grim0000/oreo/docs/img/cad_bottom_cover.png

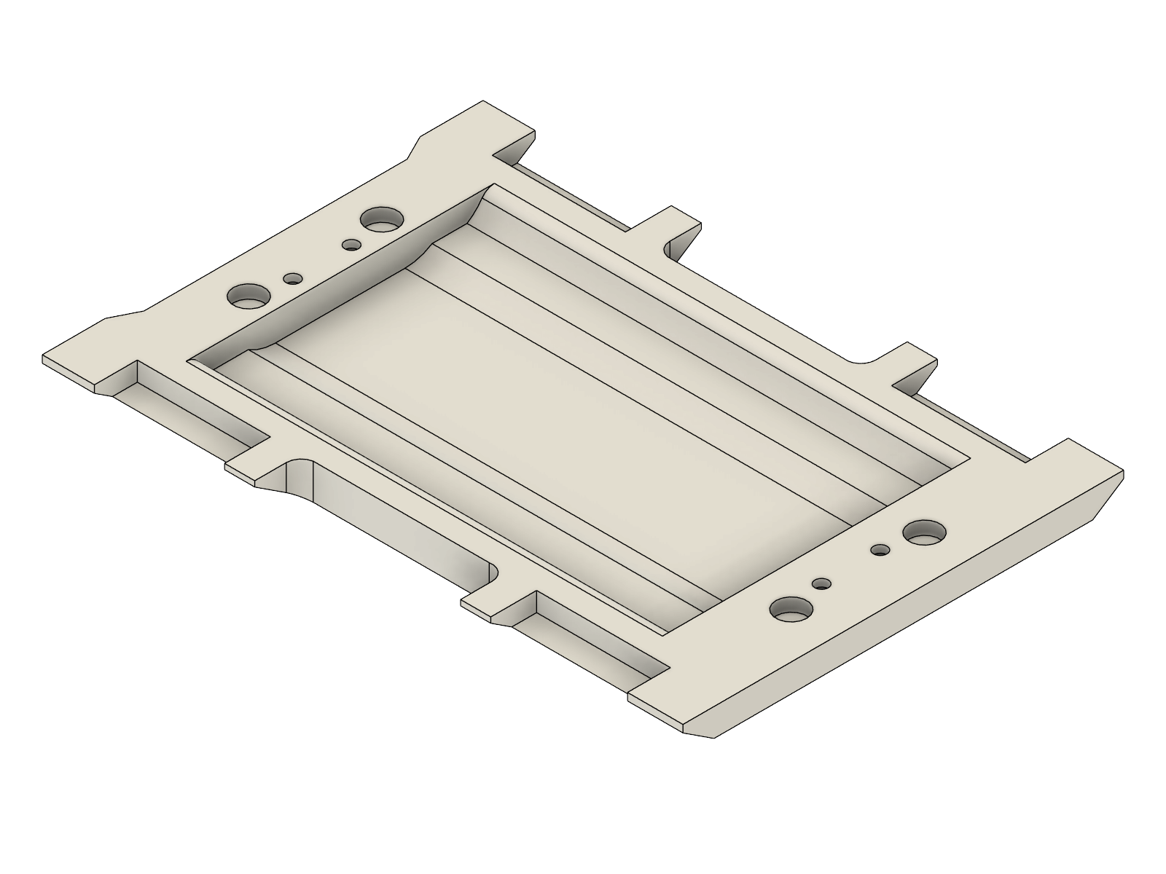
docs/img/cad_bottom_cover.png
