grim0000/oreo/docs/img/cad_chassis_cavity.png

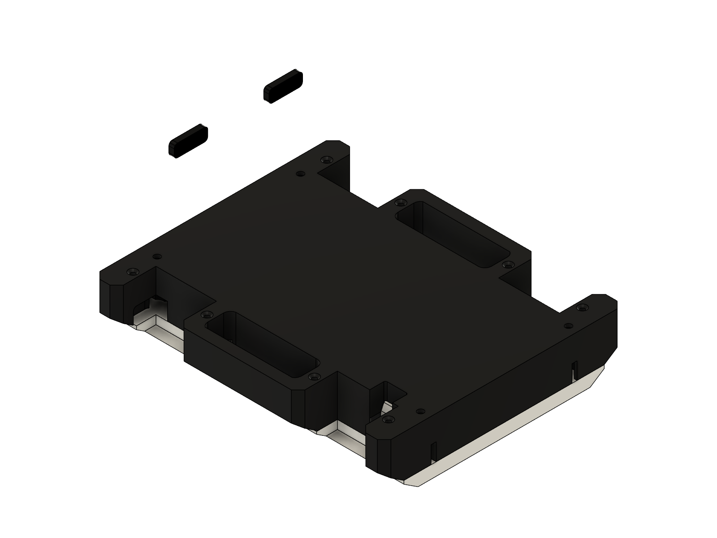
docs/img/cad_chassis_cavity.png
