grim0000/oreo/docs/img/cad_chassis_cavity_top.png

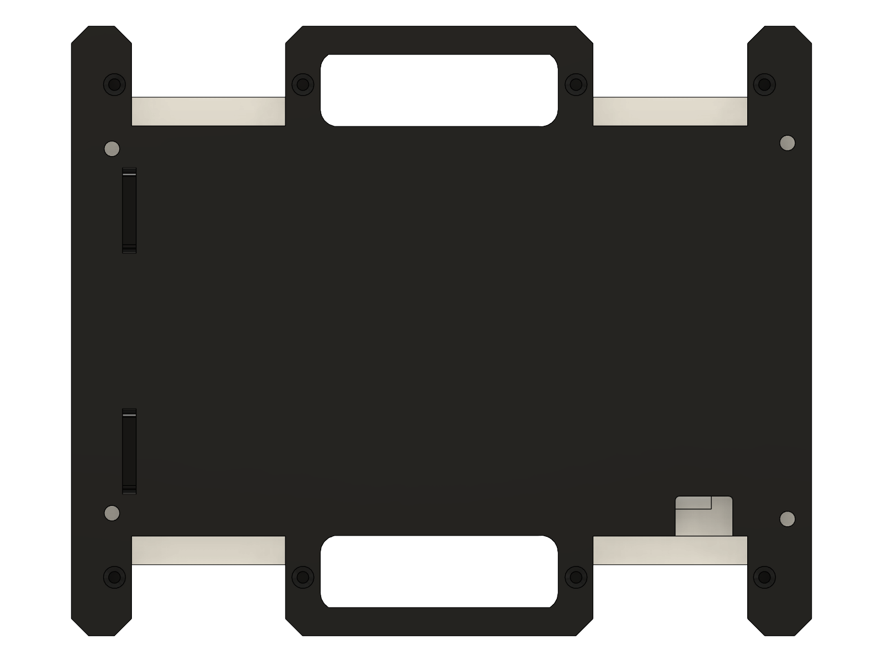
docs/img/cad_chassis_cavity_top.png
