grim0000/oreo/docs/img/cad_chassis_shell_top.png

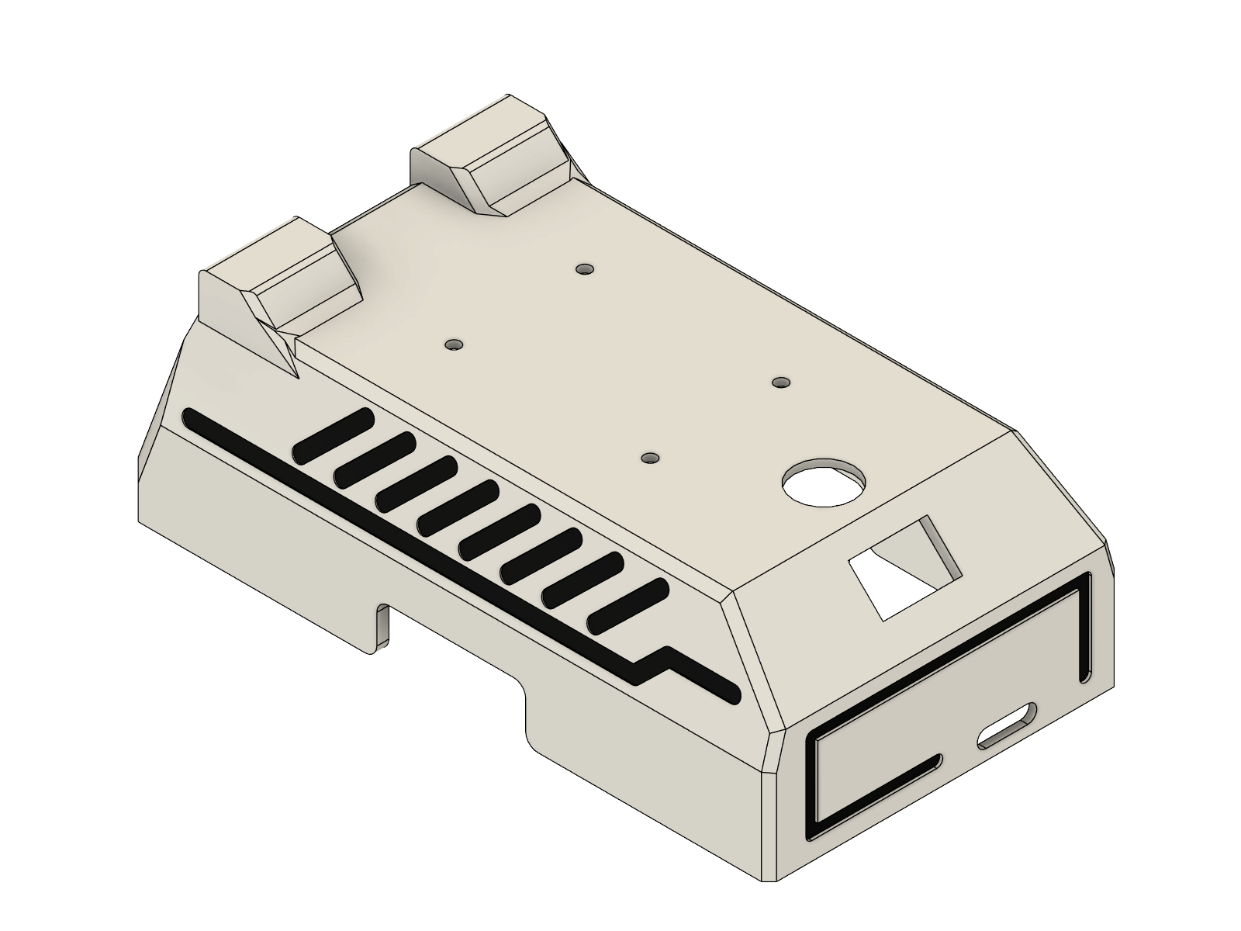
docs/img/cad_chassis_shell_top.png
