grim0000/oreo/docs/img/cad_chassis_shell_under.png

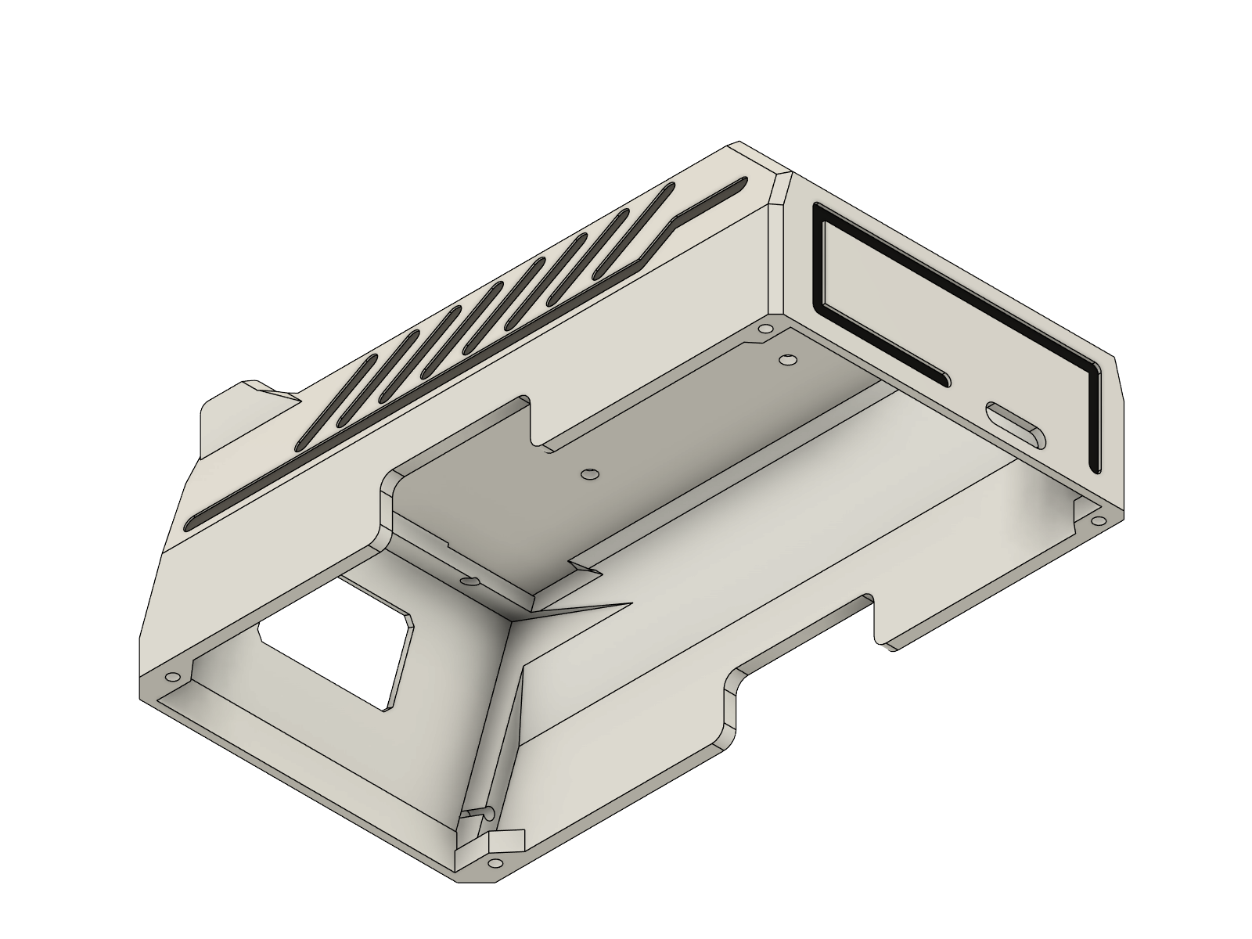
docs/img/cad_chassis_shell_under.png
