grim0000/oreo/docs/img/cad_head_back.png

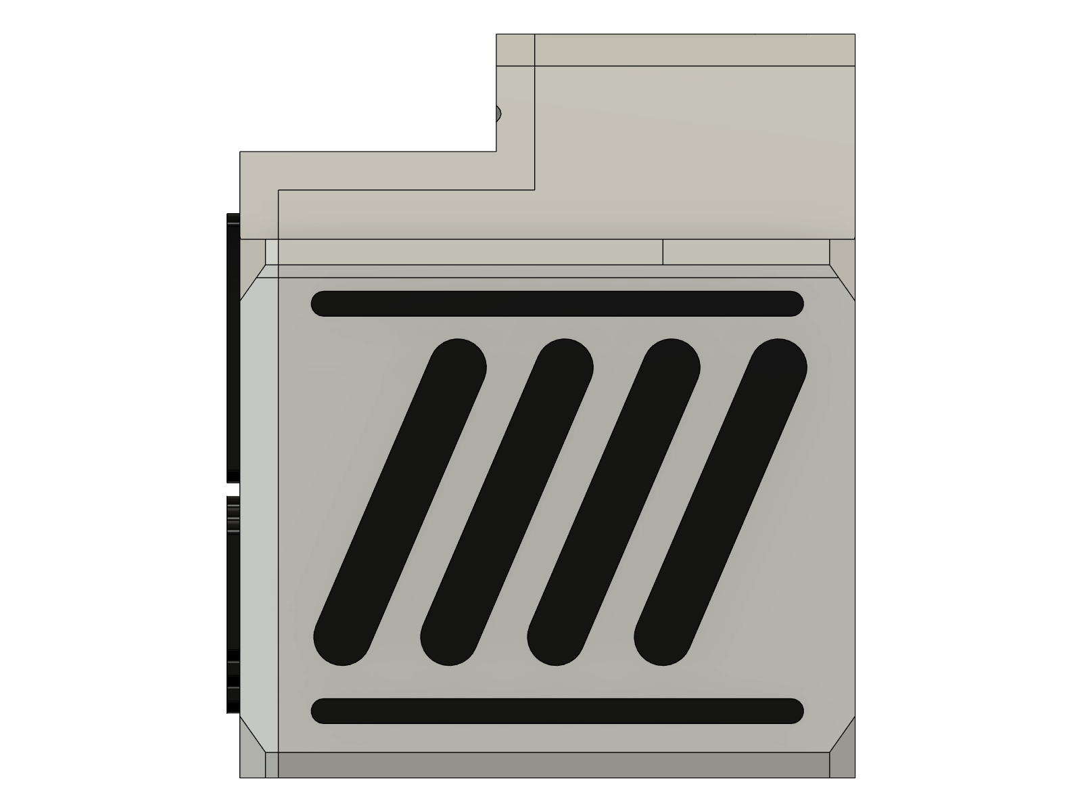
docs/img/cad_head_back.png
