grim0000/oreo/docs/img/cad_head_bottom.png

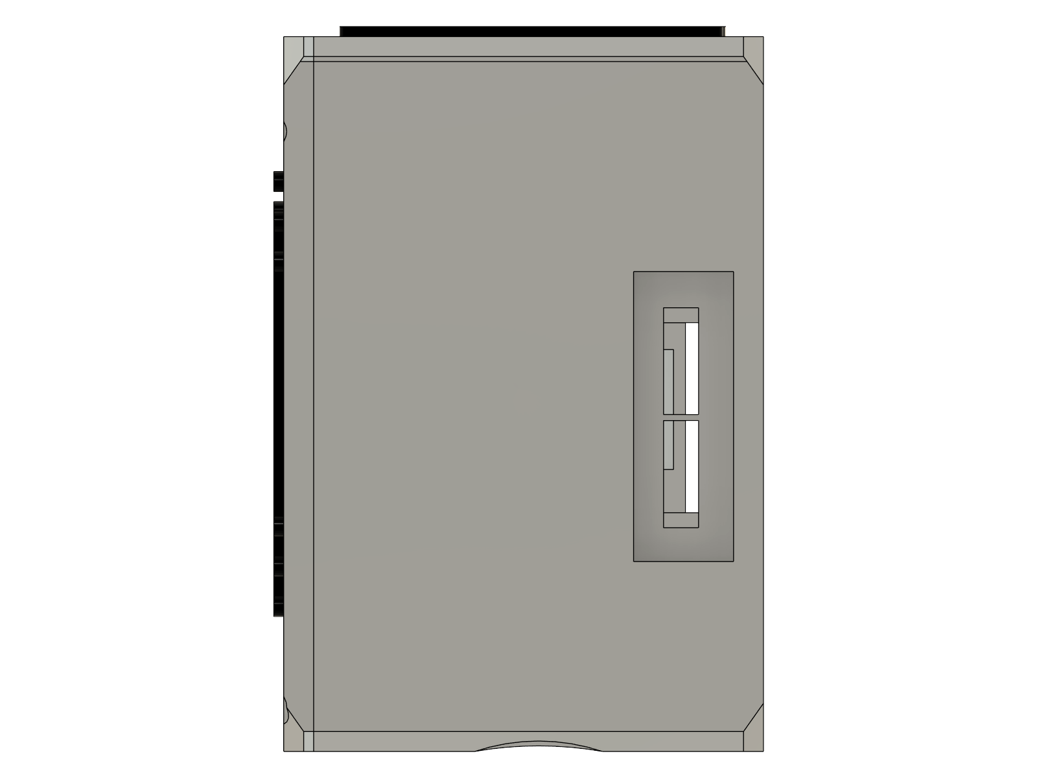
docs/img/cad_head_bottom.png
