grim0000/oreo/docs/img/cad_head_left.png

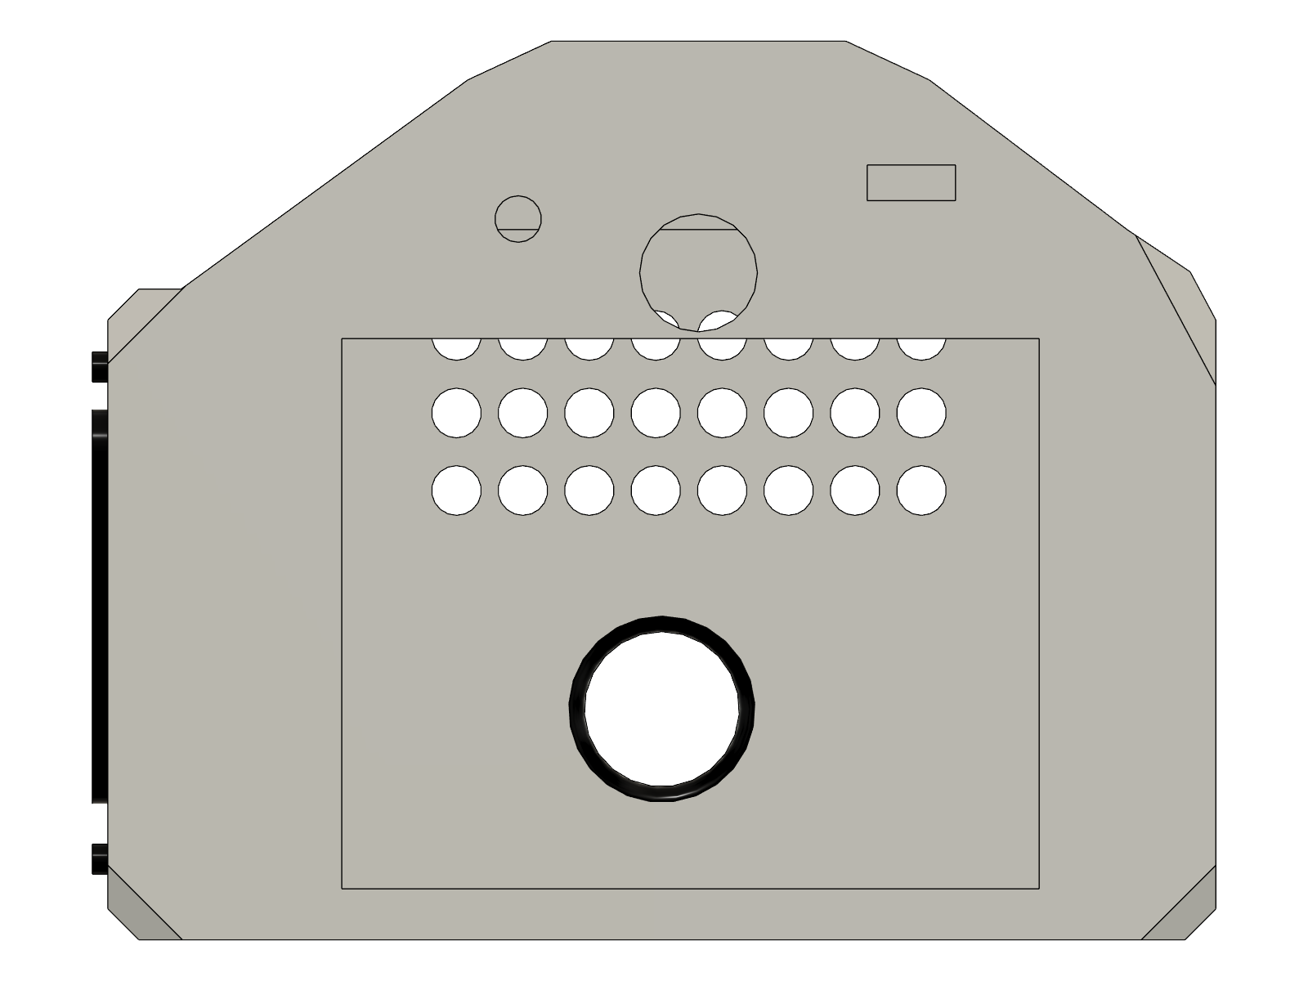
docs/img/cad_head_left.png
