grim0000/oreo/docs/img/cad_head_right.png

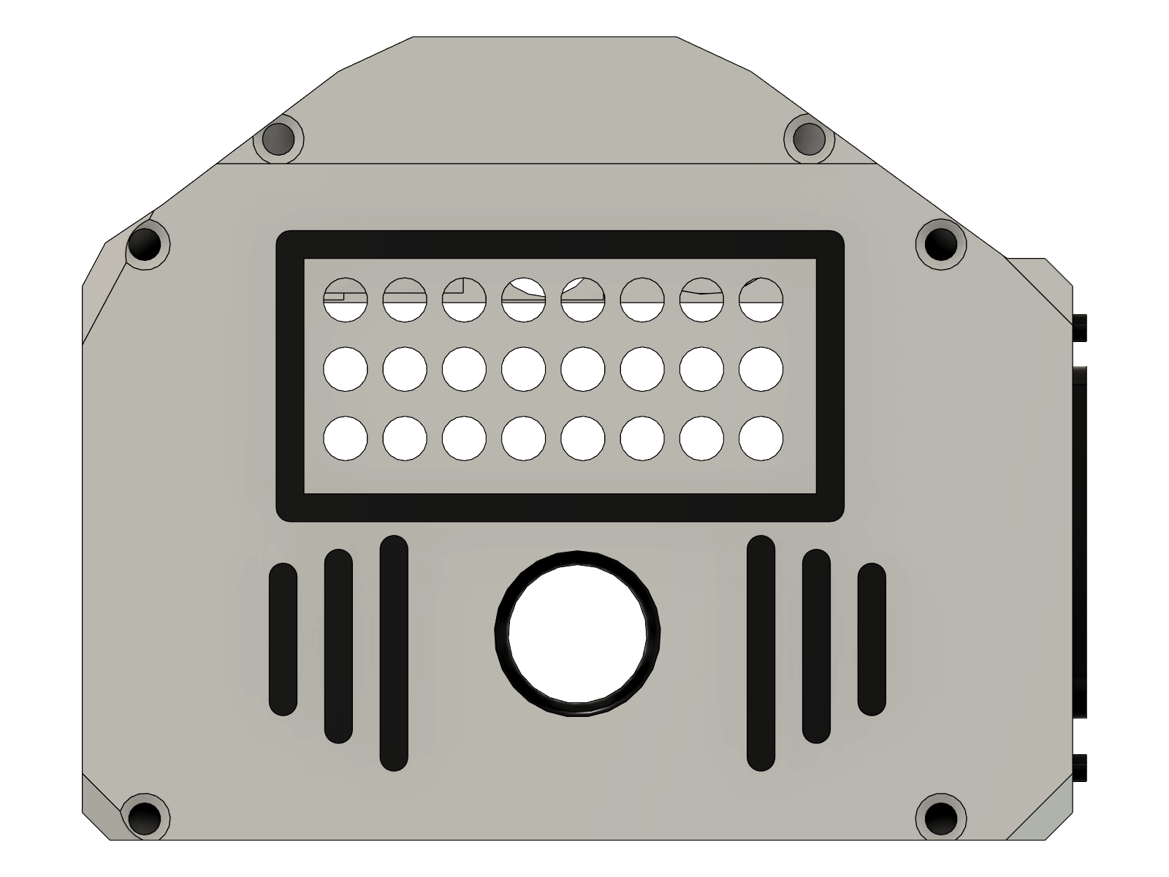
docs/img/cad_head_right.png
