grim0000/oreo/docs/img/cad_legs.png

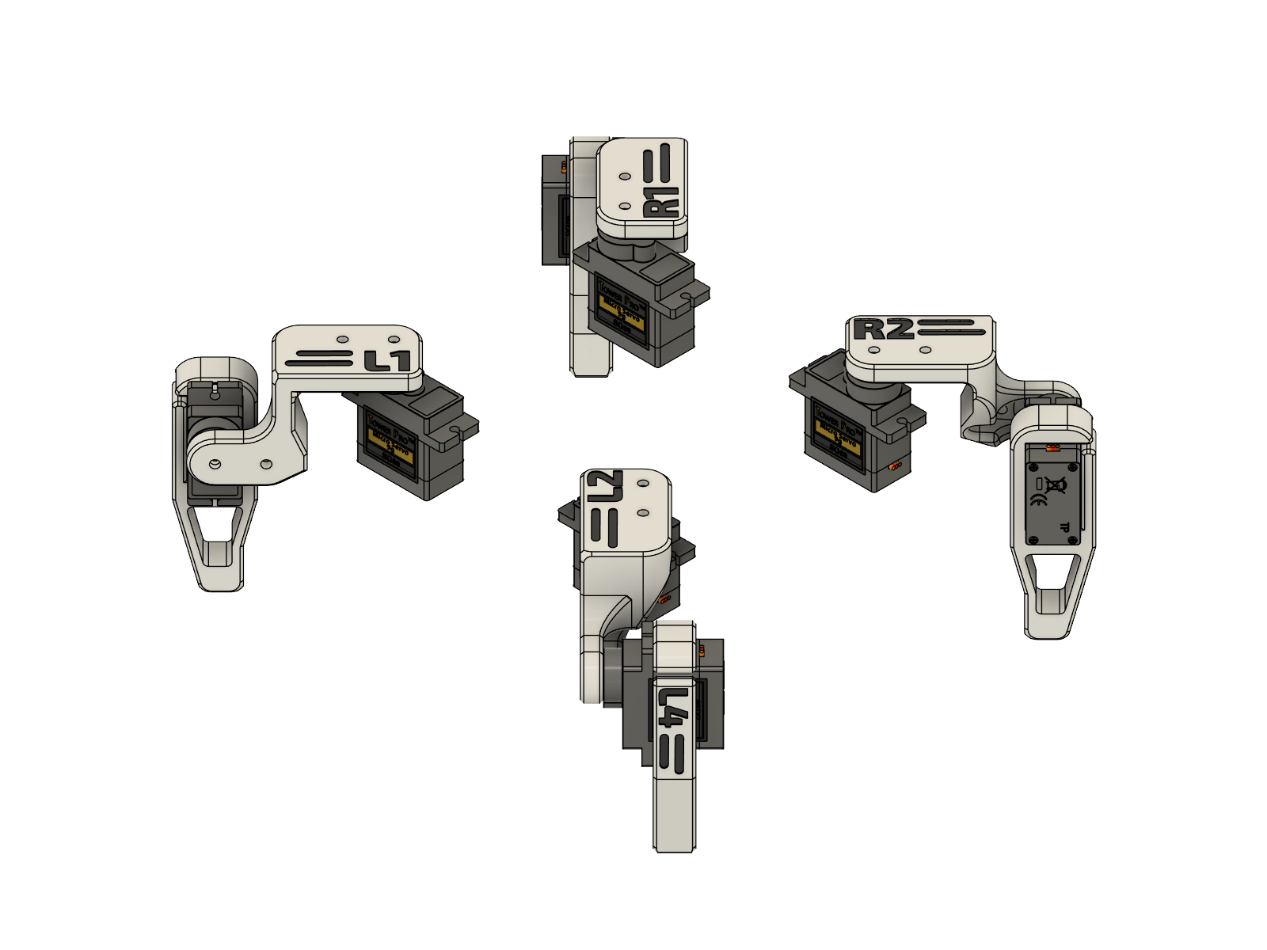
docs/img/cad_legs.png
