grim0000/oreo/docs/img/cad_neck.png

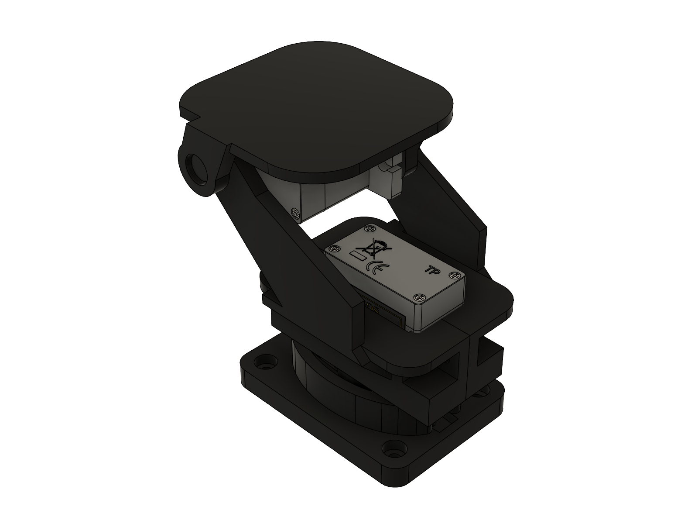
docs/img/cad_neck.png
