grim0000/oreo/docs/img/cad_oreo_front.png

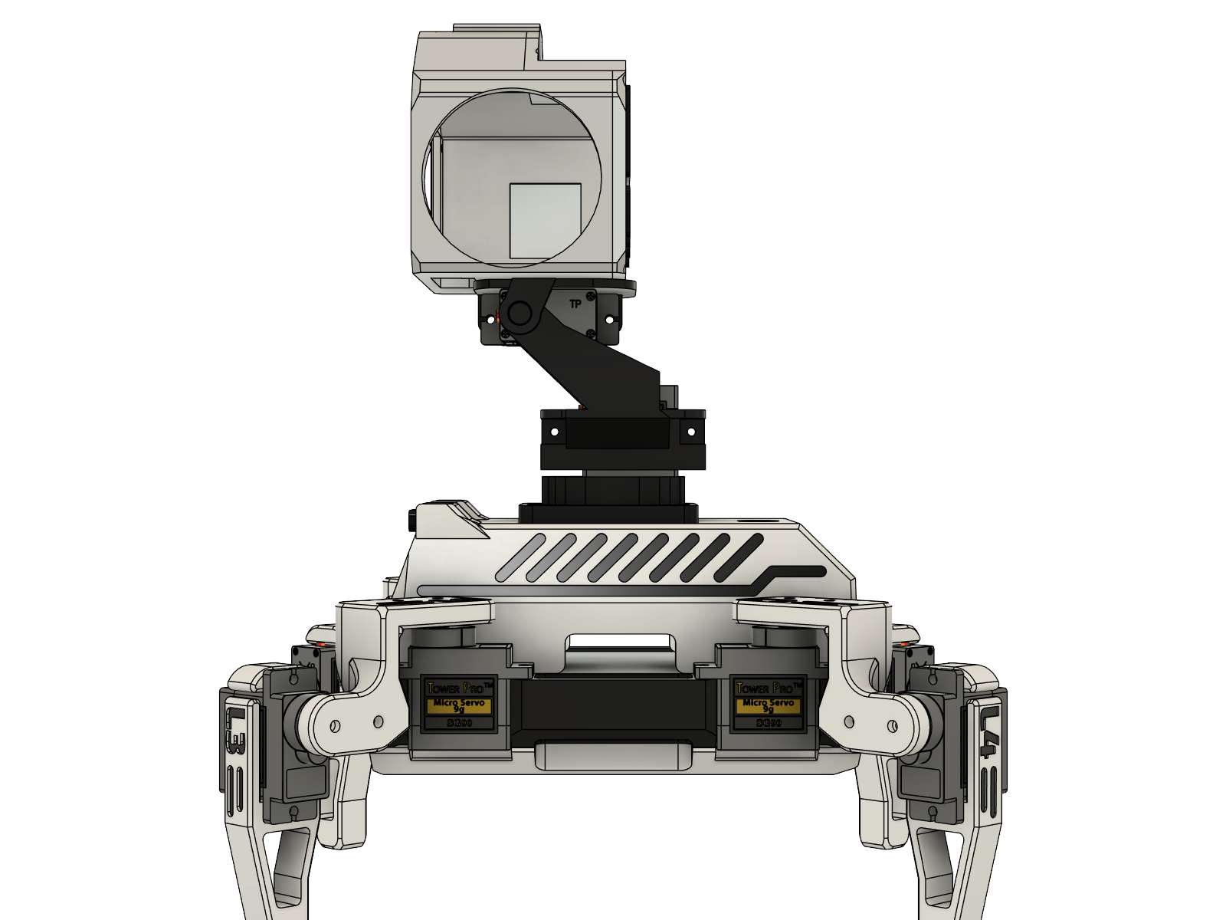
docs/img/cad_oreo_front.png
