grim0000/oreo/docs/img/cad_oreo_side.png

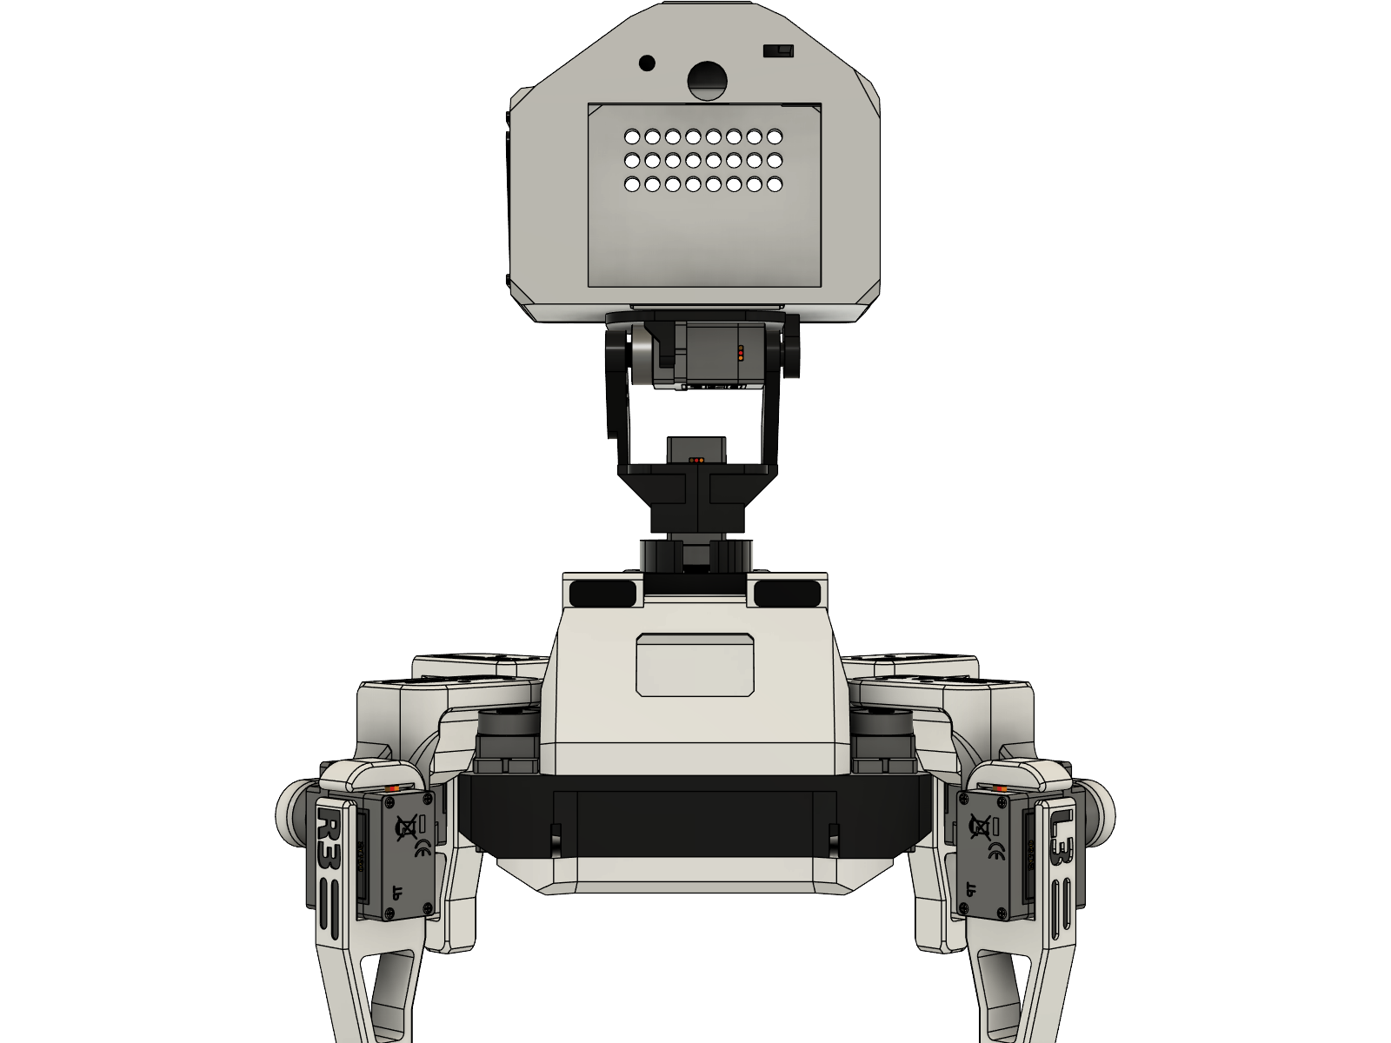
docs/img/cad_oreo_side.png
