grim0000/oreo/docs/tools/module_png/amp.png

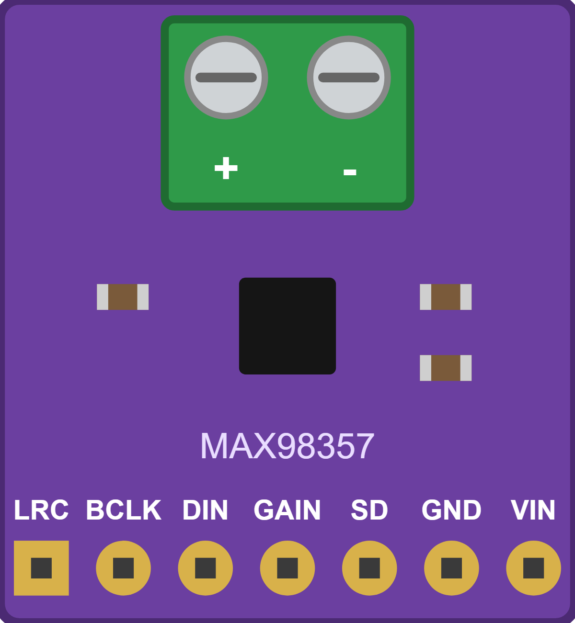
docs/tools/module_png/amp.png
