grim0000/oreo/docs/tools/module_png/battery.png

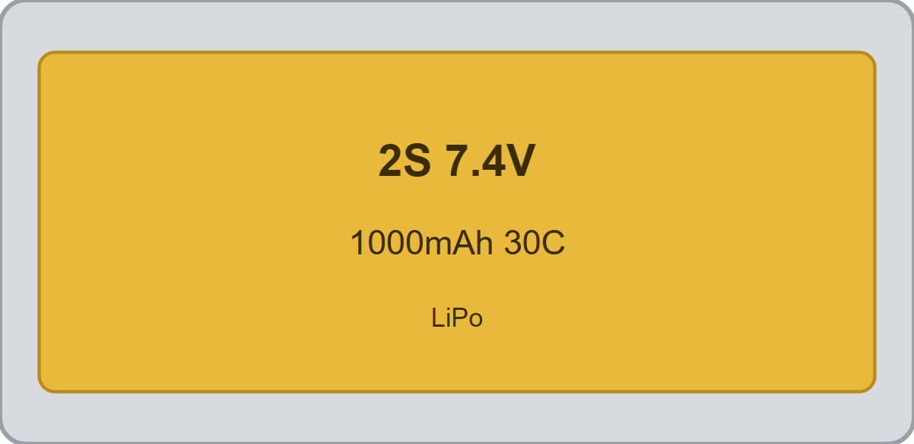
docs/tools/module_png/battery.png
