grim0000/oreo/docs/tools/module_png/bms.png

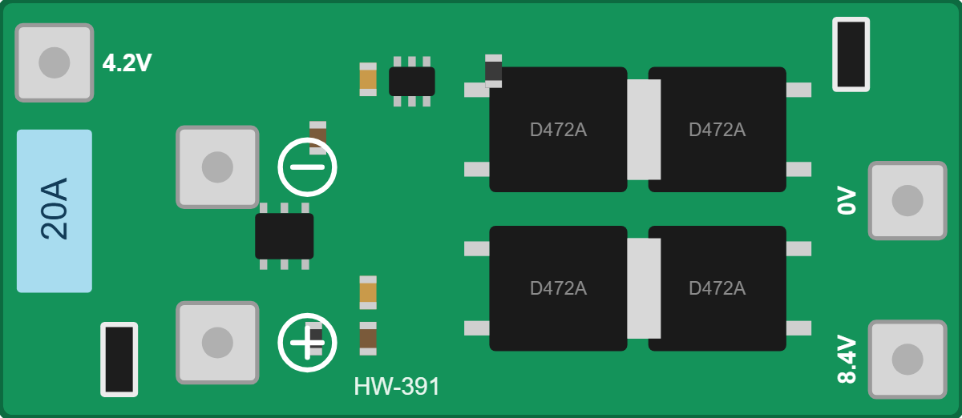
docs/tools/module_png/bms.png
