grim0000/oreo/docs/tools/module_png/buck5v.png

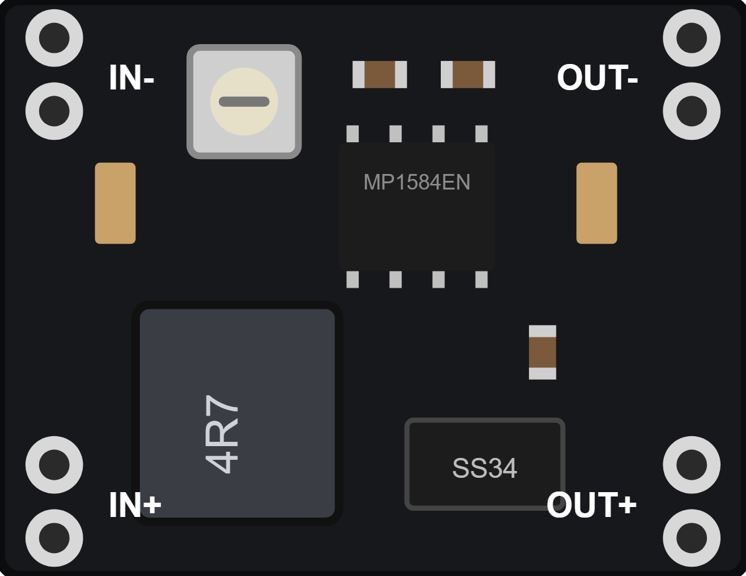
docs/tools/module_png/buck5v.png
