grim0000/oreo/docs/tools/module_png/charger.png

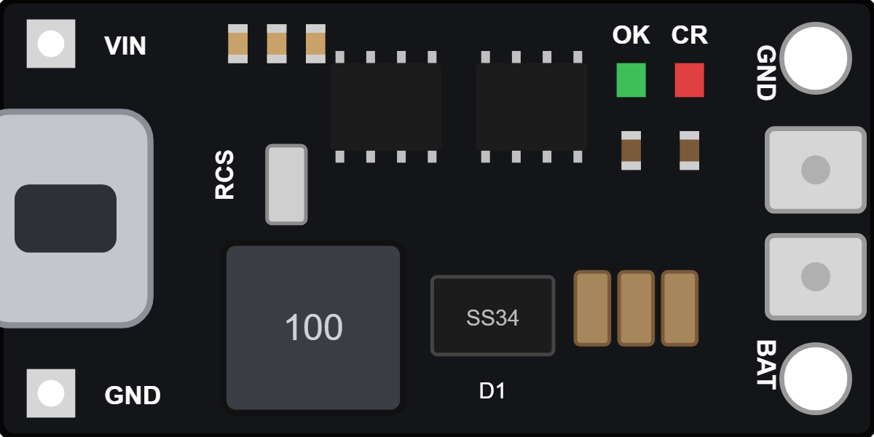
docs/tools/module_png/charger.png
