grim0000/oreo/docs/tools/module_png/display_back.png

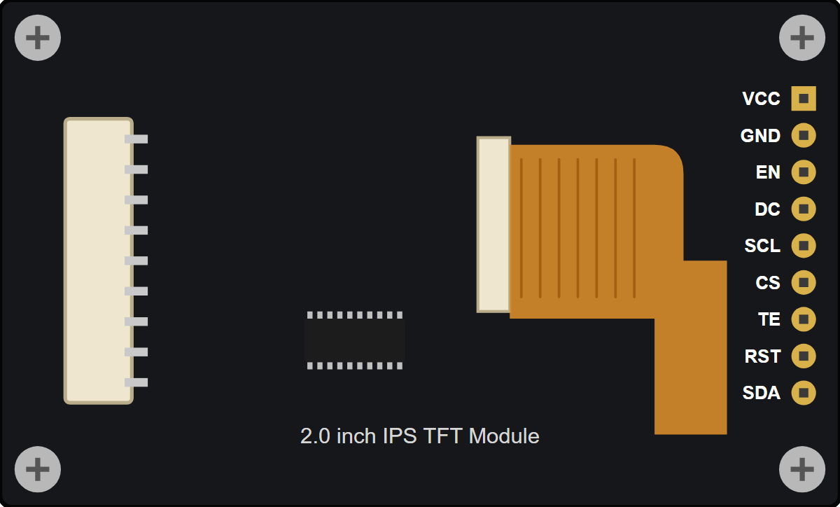
docs/tools/module_png/display_back.png
