grim0000/oreo/docs/tools/module_png/mpu6050.png

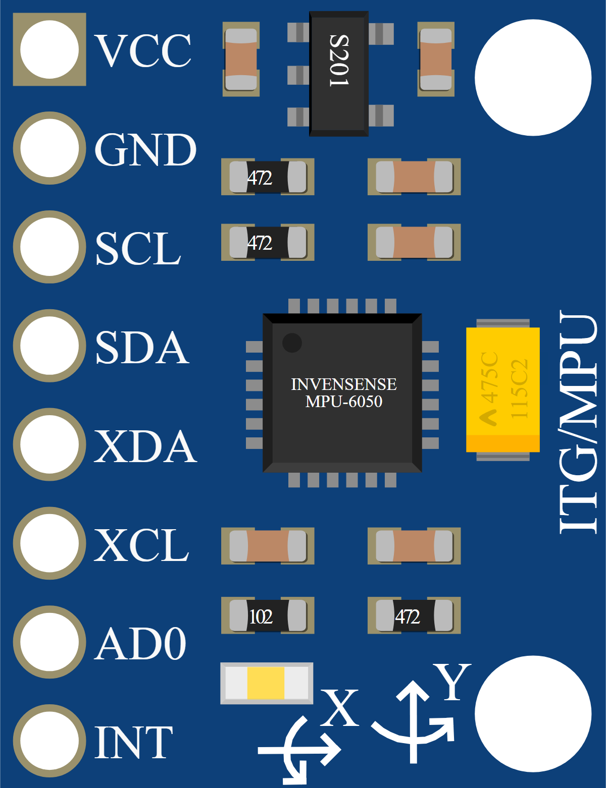
docs/tools/module_png/mpu6050.png
