grim0000/oreo/docs/tools/module_png/oled.png

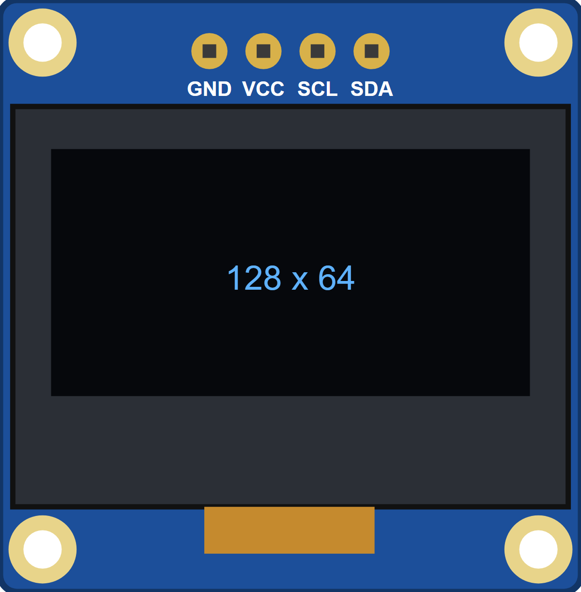
docs/tools/module_png/oled.png
