grim0000/oreo/docs/tools/module_png/pca9685.png

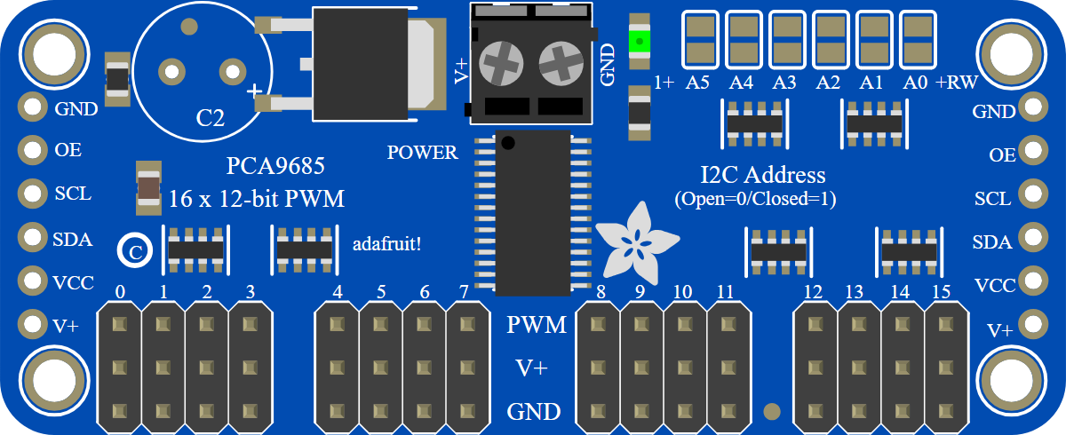
docs/tools/module_png/pca9685.png
