grim0000/oreo/docs/tools/module_png/pca9685_g.png

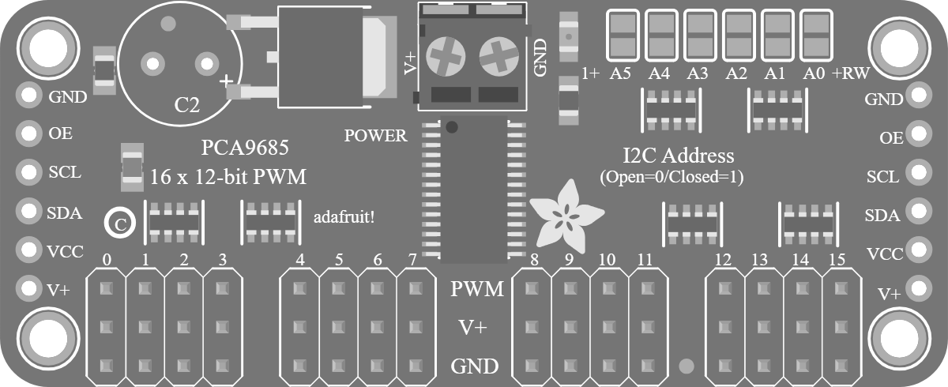
docs/tools/module_png/pca9685_g.png
