grim0000/oreo/docs/tools/module_png/rocker.png

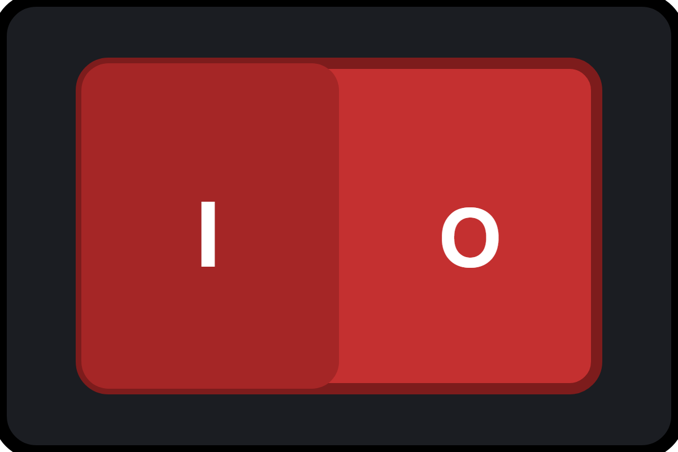
docs/tools/module_png/rocker.png
