grim0000/oreo/docs/tools/module_png/s3.png

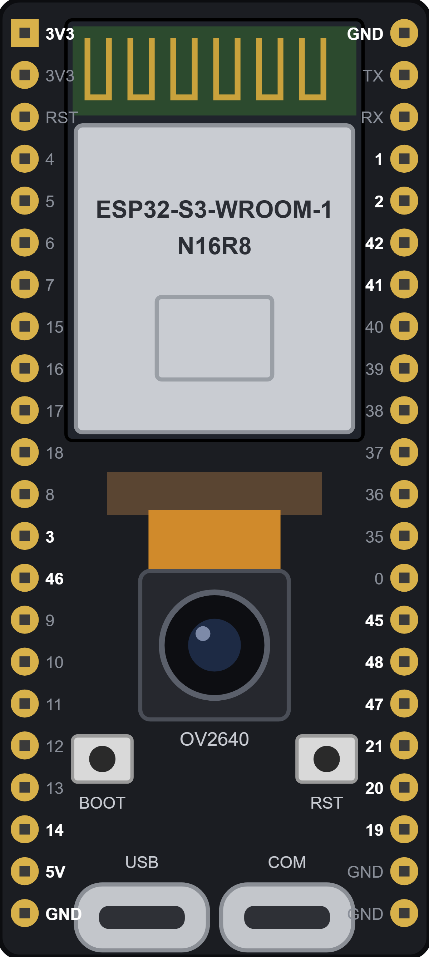
docs/tools/module_png/s3.png
