grim0000/oreo/docs/tools/module_png/tof.png

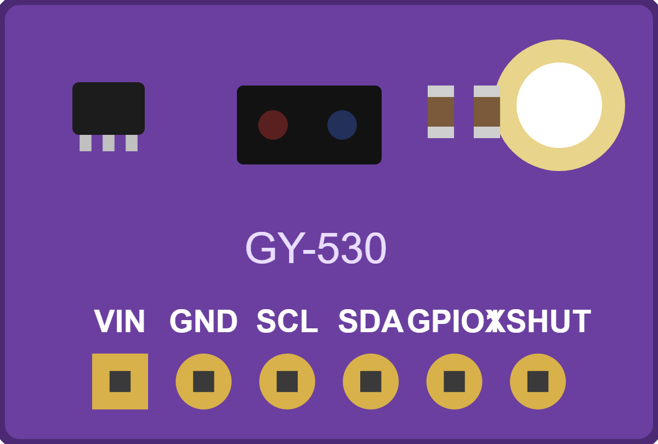
docs/tools/module_png/tof.png
