grim0000/oreo/docs/tools/module_png/touch.png

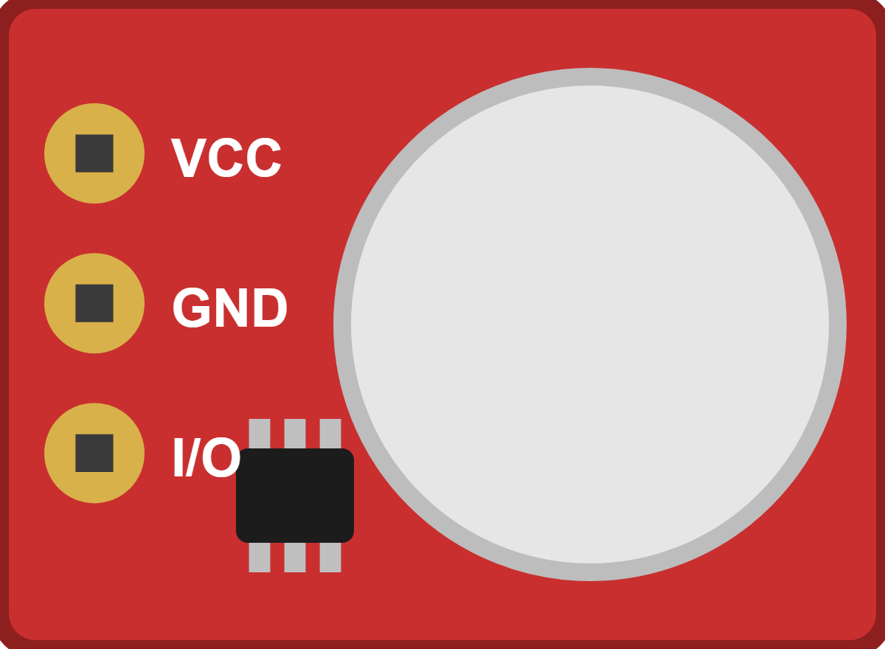
docs/tools/module_png/touch.png
