grim0000/oreo/docs/tools/module_png/xl4015.png

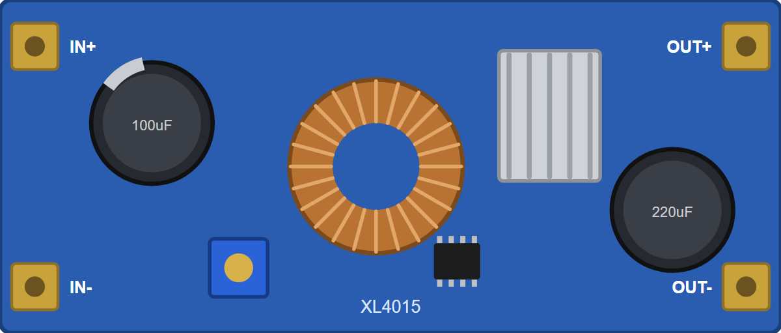
docs/tools/module_png/xl4015.png
