grim0000/oreo/firmware/assets/sprites.webp

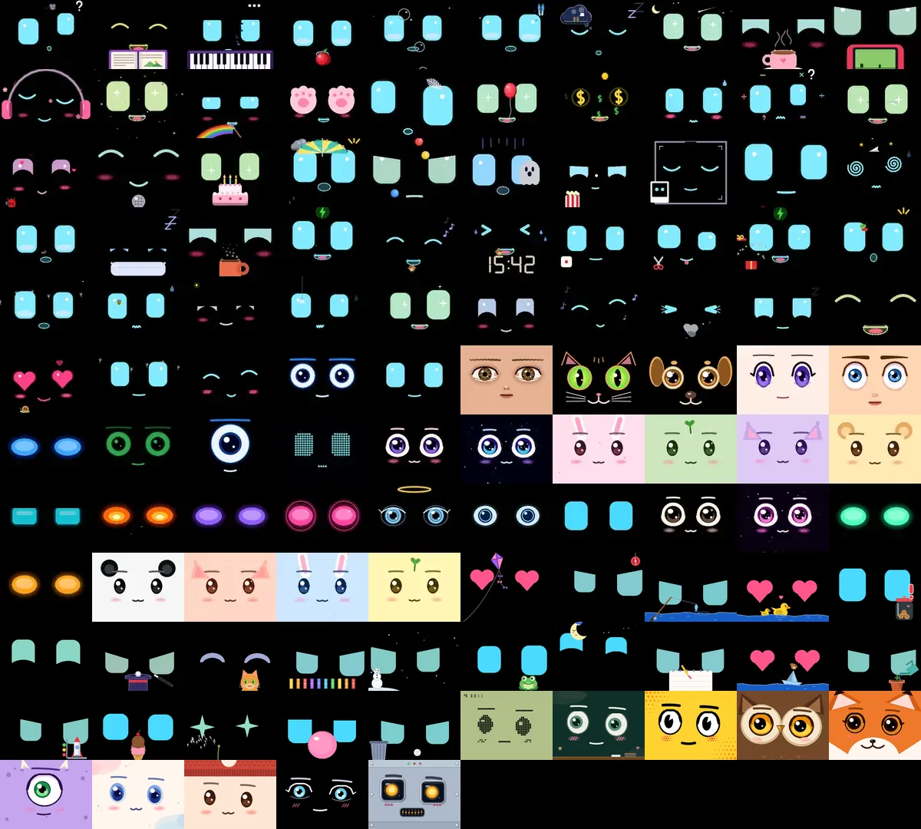
firmware/assets/sprites.webp
