grim0000/oreo/hardware/assembly_parts/neck_pan_bracket.stl

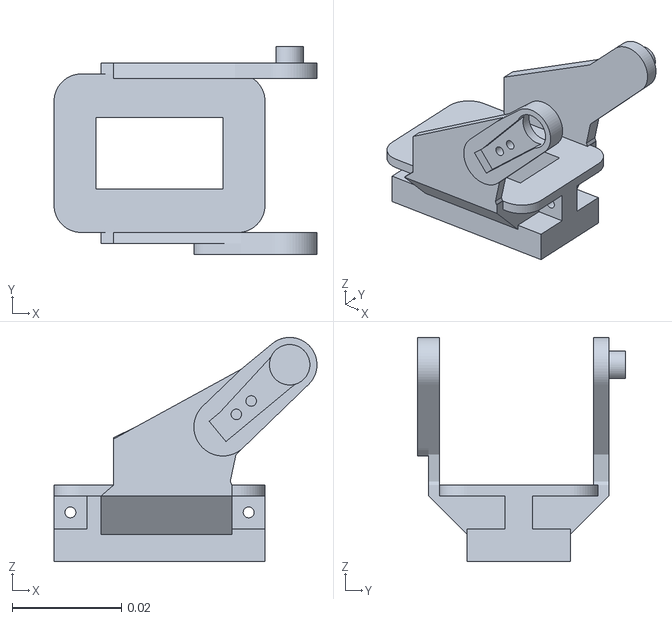
[picture p49: CAD file, 2026-11-04]
hardware/assembly_parts/neck_pan_bracket.stl
0.0481 x 0.038 x 0.041
