grim0000/oreo/hardware/assembly_parts/servos_reference/hip_servo_4.stl

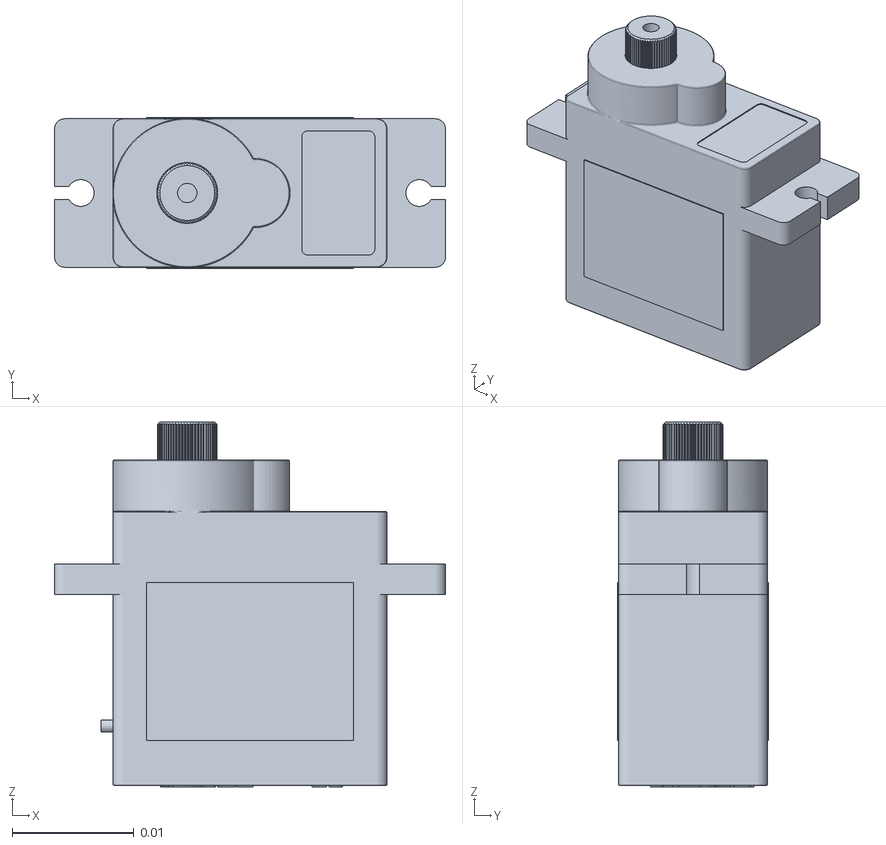
[picture p50: CAD file, 2026-10-31]
hardware/assembly_parts/servos_reference/hip_servo_4.stl
0.0321 x 0.0124 x 0.03
