grim0000/oreo/hardware/Oreo_all_parts.3mf

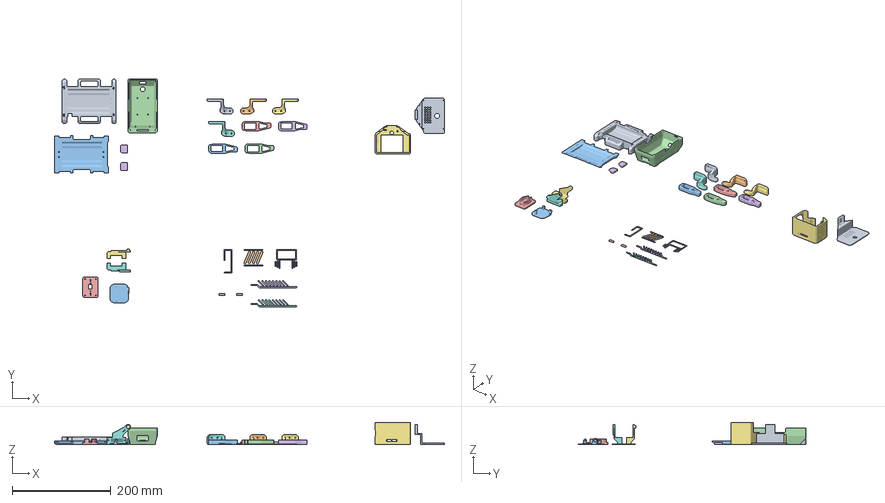
[picture p51: CAD file, 2026-11-04]
hardware/Oreo_all_parts.3mf
788.4 x 460.4 x 45.0 mm
head_shell
head_side_plate
neck_tilt_plate
top_shell_A
neck_base
chest_strips_left
head_front_plate
chest_strips_right
middle_block
head_bezel
bottom_cover
chest_back_plate
chassis_trim
top_shell_B
FR_femur
FL_femur
RR_femur
RL_femur
FR_foot
FL_foot
RR_foot
RL_foot
neck_pan_bracket_1
neck_pan_bracket_2
