grim0000/oreo/hardware/assembly_parts/FR_foot.stl

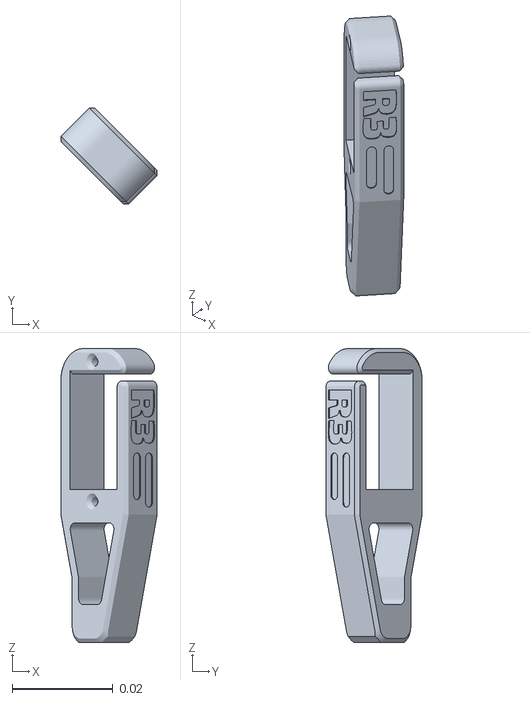
[picture p52: CAD file, 2026-11-02]
hardware/assembly_parts/FR_foot.stl
0.0191 x 0.0191 x 0.0584
