grim0000/oreo/hardware/assembly_parts/servos_reference/FL_knee_servo.stl

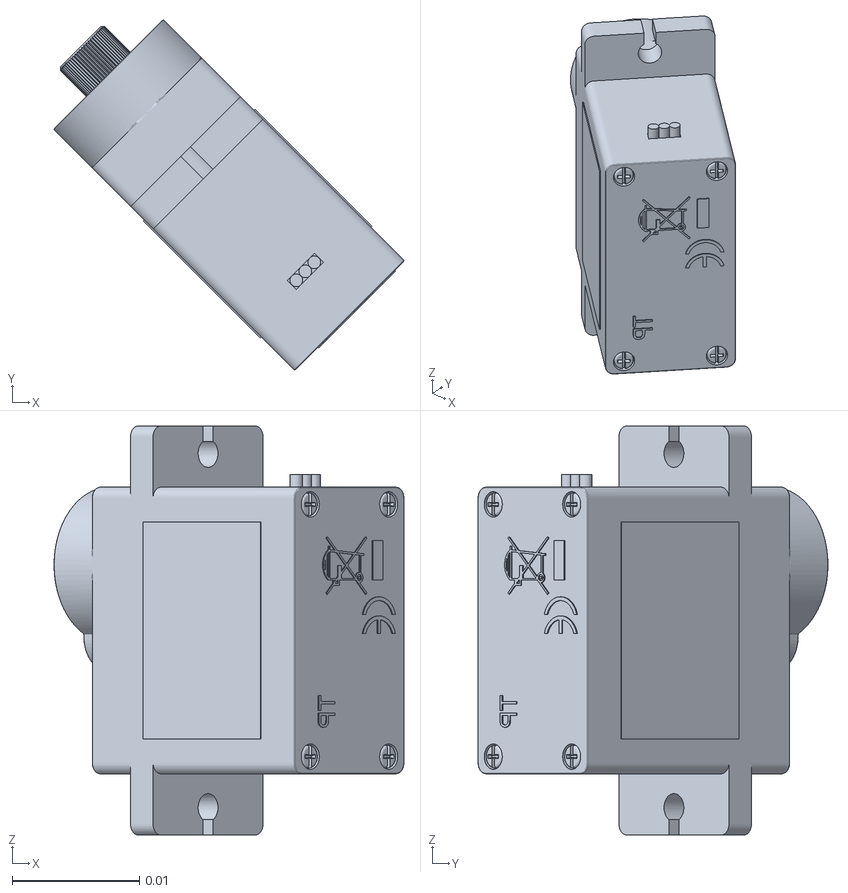
[picture p53: CAD file, 2026-10-31]
hardware/assembly_parts/servos_reference/FL_knee_servo.stl
0.0275 x 0.0275 x 0.0321
