grim0000/oreo/hardware/assembly_parts/servos_reference/tilt_servo.stl

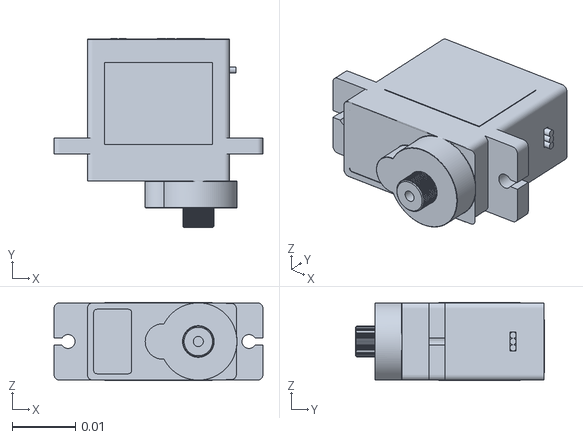
[picture p54: CAD file, 2026-10-31]
hardware/assembly_parts/servos_reference/tilt_servo.stl
0.033 x 0.0299 x 0.0124
