grim0000/oreo/hardware/assembly_parts/FR_femur.stl

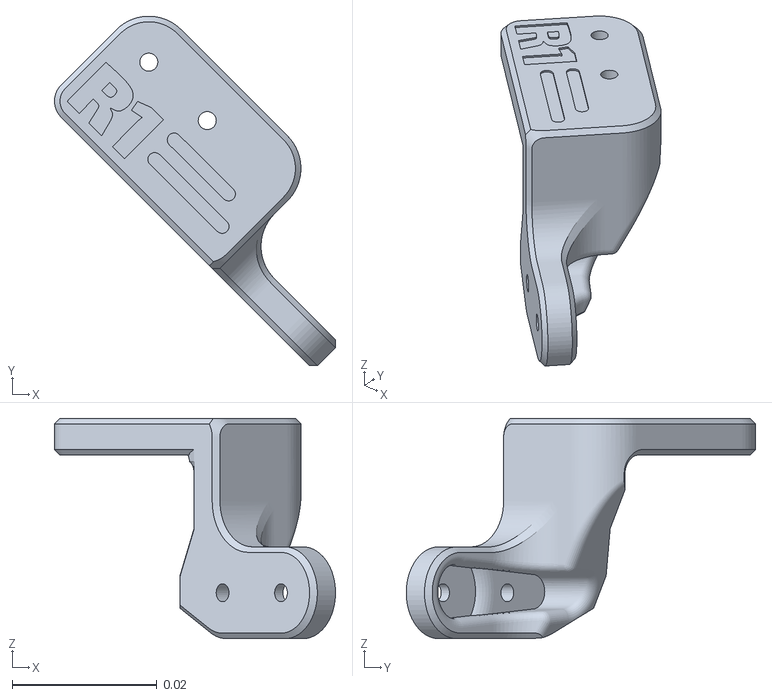
[picture p55: CAD file, 2026-11-02]
hardware/assembly_parts/FR_femur.stl
0.0389 x 0.0483 x 0.0305
