grim0000/oreo/hardware/assembly_parts/head_side_plate.stl

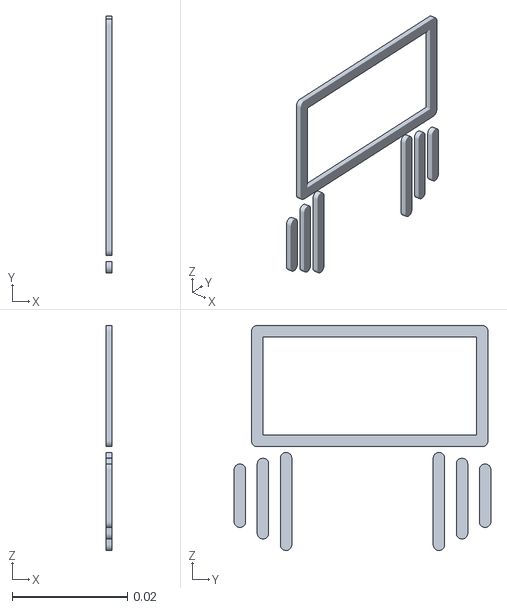
[picture p56: CAD file, 2026-10-31]
hardware/assembly_parts/head_side_plate.stl
0.001 x 0.0445 x 0.039
