grim0000/oreo/hardware/assembly_parts/top_shell.stl

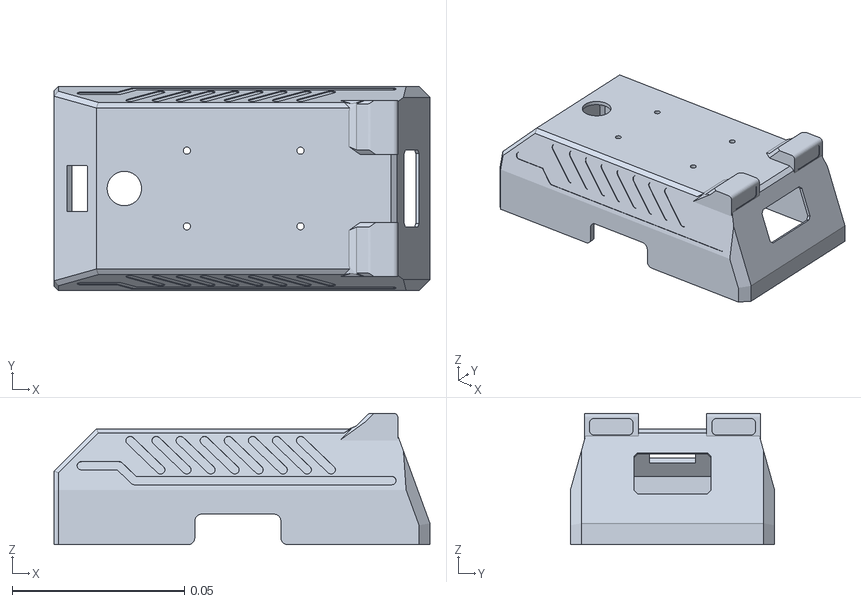
[picture p57: CAD file, 2026-10-31]
hardware/assembly_parts/top_shell.stl
0.109 x 0.0593 x 0.0382
