grim0000/oreo/hardware/assembly_parts/chest_back_plate.stl

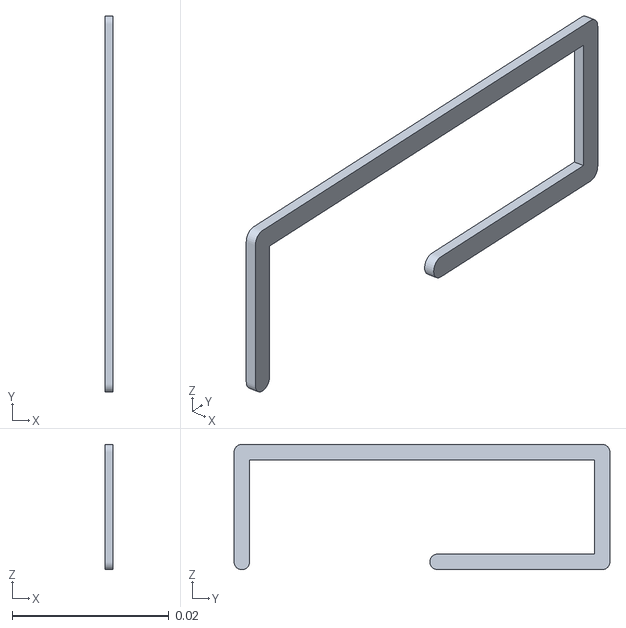
[picture p58: CAD file, 2026-10-31]
hardware/assembly_parts/chest_back_plate.stl
0.001 x 0.048 x 0.016
