grim0000/oreo/hardware/assembly_parts/chest_strips_right.stl

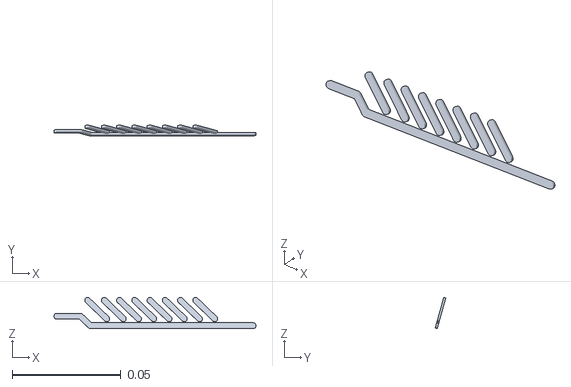
[picture p59: CAD file, 2026-10-31]
hardware/assembly_parts/chest_strips_right.stl
0.0927 x 0.00492 x 0.0143
