grim0000/oreo/hardware/assembly_parts/neck_tilt_plate.stl

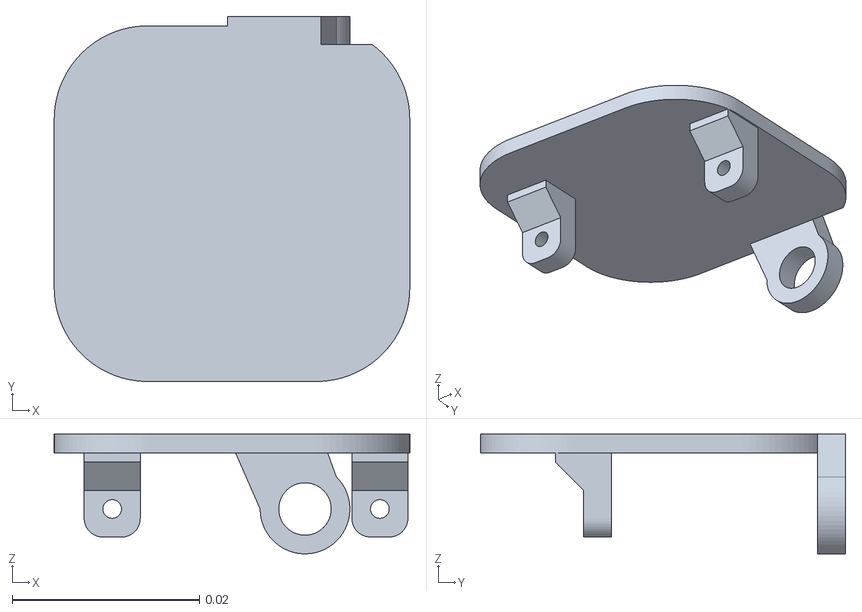
[picture p60: CAD file, 2026-10-31]
hardware/assembly_parts/neck_tilt_plate.stl
0.038 x 0.039 x 0.0128
