grim0000/oreo/hardware/assembly_parts/middle_block.stl

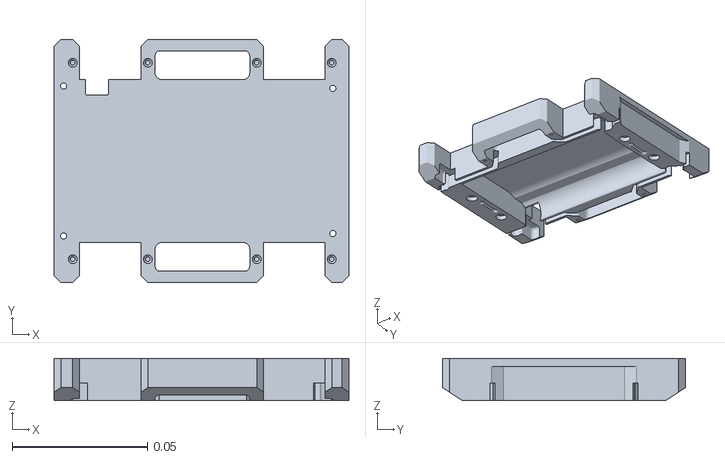
[picture p61: CAD file, 2026-10-31]
hardware/assembly_parts/middle_block.stl
0.109 x 0.09 x 0.0157
