grim0000/oreo/hardware/assembly_parts/head_shell.stl

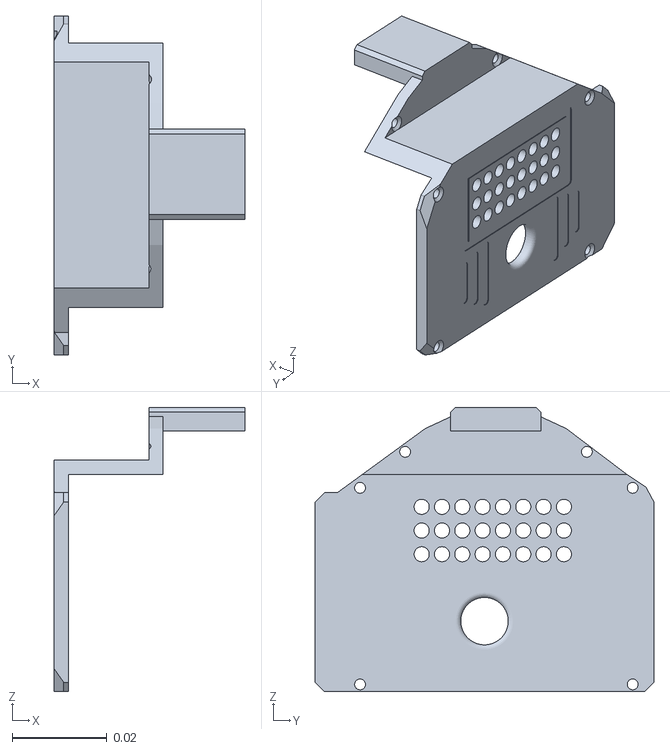
[picture p62: CAD file, 2026-10-31]
hardware/assembly_parts/head_shell.stl
0.0402 x 0.0715 x 0.06
