grim0000/oreo/hardware/assembly_parts/head_front_plate.stl

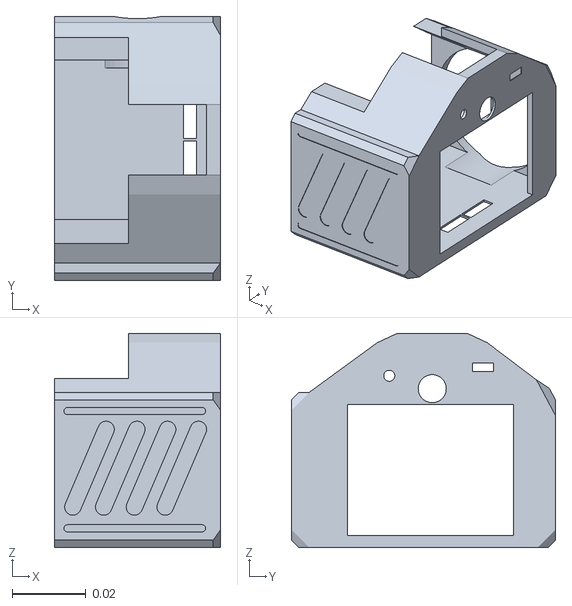
[picture p63: CAD file, 2026-10-31]
hardware/assembly_parts/head_front_plate.stl
0.045 x 0.0715 x 0.058
