grim0000/oreo/hardware/assembly_parts/neck_base.stl

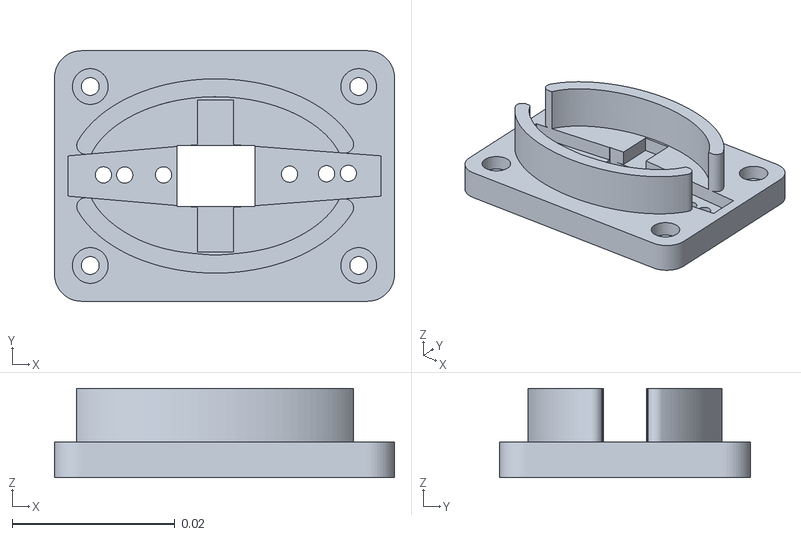
[picture p64: CAD file, 2026-10-31]
hardware/assembly_parts/neck_base.stl
0.0418 x 0.0308 x 0.011
