grim0000/oreo/hardware/assembly_parts/bottom_cover.stl

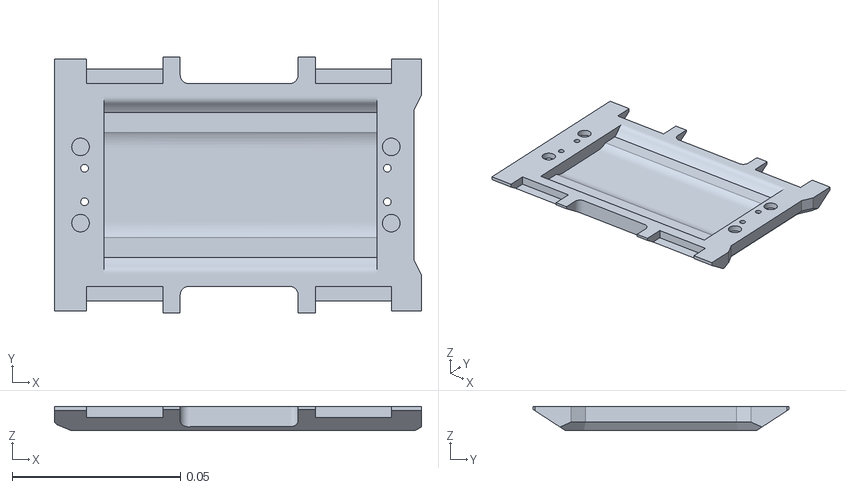
[picture p65: CAD file, 2026-10-31]
hardware/assembly_parts/bottom_cover.stl
0.109 x 0.0762 x 0.00727
