grim0000/oreo/hardware/assembly_parts/chassis_trim.stl

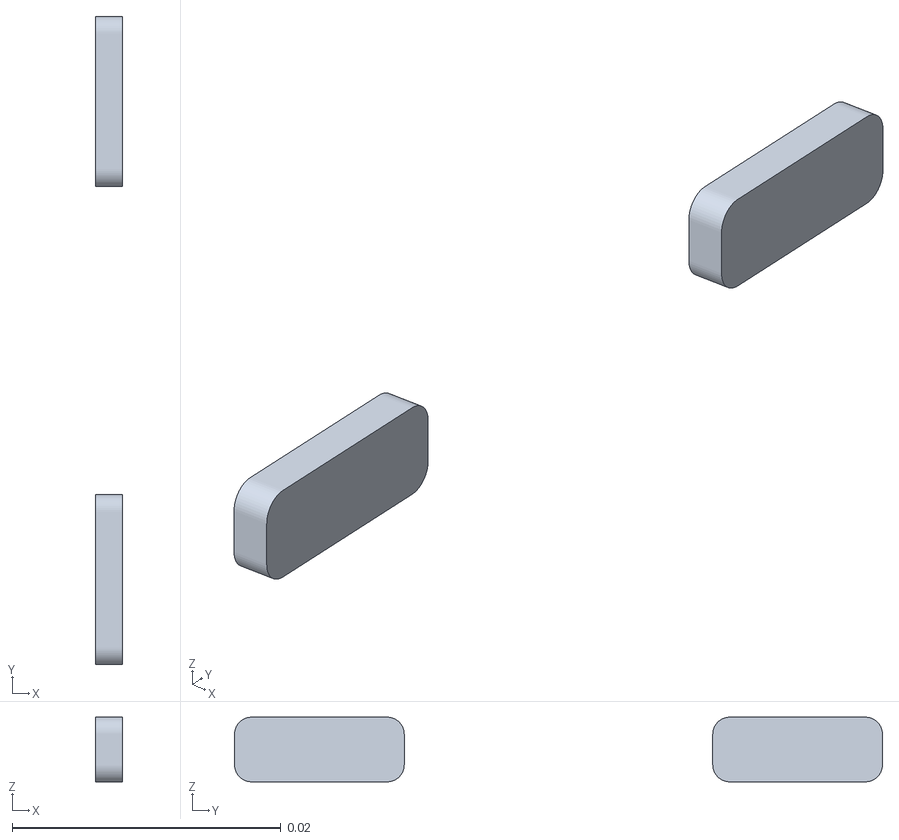
[picture p66: CAD file, 2026-10-31]
hardware/assembly_parts/chassis_trim.stl
0.002 x 0.0482 x 0.00481
