grim0000/oreo/hardware/assembly_parts/head_bezel.stl

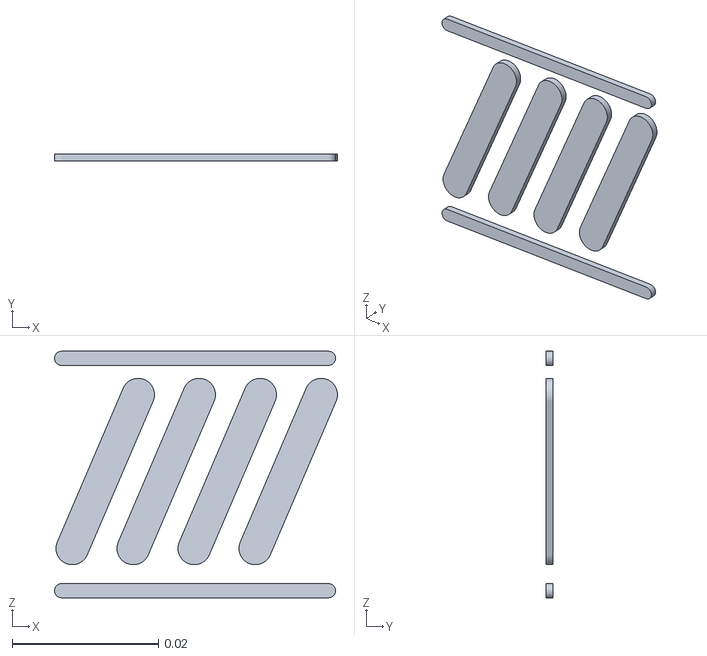
[picture p67: CAD file, 2026-10-31]
hardware/assembly_parts/head_bezel.stl
0.0387 x 0.001 x 0.0337
