grim0000/oreo/(list of files, cad)

Other CAD files:
hardware/assembly_parts/RL_foot.stl
hardware/assembly_parts/servos_reference/hip_servo_1.stl
hardware/assembly_parts/RR_foot.stl
hardware/assembly_parts/servos_reference/hip_servo_2.stl
hardware/assembly_parts/RR_femur.stl
hardware/assembly_parts/servos_reference/hip_servo_3.stl
hardware/assembly_parts/RL_femur.stl
hardware/assembly_parts/servos_reference/pan_servo.stl
hardware/assembly_parts/FL_femur.stl
hardware/assembly_parts/servos_reference/FR_knee_servo.stl
hardware/assembly_parts/FL_foot.stl
hardware/assembly_parts/servos_reference/RR_knee_servo.stl
hardware/assembly_parts/servos_reference/RL_knee_servo.stl
hardware/assembly_parts/chest_strips_left.stl
hardware/Oreo(sesame_remixed).f3d
