grim0000/oreo/firmware/calibrate.html

← Back to controller

# 🍪 Oreo Servo Calibrator

ESP32 IP: Test Connection Waiting...

Servo | Pin | Sweep | Controls | Capture Min | Capture Mid | Capture Max

Sweep Speed: 20ms

🌊 Toggle Sweep All Set All Mid Set All Min Set All Max 💾 Export Configuration ⬆ Save to robot ↺ Reset to built-in
