grim0000/oreo/firmware/src/main.cpp

// SPDX-License-Identifier: GPL-3.0-or-later
// Copyright (C) 2026 Sunil J and the Oreo contributors
#include <Arduino.h>
#include "driver/gpio.h"
#include "driver/rtc_io.h"
#include "esp_sleep.h"
#include "esp_core_dump.h"  // a crash saved in flash: logged at the next boot
#include "soc/usb_serial_jtag_reg.h"
#include <WiFi.h>
#include <esp_http_server.h>
#include "esp_camera.h"
#include "img_converters.h"
#include <lwip/sockets.h>
#include "human_face_detect_msr01.hpp"
#include "human_face_detect_mnp01.hpp"  // the second stage: eyes / nose / mouth (face_id.h)
#include <Wire.h>
#include <Adafruit_PWMServoDriver.h>
#include <LovyanGFX.hpp>
#include <Adafruit_SSD1306.h>
#include <Adafruit_VL53L0X.h>
#include <Preferences.h>
#include <SD_MMC.h>
#include <Update.h>
#include "xlog.h"
#include <esp_wifi.h>
#include <esp_netif_sta_list.h>
#include <ping/ping_sock.h>

// The back legs lying down (rest, sit, elegant sit): R4 R3 L3 L4, low enough that the body rests on its
// stomach. GET /cmd?backdown=80,38,84,48 (saved)
int REST_BACK[4] = {72, 44, 78, 56};
extern int tzOffsetSec;  // the clock's timezone (seconds from UTC, defined below; the face engine reads it)
#include "servo_map.h"  // which PCA9685 channel drives which servo (/servomap, saved)
#include "movement-sequences.h"
#include "emotes_more.h"  // more emotes, on the spot
#include "emotes_lib.h"   // the emote library: ~100 more, keyframes

// --- WIFI & AP CREDENTIALS ---
#include <DNSServer.h>
#include "controller_html_gz.h"
#include "audio.h"
#include "talk.h"  // phone mic -> robot speaker (WebSocket /talk, and a small HTTPS talk page)

// Your WiFi: set it on the robot's setup page (join the "Oreo" hotspot, open 192.168.4.1) - it's remembered.
// (Optional) a network to try when none was saved yet:
const char* ssid = "";
const char* password = "";

const char* ap_ssid = "Oreo";
const char* ap_password = ""; // Open network
const byte DNS_PORT = 53;
DNSServer dnsServer;

// I2C Pins
#define I2C_SDA 1
#define I2C_SCL 2

Adafruit_PWMServoDriver pwm = Adafruit_PWMServoDriver(0x40, Wire);
Adafruit_SSD1306 oled(128, 64, &Wire, -1);


// Battery Pin
#define BATT_PIN 3
#define TOUCH_PIN 19  // 38/39/40 belong to the board's microSD slot

// microSD slot, wired on the board in 1-bit SDMMC mode (card must be FAT32 - exFAT is off in this core)
#define SD_CLK 39
#define SD_CMD 38
#define SD_D0  40
int sdSizeMB = -1;  // -1 = no card / not readable, else the card's size

// --- Animation Globals & Mapping ---
int frameDelayFB = 200; // Slower walk for more stability (Front/Back)
int frameDelayLR = 65;  // Delay for Left/Right turning (the on-the-spot turn's frame; much shorter leaves ~2 servo writes a frame: jerky)
int walkCycles = 10;
String currentCommand = "";
unsigned long previousMillis = 0;
const long interval = 50;


// Globals for native smooth walk (CPG)
int sw_servos[8] = {L1, L2, L3, L4, R1, R2, R3, R4};
float sw_base[8] = {23.0, 24.0, 20.0, 117.0, 23.0, 130.0, 107.0, 7.0};  
float sw_amp_mapped[8] = {20.0, -15.0, 20.0, -15.0, -20.0, 15.0, -20.0, 15.0};  
float sw_phase[8] = {0.0, -1.5708, 3.14159, 1.5708, 3.14159, 1.5708, 0.0, -1.5708};
float sw_frequency = 0.012;
bool sw_rect[8] = {false};  // a knee that only lifts (half a cosine: up while its foot swings forward, flat in stance)
bool sw_snap[8] = {false};  // ...and lifts snappily: sqrt of that half cosine (up fast, held, down fast)
// The diagonal trot ("smooth_trot" / "_back", 2026-10-29): tuned in the MuJoCo sim on Oreo's model
// (1.5 Hz, 32 deg stride -> 8.6 cm/s, straight). A diagonal trot around the stand itself - hips swing the feet
// forward / back, knees kick the foot out and up only while it swings forward.
// trotSpeed (page slider, saved) = the rhythm: 0 -> 0.5 Hz ... 1 -> 2.0 Hz (sim best 1.5 Hz = 0.67).
float trotSpeed = 0.67f, trotStride = 32, trotLift = 25;  // (lift + hip swing: page sliders, saved - the sim's 45 was too much on the real legs)
float trotPhaseOff = 0;  // keeps the legs where they are when the speed changes mid-walk (no jump in the cycle)
inline float trotFreq() { return 6.2831853f * (0.5f + 1.5f * trotSpeed) / 1000.0f; }  // rad per ms
// The balanced walk ("smooth_balanced" / "_back"): knee lift and hip stride in degrees (/gait?ballift= &balstride=, saved)
float balLift = 24, balStride = 18;
double sw_innerTime = 0;       // CPG clock (ms), advanced at cpgSpeed x real time
// Elegant sit ("sit_elegant"): the front hips and front legs (R1 R2 L1 L2) at their calibrated MIN, the
// back four exactly as in the rest pose (R4 64, R3 50, L3 72, L4 64). R1 R2 L1 L2 R4 R3 L3 L4. Tune with
// GET /cmd?sitpose=... (saved). (The plain "sit" is the dead emote's pose: standing front, back legs down.)
int SIT_POSE[8] = {62, 80, -18, 76, 64, 50, 72, 64};
// ---- The steady gait + walking straight ----
// "smooth_steady" / "smooth_steady_back": the tuned forward / backward trot (walkFwd / walkBack), with
//  - a soft start: the strides grow from 0 to full over ~1.2 s (no jolt into the gait), and
//  - a soft stop: let go and the strides shrink to nothing over 0.5 s, then it stands.
// Walking straight (every straight CPG walk: smooth walk, Explore's straight walking, the steady gait):
// the heading when the walk starts is kept with the gyro (MPU-6050) - drifting right shortens the left
// side's strides a little (the way the turn presets steer), drifting left the right side's; a slow
// integral takes out a steady pull (one leg weaker). Needs the gyro's left / right sign (yawLeftSign),
// learned from a turn and saved.
bool gaitSteadyDpad = false;      // the steady gait everywhere: D-pad, RC, voice, Explore's straight walk (page switch, saved)
bool headHoldOn = true;           // walking straight with the gyro, on / off (page switch, saved)
volatile bool headHoldActive = false;  // it's steering a walk right now (the page shows it)
// the steady gait's soft start / stop for this walk? (its own buttons, or every straight walk when switched on)
bool isSteady(const String& c) {
  return c.startsWith("smooth_steady") || (gaitSteadyDpad && (c == "smooth_walk" || c == "smooth_walk_back")) ||
         c == "smooth_side_left" || c == "smooth_side_right" || c.startsWith("smooth_balanced") || c.startsWith("smooth_trot");
}
// The steady level-gait ("smooth_steady_level" / "_back"): the steady gait, plus the body kept parallel
// to the ground with the IMU (otherwise it walks nose-down). The tilt (accelerometer, smoothed) slowly bends
// the front knees up and the back knees down (which way each knee lowers its corner: from the stand -> lying-down
// poses). +-15 deg at most; what it learned stays for the next walk.
float levelTrim = 0;                    // the pitch that counts as level, deg (GET /gait?lvltrim=, saved)
volatile float levelPitch = 0, levelCorr = 0;  // (GET /gait: the smoothed pitch, + = nose down; the knee correction)
float levelOff[8] = {0};                // the knee offsets now (sw_ order), eased out by the soft stop
float headHoldKp = 0.035f;        // stride change per degree off course (0.035: 10 deg -> 35 %)
float headHoldKi = 0.010f;        // per degree-second
volatile float headErrNow = 0, headCorrNow = 0;  // (GET /gait: what the heading hold does now)
float cpgSpeed = 1.0f;
// The nav walk ("smooth_nav", /cmd?nav=vx,wz): the forward walk skid-steered by a speed (m/s) and a turn rate (rad/s,
// + = left) - each side's hips scaled -1..1, backward = played backwards. A caller sends (vx, wz), the walk does the rest.
float navVx = 0, navWz = 0;
const float NAV_VX_FULL = 0.075f, NAV_WZ_FULL = 0.6f, NAV_GATE_FULL = 0.05f;          // gait speed factor (Explore slows down near obstacles)
volatile float rcSpeed = 1.0f;  // walk mode: RC throttle (slide on the forward button), 0.5 .. 1.5; 1 outside RC
unsigned long sw_oldMillis = 0;
float cpgLastBase[8], cpgLastAmp[8], cpgLastPhase[8], cpgLastFreq = 0;  // the gait running last pass (live cross-fade)
bool cpgLastValid = false;
// Sideways walk balance (/gait?sidebal=, saved): + = the pair stepping like the forward walk pushes less and the
// reversed pair more, - = the other way. -0.6 .. 0.6
float sideBal = 0;
// Sideways walk foot lift (/gait?sidelift=, saved): the knees' swing x this (the forward walk's lift drags the feet
// sideways across the floor), the hips' stride x 0.75, the rhythm 15 % slower. 1.0 .. 2.2
float sideLift = 1.0f;

// Walk presets: Forward (user-tuned), Backward (user-tuned), Smooth Left/Right, Fwd-Left/Right
// S0=FLH, S1=BLH, S2=FLK, S3=BLK, S4=FRH, S5=BRH, S6=FRK, S7=BRK
const float WALK_FWD_BASE[8]  = {44.0, 24.0, 41.0, 117.0, 2.0, 130.0, 93.0, 7.0};
const float WALK_FWD_AMP[8]   = {-20.0, 20.0, -17.0, 17.0, 20.0, -20.0, 17.0, -17.0};
const float WALK_FWD_PHASE[8] = {0.0, -1.5708, 3.14159, 1.5708, 3.14159, 1.5708, 0.0, -1.5708};
const float WALK_FWD_FREQ = 0.012;

// Backward walk: user-tuned (freq=-0.012, bkBase=-20, S3 amp+1, S6 off+6, S7 off-9)
const float WALK_BACK_BASE[8] = {44.0, 24.0, 41.0, 97.0, 2.0, 130.0, 92.0, 18.0};
const float WALK_BACK_AMP[8]  = {-20.0, 20.0, -17.0, 18.0, 20.0, -20.0, 17.0, -17.0};
const float WALK_BACK_FREQ = -0.012;

// Smooth turns: reduce inner hip amps to 50%
const float WALK_LEFT_AMP[8]   = {-10.0, 10.0, -17.0, 17.0, 20.0, -20.0, 17.0, -17.0};
const float WALK_RIGHT_AMP[8]  = {-20.0, 20.0, -17.0, 17.0, 10.0, -10.0, 17.0, -17.0};

// Forward diagonals: reduce inner hip amps to 75%
const float WALK_FWD_LEFT_AMP[8]  = {-15.0, 15.0, -17.0, 17.0, 20.0, -20.0, 17.0, -17.0};
const float WALK_FWD_RIGHT_AMP[8] = {-20.0, 20.0, -17.0, 17.0, 15.0, -15.0, 17.0, -17.0};

// Sharp turns (CPG skid-steer): inner hips are REVERSED (negative stride) so the inner side
// walks backward while the outer side walks forward -> tight in-place turn.
// A 20% forward inner stride only produced a slightly tighter arc than the 50% smooth turn.
// Inner-side knees borrow the user-tuned backward-walk offsets (BLK 97/amp18, FRK 92, BRK 18)
// since those legs are now pushing backward.
const float WALK_SHARP_LEFT_BASE[8]  = {44.0, 24.0, 41.0, 97.0, 2.0, 130.0, 93.0, 7.0};
const float WALK_SHARP_LEFT_AMP[8]   = {12.0, -12.0, -17.0, 18.0, 20.0, -20.0, 17.0, -17.0};
const float WALK_SHARP_RIGHT_BASE[8] = {44.0, 24.0, 41.0, 117.0, 2.0, 130.0, 92.0, 18.0};
const float WALK_SHARP_RIGHT_AMP[8]  = {-20.0, 20.0, -17.0, 17.0, -12.0, 12.0, 17.0, -17.0};
// Slightly slower cycle gives the feet more traction while skidding around
const float WALK_SHARP_FREQ = 0.010;
// Level sharp turn (/gait?turnlevel=1, saved, default on): every knee at the forward walk's height. The inner
// legs' backward-walk knee offsets (up to 20 deg lower on one side) lean the body over for the whole turn.
// 0 = the original skid-steer, for an A/B.
bool turnLevel = true;

// Creator-style CPG turns: derived from Creator's frame sequences
// All hips swing in SAME rotational direction (unlike forward walk where they oppose)
// Phase: trot diagonal timing with knees leading hips by π/2
// Turn Left: S0(FLH)23→64, S1(BLH)39→78, S4(FRH)23→62, S5(BRH)115→156
const float CREATOR_LEFT_BASE[8]  = {43.5, 58.5, 33.0, 103.5, 42.5, 135.5, 92.5, 21.0};
const float CREATOR_LEFT_AMP[8]   = {20.0, 20.0, 25.0, 25.0, 20.0, 20.0, 25.0, 25.0};
// 4-beat crawl phases for sequential twisting: S0(3.14), S1(1.57), S2(-1.57), S3(3.14), S4(0), S5(-1.57), S6(0), S7(1.57)
const float CREATOR_LEFT_PHASE[8] = {3.14159, 1.5708, -1.5708, 3.14159, 0.0, -1.5708, 0.0, 1.5708};

const float CREATOR_RIGHT_BASE[8]  = {2.5, 19.5, 33.0, 103.5, 3.5, 94.5, 92.5, 21.0};
const float CREATOR_RIGHT_AMP[8]   = {-20.0, -20.0, 25.0, 25.0, -20.0, -20.0, 25.0, 25.0};
const float CREATOR_RIGHT_PHASE[8] = {3.14159, 1.5708, -1.5708, 3.14159, 0.0, -1.5708, 0.0, 1.5708};

// The walks in use: the built-in ones above, or ones saved from the page (Smooth walk settings >
// "Save as forward / backward walk"), kept in NVS ("walkF" / "walkB"). The forward walk's base
// offsets (a servo horn that slipped) carry over to the turns and diagonals.
struct WalkSet { float base[8], amp[8], phase[8], freq; };
WalkSet walkFwd, walkBack;
volatile uint8_t walkSaveReq = 0;  // flash work for applyPendingPrefs: 1 save fwd, 2 save back, 4 / 8 forget them
void walkDefaults(bool fwd, bool back) {
  for (int i = 0; i < 8; i++) {
    if (fwd) { walkFwd.base[i] = WALK_FWD_BASE[i]; walkFwd.amp[i] = WALK_FWD_AMP[i]; walkFwd.phase[i] = WALK_FWD_PHASE[i]; }
    if (back) { walkBack.base[i] = WALK_BACK_BASE[i]; walkBack.amp[i] = WALK_BACK_AMP[i]; walkBack.phase[i] = WALK_FWD_PHASE[i]; }
  }
  if (fwd) walkFwd.freq = WALK_FWD_FREQ;
  if (back) walkBack.freq = WALK_BACK_FREQ;
}

void sideGaitFill(bool left);  // (below the calibration: it reads LEG_MIN0 / MID0 / MAX0)

void balancedFill();  // (below the calibration)
void trotFill();
void loadWalkPreset(int preset) {
  for (int i = 0; i < 8; i++) sw_rect[i] = sw_snap[i] = false;
  if (preset == 14 || preset == 15) {
    trotFill();
    sw_frequency = (preset == 14 ? 1 : -1) * trotFreq();  // backward: the same gait, time reversed
    return;
  }
  if (preset == 12 || preset == 13) {
    balancedFill();
    sw_frequency = (preset == 12 ? 1 : -1) * fabsf(walkFwd.freq);  // backward: the same gait, time reversed
    return;
  }
  if (preset == 10 || preset == 11) {
    sideGaitFill(preset == 10);
    sw_frequency = walkFwd.freq;
    return;
  }
  for (int i = 0; i < 8; i++) {
    if (preset == 8) {
      sw_base[i] = CREATOR_LEFT_BASE[i];
      sw_amp_mapped[i] = CREATOR_LEFT_AMP[i];
      sw_phase[i] = CREATOR_LEFT_PHASE[i];
    } else if (preset == 9) {
      sw_base[i] = CREATOR_RIGHT_BASE[i];
      sw_amp_mapped[i] = CREATOR_RIGHT_AMP[i];
      sw_phase[i] = CREATOR_RIGHT_PHASE[i];
    } else if (preset == 4 || preset == 5) {
      // (Explore's turn - the original skid-steer; the page's Sharp L / R buttons use
      // sharpTurnUpdate(): the creator's turn, smooth)
      sw_phase[i] = walkFwd.phase[i];
      sw_base[i] = turnLevel ? walkFwd.base[i]
                             : ((preset == 4) ? WALK_SHARP_LEFT_BASE[i] : WALK_SHARP_RIGHT_BASE[i]) + (walkFwd.base[i] - WALK_FWD_BASE[i]);
      sw_amp_mapped[i] = (preset == 4) ? WALK_SHARP_LEFT_AMP[i] : WALK_SHARP_RIGHT_AMP[i];
    } else if (preset == 1) {
      sw_phase[i] = walkBack.phase[i];
      sw_base[i] = walkBack.base[i];
      sw_amp_mapped[i] = walkBack.amp[i];
    } else if (preset == 10 || preset == 11) {
      continue;  // sideways: sideGaitFill() below sets all eight
    } else {
      sw_phase[i] = walkFwd.phase[i];
      sw_base[i] = walkFwd.base[i];
      switch (preset) {
        case 2: sw_amp_mapped[i] = WALK_LEFT_AMP[i]; break;
        case 3: sw_amp_mapped[i] = WALK_RIGHT_AMP[i]; break;
        case 6: sw_amp_mapped[i] = WALK_FWD_LEFT_AMP[i]; break;
        case 7: sw_amp_mapped[i] = WALK_FWD_RIGHT_AMP[i]; break;
        default: sw_amp_mapped[i] = walkFwd.amp[i]; break;
      }
    }
  }
  if (preset == 1) sw_frequency = walkBack.freq;
  else if (preset == 4 || preset == 5) sw_frequency = WALK_SHARP_FREQ;
  else sw_frequency = walkFwd.freq;
}
float emoteDelayMultiplier = 3.5;
int walkHeadTilt = 80; // Angle to tilt head back during walks to shift CoG

// Map from original ServoName enum (R1=0, R2=1, L1=2, L2=3, R4=4, R3=5, L3=6, L4=7)
// to our physical pins:
// (mappedPins: servo_map.h - set on the servo mapping page)

// Our calibrated Min values
float ourMin[8] = {62.0, 80.0, -18.0, 76.0, 150.0, -18.0, 150.0, -18.0};
// Our calibrated Mid values
float ourMid[8] = {23.0, 115.0, 23.0, 39.0, -8.0, 107.0, 20.0, 132.0};
// Our safe Max values
float ourMax[8] = {-16.0, 150.0, 64.0, 0.0, -17.0, 130.0, -18.0, 140.0};
// Original robot's Standing angles
const int origStand[8] = {135, 45, 45, 135, 0, 180, 0, 180};

// Track current angles for smooth interpolation. At power-up the legs are limp (nothing is sent to
// them) and the robot is lying down, so start from the lying pose: the first smooth move then starts
float currentAngle[8] = {-16.0, 156.0, 64.0, 0.0, 64.0, 50.0, 72.0, 64.0};

// The built-in calibration: every pose, walk and emote was made on it. setServoAngle maps each leg
// angle piecewise (min..mid, mid..max) onto the calibration page's saved values, so a re-calibrated
// leg changes every move, not only the stand. currentAngle stays in built-in angles.
const float LEG_MIN0[8] = {62.0, 80.0, -18.0, 76.0, 150.0, -18.0, 150.0, -18.0};
const float LEG_MID0[8] = {23.0, 115.0, 23.0, 39.0, -8.0, 107.0, 20.0, 132.0};
const float LEG_MAX0[8] = {-16.0, 150.0, 64.0, 0.0, -17.0, 130.0, -18.0, 140.0};
static float calPiece(float a, float a0, float aMin, float aMax, float b0, float bMin, float bMax) {
  const bool minSide = (a - a0) * (aMin - a0) > 0;
  const float aE = minSide ? aMin : aMax, bE = minSide ? bMin : bMax;
  if (fabsf(aE - a0) < 0.5f) return b0 + (a - a0);
  return b0 + (a - a0) * (bE - b0) / (aE - a0);
}
float calMap(int ch, float a) { return calPiece(a, LEG_MID0[ch], LEG_MIN0[ch], LEG_MAX0[ch], ourMid[ch], ourMin[ch], ourMax[ch]); }
float calUnmap(int ch, float r) { return calPiece(r, ourMid[ch], ourMin[ch], ourMax[ch], LEG_MID0[ch], LEG_MIN0[ch], LEG_MAX0[ch]); }

// The sideways walk (body slides left / right, still facing ahead): the forward walk turned 90 degrees.
// The calibration: a hip's MID = the thigh diagonal, MAX = straight out to the side (lying down), MIN = along the
// body (the elegant sit's tucked legs); a knee's MIN = the foot up. The forward walk swings every hip between the
// diagonal and straight out (MID..MAX) with the knee lifting in step. Walking sideways, the body's left (or right)
// side is the "front": each leg does what the leg in that place does in the forward walk - its offset, stride,
// timing and knee lift - with its hip swinging toward MIN (along the body) instead of MAX. Built from the tuned
// forward walk, so a re-tuned forward walk carries over. sideLift scales the knee lift, sideBal the left / right
// stride balance (like the forward walk's trim: it turned while sliding).
// The balanced walk: a true diagonal trot (FL + BR together, then FR + BL), every leg with the SAME numbers from its
// own calibration - the same thigh angle, stride, knee bend and lift - so it's symmetric front / back and left / right.
// The forward walk was tuned leg by leg (front knees ~21 deg bent with a big lift, back ~15), so its back feet
// barely lift and the nose dips. Here the knee lifts only while its foot swings forward (sw_rect), the stance
// foot stays down. The IMU keeps it level (the level-gait's knee offsets) and straight (the heading hold).
void balancedFill() {
  static const int HIP[4] = {0, 1, 4, 5}, KNEE[4] = {2, 3, 6, 7};      // sw_ indices: FL, BL, FR, BR
  static const int EH[4] = {L1, L2, R1, R2}, EK[4] = {L3, L4, R3, R4};
  static const bool FRONT[4] = {true, false, true, false};
  static const float PH[4] = {0.0f, 3.14159265f, 3.14159265f, 0.0f};  // the two diagonal pairs half a cycle apart
  const float H0 = 18, K0 = 15;  // the thighs this far toward "out to the side" from the diagonal, the knees bent this much
  auto sgn = [](float a, float b) { return a > b ? 1.0f : -1.0f; };
  for (int k = 0; k < 4; k++) {
    const int eh = EH[k], ek = EK[k];
    const float sOut = sgn(LEG_MAX0[eh], LEG_MID0[eh]), sLift = sgn(LEG_MIN0[ek], LEG_MID0[ek]);
    // the foot's forward travel u = stride * sin(wt + ph): a front thigh moving out moves its foot back, a back one forward
    sw_base[HIP[k]] = LEG_MID0[eh] + sOut * H0;
    sw_amp_mapped[HIP[k]] = sOut * (FRONT[k] ? -1.0f : 1.0f) * balStride;
    sw_phase[HIP[k]] = PH[k] - 1.5707963f;
    // lifted while u grows (cos > 0): the swing forward
    sw_base[KNEE[k]] = LEG_MID0[ek] + sLift * K0;
    sw_amp_mapped[KNEE[k]] = sLift * balLift;
    sw_phase[KNEE[k]] = PH[k];
    sw_rect[KNEE[k]] = true;
  }
}

// The diagonal trot: balancedFill's trot centred on the stand (no thigh offset, knees straight), a bigger stride and
// a snappy lift that swings the foot out to the side (a knee's MIN = foot up).
void trotFill() {
  static const int HIP[4] = {0, 1, 4, 5}, KNEE[4] = {2, 3, 6, 7};      // sw_ indices: FL, BL, FR, BR
  static const int EH[4] = {L1, L2, R1, R2}, EK[4] = {L3, L4, R3, R4};
  static const bool FRONT[4] = {true, false, true, false};
  static const float PH[4] = {0.0f, 3.14159265f, 3.14159265f, 0.0f};  // FL + BR, then FR + BL
  auto sgn = [](float a, float b) { return a > b ? 1.0f : -1.0f; };
  for (int k = 0; k < 4; k++) {
    const int eh = EH[k], ek = EK[k];
    const float sOut = sgn(LEG_MAX0[eh], LEG_MID0[eh]), sLift = sgn(LEG_MIN0[ek], LEG_MID0[ek]);
    sw_base[HIP[k]] = LEG_MID0[eh];
    sw_amp_mapped[HIP[k]] = sOut * (FRONT[k] ? -1.0f : 1.0f) * trotStride;
    sw_phase[HIP[k]] = PH[k] - 1.5707963f + trotPhaseOff;
    sw_base[KNEE[k]] = LEG_MID0[ek];
    sw_amp_mapped[KNEE[k]] = sLift * trotLift;
    sw_phase[KNEE[k]] = PH[k] + trotPhaseOff;
    sw_rect[KNEE[k]] = sw_snap[KNEE[k]] = true;
  }
}

// The trot's speed changed: the new rhythm picks up exactly where the legs are (the phase is freq x clock + offset)
void trotSetSpeed(float s) {
  s = constrain(s, 0.0f, 1.0f);
  const float fOld = trotFreq();
  trotSpeed = s;
  if (currentCommand.startsWith("smooth_trot")) {
    const float way = currentCommand.endsWith("_back") ? -1.0f : 1.0f;
    trotPhaseOff = fmodf(trotPhaseOff + (float)fmod(way * (fOld - trotFreq()) * sw_innerTime, 6.283185307), 6.2831853f);
    loadWalkPreset(currentCommand.endsWith("_back") ? 15 : 14);
  }
}

void sideGaitFill(bool left) {
  static const int HIP[4] = {0, 1, 4, 5}, KNEE[4] = {2, 3, 6, 7};  // sw_ indices, legs FL, BL, FR, BR
  static const int EH[4] = {L1, L2, R1, R2}, EK[4] = {L3, L4, R3, R4};  // their servos (LEG_*0 index)
  // the forward-walk leg each one plays: going left FL->FR, BL->FL, FR->BR, BR->BL; going right FL->BL ...
  static const int ROLE_L[4] = {2, 0, 3, 1}, ROLE_R[4] = {1, 3, 0, 2};
  auto sgn = [](float a, float b) { return a > b ? 1.0f : -1.0f; };
  for (int k = 0; k < 4; k++) {
    const int r = left ? ROLE_L[k] : ROLE_R[k];
    const int ehr = EH[r], ekr = EK[r], eh = EH[k], ek = EK[k];
    // the forward walk's leg r: hip in "toward the side" units, knee in "toward lift" units
    const float sOutR = sgn(LEG_MAX0[ehr], LEG_MID0[ehr]), sLiftR = sgn(LEG_MIN0[ekr], LEG_MID0[ekr]);
    const float hipOff = (walkFwd.base[HIP[r]] - LEG_MID0[ehr]) * sOutR, hipAmp = walkFwd.amp[HIP[r]] * sOutR;
    const float kneeOff = (walkFwd.base[KNEE[r]] - LEG_MID0[ekr]) * sLiftR, kneeAmp = walkFwd.amp[KNEE[r]] * sLiftR;
    // on leg k: the hip toward MIN (along the body), the knee toward lift as before
    const float sAlong = sgn(LEG_MIN0[eh], LEG_MID0[eh]), sLift = sgn(LEG_MIN0[ek], LEG_MID0[ek]);
    float trim = 1;
    if (r < 2) trim = 1 - max(sideBal, 0.0f); else trim = 1 + min(sideBal, 0.0f);  // (the role's left / right side)
    sw_base[HIP[k]] = LEG_MID0[eh] + sAlong * hipOff;
    sw_amp_mapped[HIP[k]] = sAlong * hipAmp * trim;
    sw_phase[HIP[k]] = walkFwd.phase[HIP[r]];
    sw_base[KNEE[k]] = LEG_MID0[ek] + sLift * kneeOff;
    sw_amp_mapped[KNEE[k]] = sLift * kneeAmp * sideLift;
    sw_phase[KNEE[k]] = walkFwd.phase[KNEE[r]];
  }
}

// The calibration page moved this pin (millis): every other mover keeps off it for 5 s (otherwise they fight
// the page and the servos jitter while setting min / mid / max). servoRawNow: each pin's last angle.
unsigned long calPinMs[16] = {0};
float servoRawNow[16];
bool servoRawKnown[16] = {false};
inline bool calHolding(int pin) { return calPinMs[pin] != 0 && millis() - calPinMs[pin] < 5000; }


bool pressingCheck(String cmd, int ms) {
  unsigned long start = millis();
  while(millis() - start < ms) {
    if (currentCommand != cmd) return false;
    vTaskDelay(pdMS_TO_TICKS(10));
  }
  return true;
}






bool legsPowered = false;  // false until the first leg command after power-up (the legs are limp)
// Whether we know where the legs are. At power-up we don't (limp: it may lie, or still stand on
// gear friction after a reboot), so the first move goes straight to its target - no guessed start
// pose (guessing "lying" would make a standing robot drop and pop up again).
// After "rest" the legs are relaxed but known: lying.
bool legsPoseKnown = false;
// Lying down needs no holding power: switch the 8 leg servos off (holding, they draw current all the time).
// The next move starts from the lying pose (smooth first stand).
void prefPut(const char* key, int32_t val, bool isBool);  // below
bool legsLyingSaved = false;  // NVS "legsLying": it last lay down (kept over a power-off)
void legsRelax() {
  if (!legsLyingSaved) { legsLyingSaved = true; prefPut("legsLying", 1, true); }  // (a camera-safe flash write, later)
  for (int i = 0; i < 8; i++) pwm.setPWM(mappedPins[i], 0, 4096);  // full off
  const float lying[8] = {-16, 156, 64, 0, 64, 50, 72, 64};
  for (int i = 0; i < 8; i++) currentAngle[i] = lying[i];
  legsPowered = false;
}
// Where the legs are when the ESP starts, from the servo board itself: after a restart (an update,
// a crash, the reset button) it still drives them - its registers hold each pulse, so the pose is
// known exactly and the first move glides from there. After a real power-up it starts asleep with
// the legs off: they've folded, so the first move starts from lying (not a jump at full speed).
// Call before pwm.begin().
void legsFromServoBoard() {
  static const float lying[8] = {-16, 156, 64, 0, 64, 50, 72, 64};
  static const float standing[8] = {23, 115, 23, 39, -8, 107, 20, 132};  // R1 R2 L1 L2 R4 R3 L3 L4
  auto rd = [](uint8_t reg, uint8_t* b, uint8_t n) {
    Wire.beginTransmission(0x40);
    Wire.write(reg);
    if (Wire.endTransmission(false) != 0 || Wire.requestFrom((uint8_t)0x40, n) != n) return false;
    for (int i = 0; i < n; i++) b[i] = Wire.read();
    return true;
  };
  uint8_t mode1 = 0, pre = 0;
  if (!rd(0x00, &mode1, 1) || !rd(0xFE, &pre, 1)) return;  // no answer: unknown (moves go straight)
  bool driven = !(mode1 & 0x10);  // awake: it was running before this start
  float ang[8];
  for (int i = 0; i < 8 && driven; i++) {
    uint8_t r[4];
    if (!rd(0x06 + 4 * mappedPins[i], r, 4) || (r[3] & 0x10)) { driven = false; break; }  // full off: limp
    const int ticks = (((r[3] & 0x0F) << 8 | r[2]) - ((r[1] & 0x0F) << 8 | r[0])) & 0xFFF;
    const float us = ticks * (pre + 1) * 1e6f / 27e6f;
    ang[i] = (us - 732) * 180.0f / (2929 - 732);
    if (ang[i] < -60 || ang[i] > 240) driven = false;
  }
  // Powered up (legs off): standing or lying? It's what it last did: "legsLying" is saved when it lies down
  // (Rest, sleepy) and cleared at its next move - the usual case is standing.
  bool lyingNow = false;
  if (!driven) {
    Preferences lp;
    lp.begin("explore", true);
    lyingNow = lp.getBool("legsLying", false);
    lp.end();
    legsLyingSaved = lyingNow;
  }
  for (int i = 0; i < 8; i++) currentAngle[i] = driven ? (int)lroundf(ang[i]) : lyingNow ? lying[i] : standing[i];
  // (the read-back is a servo angle; currentAngle is a built-in angle - setup converts it with calUnmap once the
  // calibration is loaded)
  legsPowered = driven;
  // Limp and not lying: where the legs really are isn't known (sagged, half standing). Unknown: the
  // first move goes straight to its target, one joint after another.
  legsPoseKnown = driven || lyingNow;
  xlogSys("LEGS at start: %s", driven ? "still driven by the servo board (a restart): pose read back"
                                      : lyingNow ? "limp, it last lay down: taken as lying" : "limp, it last stood: taken as standing");
}

const float SERVO_TRAVEL_LO = -19.0f, SERVO_TRAVEL_HI = 150.0f;  // MG90S (0..180 = 732..2929 us)
void setServoAngle(uint8_t channel, int angle) {
   if (channel > 7) return;
   if (legsLyingSaved) { legsLyingSaved = false; prefPut("legsLying", 0, true); }  // moving again: not lying any more
   legsPowered = true;
   legsPoseKnown = true;
   
   // the limits, in built-in angles (= the saved min / max after the mapping)
   const float safeMin = min(LEG_MIN0[channel], LEG_MAX0[channel]);
   const float safeMax = max(LEG_MIN0[channel], LEG_MAX0[channel]);
   if (angle < safeMin) angle = safeMin;
   if (angle > safeMax) angle = safeMax;

   currentAngle[channel] = angle;

   const int pin = mappedPins[channel];
   if (calHolding(pin)) return;  // the calibration page has it
   // never past the MG90S's travel (-19..150 on this scale): a saved Min / Max beyond where the servo really
   // stops would otherwise hold it against its internal stop (buzzing, heat)
   const float raw = constrain(calMap(channel, angle), SERVO_TRAVEL_LO, SERVO_TRAVEL_HI);
   servoRawNow[pin] = raw;
   servoRawKnown[pin] = true;
   pwm.writeMicroseconds(pin, (uint16_t)lroundf(732 + raw * (2929 - 732) / 180.0f));
}

// Pan jumps (more than 4 deg in one write) go in the log with who moved it (to trace random jerks).
// panWho is set by each mover just before its write.
const char* panWho = "?";
void panJumpCheck(uint8_t pin, float angle) {
  static float last = -999;
  if (pin != headPanCh) return;
  if (last > -900 && fabsf(angle - last) > 4) {
    static unsigned long lastLogMs = 0;
    if (millis() - lastLogMs > 300) { lastLogMs = millis(); xlog("PANJUMP %.1f -> %.1f (%s)", last, angle, panWho); }
  }
  last = angle;
}
void setHeadServoAngle(uint8_t pin, int angle) {
   if (calHolding(pin)) return;  // the calibration page has it
   servoRawNow[pin] = angle;
   servoRawKnown[pin] = true;
   panJumpCheck(pin, angle);
   int pulse = map(angle, 0, 180, 732, 2929);
   pwm.writeMicroseconds(pin, pulse);
}
// The same with a fractional angle: slow head moves glide instead of stepping a degree at a time
void setHeadServoF(uint8_t pin, float angle) {
   if (calHolding(pin)) return;  // the calibration page has it
   servoRawNow[pin] = angle;
   servoRawKnown[pin] = true;
   panJumpCheck(pin, angle);
   pwm.writeMicroseconds(pin, (uint16_t)lroundf(732 + angle * (2929 - 732) / 180.0f));
}

void moveServosSmooth(int tgts[8], int durationMs) {
  int steps = durationMs / 20; // 50Hz update rate
  if (steps < 1) steps = 1;
  
  if (!legsPoseKnown) {
    // Unknown pose (limp after power-up): straight to the target - no guessed start, that would make a
    // detour - but one joint after another, not all 8 at full speed at once (one violent jolt).
    bool all = true;
    for (int i = 0; i < 8; i++) {
      if (tgts[i] == -999) { all = false; continue; }
      setServoAngle(i, tgts[i]);
      vTaskDelay(pdMS_TO_TICKS(max(40, min(durationMs / 8, 110))));
    }
    legsPoseKnown = all;  // (a joint left out is still where nobody knows: the next move goes straight there too)
    return;
  }
  float startAngles[8];
  for (int i = 0; i < 8; i++) {
    startAngles[i] = currentAngle[i];
  }
  
  // Ease in / ease out (cosine): starts gently, lands softly - no jolt at either end
  for (int s = 1; s <= steps; s++) {
    const float e = 0.5f - 0.5f * cosf(PI * s / steps);
    for (int i = 0; i < 8; i++) {
      if (tgts[i] == -999) continue;
      float intermediate = startAngles[i] + (tgts[i] - startAngles[i]) * e;
      setServoAngle(i, (int)lroundf(intermediate));
    }
    vTaskDelay(pdMS_TO_TICKS(20));
  }
}

void moveSmoothHelper(int duration, int r1, int r2, int l1, int l2, int r4, int r3, int l3, int l4) {
  int tgts[8] = {r1, r2, l1, l2, r4, r3, l3, l4};
  moveServosSmooth(tgts, duration);
}


httpd_handle_t cmd_httpd = NULL;
extern httpd_handle_t stream_httpd;  // the video server (below)

// --- LOVYANGFX DISPLAY SETUP ---
// The ST7789 with LovyanGFX's own init commands minus the last one, "display on": that one would show the
// panel's memory - whatever power-up left in it - for a moment before the first frame (a half-lit, distorted
// screen at every start). setup() clears the memory to black first, then turns the display on (0x29).
class Panel_ST7789_Quiet : public lgfx::Panel_ST7789 {
 public:
  const uint8_t* getInitCommands(uint8_t listno) const override {
    if (listno != 0) return nullptr;
    static uint8_t list[160];
    static bool made = false;
    if (!made) {  // a copy of list 0 without CMD_DISPON (0x29, 0 args)
      const uint8_t* src = lgfx::Panel_ST7789::getInitCommands(0);
      int i = 0, o = 0;
      while (o < (int)sizeof(list) - 2) {
        const uint8_t cmd = src[i], n = src[i + 1];
        if (cmd == 0xFF && n == 0xFF) { list[o++] = 0xFF; list[o++] = 0xFF; break; }
        const int len = 2 + (n & 0x7F) + ((n & 0x80) ? 1 : 0);  // args, and a delay byte (CMD_INIT_DELAY)
        if (cmd != 0x29) for (int k = 0; k < len && o < (int)sizeof(list) - 2; k++) list[o++] = src[i + k];
        i += len;
      }
      made = true;
    }
    return list;
  }
};
class LGFX : public lgfx::LGFX_Device {
  Panel_ST7789_Quiet _panel_instance;
  lgfx::Bus_SPI      _bus_instance;
public:
  LGFX(void) {
    {
      auto cfg = _bus_instance.config();
      cfg.spi_host = SPI2_HOST; 
      cfg.spi_mode = 3;         
      cfg.freq_write = 40000000;  // 40 MHz: a full face frame in ~30 ms (smooth animation)
      cfg.freq_read  = 16000000;
      cfg.spi_3wire  = false;
      cfg.use_lock   = true;
      cfg.dma_channel = SPI_DMA_CH_AUTO;
      cfg.pin_sclk = 42;
      cfg.pin_mosi = 41;
      cfg.pin_miso = -1; 
      cfg.pin_dc   = 20;  // (39 is the SD card's clock)
      _bus_instance.config(cfg);
      _panel_instance.setBus(&_bus_instance);
    }
    {
      auto cfg = _panel_instance.config();
      cfg.pin_cs           = 21; 
      cfg.pin_rst          = -1;  // (40 is the SD card's data line). The RST wire is joined to EN on GPIO 14: it rises with the display's power, and the panel gets a software reset. (Not GPIO 0/43/44: the unpowered display pulls its pins low at boot.)
      cfg.pin_busy         = -1;
      cfg.panel_width      = 240;
      cfg.panel_height     = 320;
      cfg.offset_x         = 0;
      cfg.offset_y         = 0;
      cfg.offset_rotation  = 0;
      cfg.dummy_read_pixel = 8;
      cfg.dummy_read_bits  = 1;
      cfg.readable         = false;
      cfg.invert           = true;  
      cfg.rgb_order        = false; 
      cfg.dlen_16bit       = false;
      cfg.bus_shared       = true;
      _panel_instance.config(cfg);
    }
    setPanel(&_panel_instance);
  }
};
LGFX tft;
LGFX_Sprite sprite(&tft);
LGFX_Sprite sprite2(&tft);  // the face draws into one while the other goes to the screen
#include "face_logic.h"
#define TFT_EN_PIN 14

// ================= ROBOT MODES: WALK ENGINE / FACE TRACKING / EXPLORE =================
// Walk engine: web D-pad + emotes (default).
// Face tracking: legs stand, head follows faces (ESP-DL MSR01, direct P-control with a
//   30px deadband, holds position when the face is lost).
// Explore: autonomous smooth walk that avoids obstacles with the head-mounted VL53L0X
//   (swept left/right with the pan servo) plus a cheap camera floor check.
//
// Threading: visionTask (core 0) owns the camera and, while a camera mode is active, the
// TFT. loop() (core 1) owns ALL I2C (PCA9685, OLED, MPU, ToF): Wire is not safe across
// tasks and concurrent use crashed with a Wire repeated-start / mutex assert. The task
// only publishes results (head targets, floor free-space) through volatiles.
#define CAM_PWDN   -1
#define CAM_RESET  -1
#define CAM_XCLK   15
#define CAM_SIOD   4
#define CAM_SIOC   5
#define CAM_Y9     16
#define CAM_Y8     17
#define CAM_Y7     18
#define CAM_Y6     12
#define CAM_Y5     10
#define CAM_Y4     8
#define CAM_Y3     9
#define CAM_Y2     11
#define CAM_VSYNC  6
#define CAM_HREF   7
#define CAM_PCLK   13

#define HEAD_PAN_PIN   headPanCh   // (servo_map.h)
#define HEAD_TILT_PIN  headTiltCh
// Head calibration (min / mid / max servo angles), set on the page ("Head calibration") and
// saved in NVS: mid = the head looks straight ahead, min / max = as far as it may go (the head
// touches the body beyond). Everything uses these: modes, emotes, RC, face tracking, Explore.
const float PAN_MIN0 = -18.0, PAN_MID0 = 60.0, PAN_MAX0 = 150.0;
const float TILT_MIN0 = 69.0, TILT_MID0 = 99.0, TILT_MAX0 = 150.0;  // (min: just before the head rests on the neck arms, ~36 deg up)
float PAN_MIN = PAN_MIN0, PAN_MID = PAN_MID0, PAN_MAX = PAN_MAX0;
float TILT_MIN = TILT_MIN0, TILT_MID = TILT_MID0, TILT_MAX = TILT_MAX0;
void exFloorGeometry();
void setHeadCal(float pmin, float pmid, float pmax, float tmin, float tmid, float tmax) {
  PAN_MIN = constrain(pmin, -40.0f, 180.0f);
  PAN_MAX = constrain(pmax, PAN_MIN + 10, 200.0f);
  PAN_MID = constrain(pmid, PAN_MIN, PAN_MAX);
  TILT_MIN = constrain(tmin, 0.0f, 140.0f);
  TILT_MAX = constrain(tmax, TILT_MIN + 10, 150.0f);  // (past 150 the head presses on the body)
  TILT_MID = constrain(tmid, TILT_MIN, TILT_MAX);
  exFloorGeometry();
}
const int   FACE_DEADBAND_PX = 25;
const float FACE_GAIN = 0.05;       // deg per px of error per frame
const float FACE_MAX_STEP = 9;      // deg per frame, so one bad detection can't jerk the head

enum RobotMode { MODE_WALK = 0, MODE_FACE = 1, MODE_EXPLORE = 2, MODE_DESK = 3, MODE_LIFE = 4 };
namespace deskm { void deskEnter(); void deskLeave(); void deskTick(unsigned long now); unsigned long bodyQuietMs(); }
namespace lifem { void lifeEnter(); void lifeLeave(); void lifeTick(unsigned long now); }  // life_mode.h (below)
namespace fid {  // face_id.h (below): who is this
  bool wanted(unsigned long now); void offer(const uint16_t* frame, const std::vector<int>& points); void begin();
  const char* recent(unsigned long ms = 5000); extern volatile unsigned long whoMs; extern char whoName[24];
}
volatile bool deskWalkActive = false;  // desk mode's edge-checked stroll is walking right now (its gaits pass)
volatile bool deskCamOff = false;  // desk mode's StandBy: the camera rests (desk_mode.h, below)
const char* const MODE_NAMES[] = {"walk", "face", "explore", "desk", "life"};
volatile int requestedMode = MODE_WALK;  // set by /setMode (web server task)
volatile int activeMode = MODE_WALK;     // owned by loop(): the mode the robot is actually in
volatile bool camReady = false;          // owned by visionTask: camera is running
volatile bool camFailed = false;         // owned by visionTask: camera unusable for this request
char modeError[128] = "";                 // last mode error, shown in the web UI
char camInitErr[72] = "";                 // the last camera start that failed, and the memory then

// Face tracking -> loop(): head targets
volatile int headPanTarget = (int)PAN_MID;
volatile unsigned long faceSeenGlobalMs = 0;  // face tracking: when a face was last seen (OLED)
volatile int headTiltTarget = (int)TILT_MID;
volatile bool headTargetDirty = false;
volatile bool deskFaceTrack = false;  // desk mode: the head follows a face it sees (the desk page's switch, saved)
volatile float deskUserPan = 0, deskUserTilt = 0;  // desk mode: where the user's face is (head angles), always
volatile unsigned long deskUserMs = 0;               // (when it was last seen there; 0 = never)
extern unsigned long exHeadMovedMs;                  // (below: the head's last move - a picture mid-move is off)
// Life mode (life_mode.h): the biggest face's width in the camera (px, 0 = none) and its OLED card
volatile int lifeFaceW = 0;
char lifeMsgTitle[14] = "", lifeMsgL1[22] = "";
unsigned long lifeMsgUntil = 0;

// Explore camera floor check -> loop(). How much of the lower image is still floor in
// each image band (0 = image left, 1 = center, 2 = image right): 0 = blocked right in
// front, 1 = floor continues to the horizon.
volatile float camFree[3] = {1, 1, 1};
volatile unsigned long camFreeMs = 0;
// Light levels of the latest Explore frame (luma 0..219): whole picture, the view ahead
// (around the horizon: under a bed shows up here) and the floor just in front of the feet
volatile float camLumaAll = -1, camLumaAhead = -1, camLumaNear = -1;
volatile unsigned long camLightMs = 0;

// ToF (VL53L0X on the head, beside the camera)
Adafruit_VL53L0X lox;
bool tofOk = false;
const int TOF_FAR_MM = 2000;             // "nothing in range" is treated as open space
volatile int tofMm = -1;                 // median of the last 3 readings, -1 = no sensor
unsigned long tofSeq = 0;                // increments on every new reading
bool tofRunning = false;                 // ranging (laser on): only while something uses it
volatile unsigned long tofNeedMs = 0;    // the head calibration panel used it (floor glances)

// Explore settings (persisted in NVS)
Preferences prefs;
// The clock's timezone: seconds from UTC (pref "tzOff"). Set on its own from the city on the desk page (the weather
// service tells its UTC offset), or by hand: GET /desk?tzoff=<seconds> (or tzoff=auto).
int tzOffsetSec = 0;
void applyUtcOffset(int sec, bool save) {
  sec = constrain(sec, -14 * 3600, 14 * 3600);
  tzOffsetSec = sec;
  configTime(sec, 0, "pool.ntp.org", "time.google.com");
  if (save) prefs.putInt("tzOff", sec);
}
bool exploreCamAssist = true;            // also stop / steer on the camera floor check
bool panPlusIsLeft = true;               // a bigger pan angle turns the head to the robot's left
const char* volatile exploreStateName = "idle";

bool startCamera(bool jpeg);
// the camera's kept DMA buffer (our esp32-camera copy, cam_hal.c; weak: the plain Arduino build hasn't them)
extern "C" size_t esp_camera_keep_dma(size_t size) __attribute__((weak));
extern "C" size_t esp_camera_kept_dma(void) __attribute__((weak));

// ---- Camera view (RC mode): the camera streamed to the page ----
// Walk mode: the camera runs in JPEG straight from the sensor (the TFT keeps the face) and
// the frames go to /stream on a second web server (port 81), so a video playing never
// blocks the controls. Face / Explore: a few frames a second are JPEG-encoded from the raw
// frames they use. The vision task publishes the newest frame here; the stream copies it.
const size_t JPG_MAX = 640 * 1024;  // a 2048 x 1536 JPEG fits (PSRAM)
uint8_t* jpgFrame = nullptr;       // PSRAM
size_t jpgFrameLen = 0;
volatile uint32_t jpgSeq = 0;
SemaphoreHandle_t jpgMutex = nullptr;
volatile int streamClients = 0;
volatile uint32_t streamGen = 0;   // /camView?new=1 bumps it: an older stream still running stops

// ---- Photos (SD card): what the camera saw at each Explore PROBLEM and USER MARK ----
// requestPhoto() asks the vision task for the next frame (JPEG as it is, or a raw frame
// encoded to JPEG); the photo task writes it to /photos/boot<N>/<uptime>-<tag>.jpg and logs a
// PHOTO line, so the log and the picture go together.
volatile bool photoReq = false;
volatile size_t photoLen = 0;
uint8_t* photoBuf = nullptr;       // PSRAM, JPG_MAX
char photoTag[24] = "";
TaskHandle_t photoTaskHandle = nullptr;
extern int sdSizeMB;

void requestPhoto(const char* tag) {
  if (sdSizeMB < 0 || !photoBuf || photoReq || photoLen) return;  // no card, or one still being saved
  strlcpy(photoTag, tag, sizeof(photoTag));
  photoReq = true;
}

// Vision task: fill the photo from this frame if one was asked for
void takePhotoFrom(camera_fb_t* fb) {
  if (!photoReq || photoLen) return;
  photoReq = false;
  if (fb->format == PIXFORMAT_JPEG) {
    if (fb->len > JPG_MAX) return;
    memcpy(photoBuf, fb->buf, fb->len);
    photoLen = fb->len;
  } else {
    uint8_t* out = nullptr;
    size_t len = 0;
    if (!frame2jpg(fb, 80, &out, &len) || !out) return;
    if (len <= JPG_MAX) {
      memcpy(photoBuf, out, len);
      photoLen = len;
    }
    free(out);
  }
  if (photoLen && photoTaskHandle) xTaskNotifyGive(photoTaskHandle);
}

void photoTask(void*) {
  for (;;) {
    ulTaskNotifyTake(pdTRUE, portMAX_DELAY);
    if (!photoLen) continue;
    char dir[24], name[64];
    snprintf(dir, sizeof(dir), "/photos/boot%u", (unsigned)xl::bootNo);
    if (!SD_MMC.exists("/photos")) SD_MMC.mkdir("/photos");
    if (!SD_MMC.exists(dir)) SD_MMC.mkdir(dir);
    const unsigned long ms = millis();
    snprintf(name, sizeof(name), "%s/%06lu-%s.jpg", dir, ms / 100, photoTag);  // tenths of a second
    File f = SD_MMC.open(name, FILE_WRITE);
    const bool ok = f && f.write(photoBuf, photoLen) == photoLen;
    if (f) f.close();
    if (ok) xlog("PHOTO %s (%u KB) - /sdGet?name=%s", photoTag, (unsigned)(photoLen / 1024), name);
    photoLen = 0;
  }
}
// (a phone can keep the old connection of a closed RC screen open; the stream server serves one
// stream at a time, so the next RC screen would get no picture or a slow one)
// Face / Explore while someone watches the video: the camera sends its own JPEG (hardware
// compressed) straight to the page at full frame rate, and a task on core 1 (loop() sleeps
// 10 ms per pass, core 1 is mostly free) decodes each one to RGB565 for the camera task's
// checks and the TFT (~55-75 ms a frame, one frame behind) - far faster than encoding raw frames in software.
const size_t RAW_BYTES = 320 * 240 * 2;
const size_t DEC_IN_MAX = 48 * 1024;
uint8_t* decIn = nullptr;          // PSRAM: the JPEG being decoded
volatile size_t decInLen = 0;
uint8_t* decBuf[2] = {nullptr, nullptr};
uint8_t* volatile decFront = nullptr;  // newest decoded frame (the camera task reads it under decMutex)
volatile uint32_t decSeq = 0;
volatile bool decBusy = false;
SemaphoreHandle_t decMutex = nullptr;
TaskHandle_t decTaskHandle = nullptr;
volatile float decFps = 0, visFps = 0;
volatile int detMs = 0;            // last face detection time
volatile bool camViewWanted = false;
volatile bool chatCamBlock = false;  // a chat is on: the page's video stays off (camera + video cost ~35 KB of internal RAM the chat needs)
volatile bool camFrameWanted = false;  // gemini.h wants a photo: frames to the latest-JPEG buffer even with no viewer
// A conversation (gemini.h) wants to know where you are, so the head can turn to you: a face search
// in the camera's frames ~4 times a second (the screen keeps the face - unlike face tracking mode).
// chatFaceX / Y: where the biggest face is, -1..1 from the middle of the picture (x right, y down)
volatile bool chatFaceWanted = false;
volatile float chatFaceX = 0, chatFaceY = 0, chatFaceSize = 0;
volatile unsigned long chatFaceMs = 0;
volatile int chatFaceDetMs = 0;
volatile bool chatFaceOn = false;  // face tracking in a chat (the Talk panel's switch, saved: GET /gemini?fs=1|0)
volatile int camViewSize = FRAMESIZE_VGA;
volatile bool camViewSizeChanged = false;
volatile float camFps = 0, streamFps = 0;      // frames/s from the camera and sent to the page
volatile unsigned long camViewViewerMs = 0;    // last time someone watched (auto-off after 10 s)
const unsigned long STREAM_MIN_MS = 41;        // 24 fps cap (the camera itself makes ~14 at XCLK 10 MHz)

// RC mode open on the page: its status polls say so (?rc=1). Expires 5 s after the last
// one, so a phone that locks / closes the page doesn't leave the log paused.
volatile unsigned long rcSeenMs = 0;
volatile unsigned long webSeenMs = 0;  // the page asked something (it polls every 0.7 s while open)
bool rcActive() { return rcSeenMs && millis() - rcSeenMs < 5000; }
volatile bool rcDriveLease = false;    // an RC walk is running on the page's "hold" refreshes (loop() stops it when they stop)
volatile unsigned long rcDriveMs = 0;  // the last walk command / hold=1 from the RC screen

void publishJpeg(const uint8_t* data, size_t len) {
  if (!jpgFrame || len == 0 || len > JPG_MAX) return;
  xSemaphoreTake(jpgMutex, portMAX_DELAY);
  memcpy(jpgFrame, data, len);
  jpgFrameLen = len;
  jpgSeq++;
  xSemaphoreGive(jpgMutex);
}

// The face search for a conversation (gemini.h starts it): its own task, so it doesn't hold up the camera
// or the face's drawing (the camera task draws it).
// Twice a second: the newest camera JPEG, half size (160 x 120: a quarter of the work and memory), the
// camera's own byte order, the face detector. Only with internal RAM to spare (the detector takes some).
// A JPEG's width / height (its SOF header), false if not found in the first 2 KB
bool jpegSize(const uint8_t* d, size_t n, int* w, int* h) {
  for (size_t i = 2; i + 9 < n && i < 2048; i++)
    if (d[i] == 0xFF && (d[i + 1] == 0xC0 || d[i + 1] == 0xC2)) {
      *h = (d[i + 5] << 8) | d[i + 6];
      *w = (d[i + 7] << 8) | d[i + 8];
      return true;
    }
  return false;
}

void chatFaceTask(void*) {
  uint8_t* jpg = (uint8_t*)heap_caps_malloc(64 * 1024, MALLOC_CAP_SPIRAM);
  uint8_t* rgb = (uint8_t*)heap_caps_malloc(160 * 120 * 2, MALLOC_CAP_SPIRAM);
  static HumanFaceDetectMSR01* det = nullptr;  // (kept: made once)
  uint32_t lastSeq = 0;
  while (chatFaceWanted && jpg && rgb) {
    vTaskDelay(pdMS_TO_TICKS(500));
    if (!chatFaceOn || jpgSeq == lastSeq || heap_caps_get_free_size(MALLOC_CAP_INTERNAL) < 50000) continue;  // (it takes ~26 KB: 50 leaves the network ~24)
    size_t len = 0;
    xSemaphoreTake(jpgMutex, portMAX_DELAY);
    lastSeq = jpgSeq;
    if (jpgFrameLen <= 64 * 1024) { len = jpgFrameLen; memcpy(jpg, jpgFrame, len); }
    xSemaphoreGive(jpgMutex);
    const unsigned long t0 = millis();
    int jw = 0, jh = 0;  // (only 320 x 240 frames: a photo for Gemini is taken bigger, and wouldn't fit)
    if (!len || !jpegSize(jpg, len, &jw, &jh) || jw != 320 || jh != 240) continue;
    if (!jpg2rgb565(jpg, len, rgb, JPG_SCALE_2X)) continue;  // (a QVGA frame -> 160 x 120)
    uint32_t* w = (uint32_t*)rgb;
    for (size_t i = 0; i < 160 * 120 * 2 / 4; i++) w[i] = ((w[i] & 0x00FF00FFu) << 8) | ((w[i] >> 8) & 0x00FF00FFu);
    if (!det) det = new HumanFaceDetectMSR01(0.1F, 0.5F, 10, 0.4F);  // (scaled for the half size, like detectorHalf)
    std::list<dl::detect::result_t>& res = det->infer((uint16_t*)rgb, {120, 160, 3});
    int best = 0;
    for (auto& r : res) {
      const int area = (r.box[2] - r.box[0]) * (r.box[3] - r.box[1]);
      if (area <= best) continue;
      best = area;
      chatFaceX = ((r.box[0] + r.box[2]) / 2.0f - 80) / 80;
      chatFaceY = ((r.box[1] + r.box[3]) / 2.0f - 60) / 60;
      chatFaceSize = (float)(r.box[2] - r.box[0]) / 160;
    }
    if (best) chatFaceMs = millis();
    chatFaceDetMs = millis() - t0;
  }
  heap_caps_free(jpg);
  heap_caps_free(rgb);
  vTaskDelete(nullptr);
}

void decoderTask(void*) {
  uint32_t n = 0;
  unsigned long fpsMs = millis();
  for (;;) {
    if (ulTaskNotifyTake(pdTRUE, pdMS_TO_TICKS(1000)) == 0) { decFps = 0; n = 0; fpsMs = millis(); continue; }
    uint8_t* back = decFront == decBuf[0] ? decBuf[1] : decBuf[0];
    if (jpg2rgb565(decIn, decInLen, back, JPG_SCALE_NONE)) {
      // jpg2rgb565 writes the other byte order than the camera's own RGB565
      uint32_t* w = (uint32_t*)back;
      for (size_t i = 0; i < RAW_BYTES / 4; i++) {
        const uint32_t x = w[i];
        w[i] = ((x & 0x00FF00FFu) << 8) | ((x >> 8) & 0x00FF00FFu);
      }
      xSemaphoreTake(decMutex, portMAX_DELAY);
      decFront = back;
      decSeq++;
      xSemaphoreGive(decMutex);
      n++;
    }
    decBusy = false;
    if (millis() - fpsMs >= 1000) {
      decFps = n * 1000.0f / (millis() - fpsMs);
      n = 0;
      fpsMs = millis();
    }
  }
}

// Size + JPEG quality for the camera view: sharper (lower number) where the WiFi can still
// carry ~24 / ~16 / ~10 fps (~215 KB/s)
// The camera's own sharpening, before JPEG compression (much better than sharpening a soft
// JPEG afterwards): -1 = as the driver sets it, 0..6 = softer .. sharper. The camera on this
// robot is an OV3660 (sensor id 0x3660, 3 MP) - its driver has set_sharpness (-3..3); an
// OV2640 would need its DSP registers 0x92 / 0x93. Saved; /camView?sharp=N.
extern "C" int SCCB_Write(uint8_t slv_addr, uint8_t reg, uint8_t data);
volatile int camSharp = -1;
volatile bool camSharpChanged = false;
volatile int camSharpRes = 0;  // result of the last setting (0 = ok) - web UI
void applyCamSharp(sensor_t* sn) {
  if (!sn || camSharp < 0) return;
  if (sn->id.PID == OV2640_PID) {
    static const uint8_t LV[7] = {0xc0, 0xc1, 0xc2, 0xc4, 0xc8, 0xd0, 0xdf};
    SCCB_Write(sn->slv_addr, 0xFF, 0x00);  // DSP register bank
    SCCB_Write(sn->slv_addr, 0x92, 0x01);
    camSharpRes = SCCB_Write(sn->slv_addr, 0x93, LV[min(6, (int)camSharp)]);
  } else if (sn->set_sharpness) {
    camSharpRes = sn->set_sharpness(sn, (int)camSharp - 3);
  }
}

// The RC view sizes, smallest to largest (the OV3660 goes up to 2048 x 1536)
struct CamSize { const char* name; framesize_t fs; int q; };
const CamSize CAM_SIZES[] = {
  {"qvga", FRAMESIZE_QVGA, 14}, {"hvga", FRAMESIZE_HVGA, 14}, {"vga", FRAMESIZE_VGA, 12}, {"svga", FRAMESIZE_SVGA, 12},  // (RC qvga/hvga 14: smaller frames, more of them through a weak link)
  {"xga", FRAMESIZE_XGA, 13}, {"hd", FRAMESIZE_HD, 13}, {"sxga", FRAMESIZE_SXGA, 14}, {"uxga", FRAMESIZE_UXGA, 14},
  {"qxga", FRAMESIZE_QXGA, 15},
};
const int CAM_SIZE_N = sizeof(CAM_SIZES) / sizeof(CAM_SIZES[0]);
const char* camSizeName(int fs) {
  for (int i = 0; i < CAM_SIZE_N; i++) if (CAM_SIZES[i].fs == fs) return CAM_SIZES[i].name;
  return "vga";
}

void govLog(const char* kind, const char* note);  // below (the governor's log)
volatile int camPhotoQ = 0;  // a photo for Gemini: this JPEG quality instead (lower = finer), 0 = the table's
void applyCamViewSize(sensor_t* sn) {
  sn->set_framesize(sn, (framesize_t)camViewSize);
  int q = 12;  // bigger pictures: a little more compression, or a frame gets too big for WiFi
  for (int i = 0; i < CAM_SIZE_N; i++) if (CAM_SIZES[i].fs == camViewSize) q = CAM_SIZES[i].q;
  if (camPhotoQ > 0) q = camPhotoQ;
  sn->set_quality(sn, q);
}

bool startCamera(bool jpeg) {
  // The camera needs one 32 KB block of internal RAM for its DMA. Without it, a start fails half-way and
  // leaves the driver's task (cam_task, top priority on core 0) spinning: the task watchdog restarts the
  // robot. Don't even try then - the caller retries in a moment.
  // (JPEG: its DMA buffer is kept from boot - esp_camera_keep_dma - then only small parts are needed:
  // the driver's task stack 2 KB, descriptors, its state)
  const size_t kept = esp_camera_kept_dma ? esp_camera_kept_dma() : 0;
  const size_t camNeed = kept >= 32768 || (jpeg && kept >= 16384) ? 4096 : 33000;
  if (heap_caps_get_largest_free_block(MALLOC_CAP_DMA | MALLOC_CAP_INTERNAL) < camNeed) {
    snprintf(camInitErr, sizeof(camInitErr), "skipped at %lu s: largest block %u (needs %u)", millis() / 1000,
             (unsigned)heap_caps_get_largest_free_block(MALLOC_CAP_DMA | MALLOC_CAP_INTERNAL), (unsigned)camNeed);
    return false;
  }
  camera_config_t config = {};
  config.ledc_channel = LEDC_CHANNEL_0;
  config.ledc_timer = LEDC_TIMER_0;
  config.pin_d0 = CAM_Y2;
  config.pin_d1 = CAM_Y3;
  config.pin_d2 = CAM_Y4;
  config.pin_d3 = CAM_Y5;
  config.pin_d4 = CAM_Y6;
  config.pin_d5 = CAM_Y7;
  config.pin_d6 = CAM_Y8;
  config.pin_d7 = CAM_Y9;
  config.pin_xclk = CAM_XCLK;
  config.pin_pclk = CAM_PCLK;
  config.pin_vsync = CAM_VSYNC;
  config.pin_href = CAM_HREF;
  config.pin_sccb_sda = CAM_SIOD;
  config.pin_sccb_scl = CAM_SIOC;
  config.pin_pwdn = CAM_PWDN;
  config.pin_reset = CAM_RESET;
  config.xclk_freq_hz = 10000000;  // (20 MHz: with the camera on, the WiFi lost 20 % of full-size packets)
  config.pixel_format = PIXFORMAT_RGB565; // ESP-DL needs raw RGB565
  config.frame_size = FRAMESIZE_QVGA;     // 320x240 = full TFT
  config.jpeg_quality = 12;
  config.fb_count = 2;                    // double-buffered for smooth video
  config.fb_location = CAMERA_FB_IN_PSRAM;
  config.grab_mode = CAMERA_GRAB_WHEN_EMPTY;
  if (jpeg) {                             // camera view: compressed by the sensor itself
    config.pixel_format = PIXFORMAT_JPEG;
    config.frame_size = FRAMESIZE_QXGA;   // buffers sized for the largest view size (2048 x 1536)
    config.jpeg_quality = 10;
    config.grab_mode = CAMERA_GRAB_LATEST;  // always the newest frame: low lag
  }

  esp_err_t err = esp_camera_init(&config);
  if (err != ESP_OK) {
    snprintf(modeError, sizeof(modeError), "error: camera init 0x%x", err);
    snprintf(camInitErr, sizeof(camInitErr), "0x%x at %lu s: internal free %u, largest block %u", err, millis() / 1000,
             heap_caps_get_free_size(MALLOC_CAP_INTERNAL), heap_caps_get_largest_free_block(MALLOC_CAP_DMA | MALLOC_CAP_INTERNAL));
    xlogSys("CAMERA start failed %s", camInitErr);
    Serial.println(modeError);
    return false;
  }
  modeError[0] = 0;
  sensor_t* sn = esp_camera_sensor_get();
  static bool pidLogged = false;
  if (sn && !pidLogged) {
    pidLogged = true;
    xlog("CAMERA sensor PID 0x%04X", (unsigned)sn->id.PID);
  }
  if (jpeg && sn) {
    if (requestedMode == MODE_WALK) applyCamViewSize(sn);   // RC: the size chosen on the page
    else {                                                  // face / Explore: 320 x 240 (decoded)
      sn->set_framesize(sn, FRAMESIZE_QVGA);
      sn->set_quality(sn, 10);
    }
    sn->set_bpc(sn, 1);      // black / white pixel correction, lens shading, gamma: a cleaner picture
    sn->set_wpc(sn, 1);
    sn->set_lenc(sn, 1);
    sn->set_raw_gma(sn, 1);
    camViewSizeChanged = false;
  }
  applyCamSharp(sn);
  return true;
}

// ---- Camera floor check (Explore) ----
// Learns the floor colour from a patch just in front of the feet, then walks up each
// image band until most samples stop looking like that floor. A close obstacle or wall
// cuts the floor off low in the image. Only ~3k pixel reads per frame.
const int FLOOR_TOP_ROW_LEVEL = 120;  // about the horizon with the head at mid tilt
const int FLOOR_TOP_ROW_DOWN = 8;     // head looking down: the whole image is floor ahead
volatile int floorTopRow = FLOOR_TOP_ROW_LEVEL;
const int FLOOR_BOTTOM_ROW = 236;

static inline void rgbAt(const uint8_t* buf, int w, int x, int y, int& r, int& g, int& b) {
  const uint8_t* p = buf + 2 * (y * w + x);  // camera RGB565 is big-endian
  r = (p[0] >> 3) << 1;                      // scale R and B to 6 bits like G
  g = ((p[0] & 7) << 3) | (p[1] >> 5);
  b = (p[1] & 0x1F) << 1;
}

void analyzeFloor(camera_fb_t* fb, int boundaryRow[3], int topRow) {
  const uint8_t* buf = fb->buf;
  const int w = fb->width;

  long sr = 0, sg = 0, sb = 0;
  int n = 0, r, g, b;
  for (int y = 222; y <= FLOOR_BOTTOM_ROW; y += 2)
    for (int x = 120; x <= 200; x += 4) { rgbAt(buf, w, x, y, r, g, b); sr += r; sg += g; sb += b; n++; }
  const int fr = sr / n, fg = sg / n, fbl = sb / n;
  long dev = 0;
  for (int y = 222; y <= FLOOR_BOTTOM_ROW; y += 2)
    for (int x = 120; x <= 200; x += 4) { rgbAt(buf, w, x, y, r, g, b); dev += abs(r - fr) + abs(g - fg) + abs(b - fbl); }
  const int thresh = max(18, (int)(3 * dev / n));  // textured floors get a wider tolerance

  const int bandW = w / 3;
  for (int band = 0; band < 3; band++) {
    int x0 = band * bandW + 4, x1 = (band + 1) * bandW - 4;
    int boundary = topRow, misses = 0;
    for (int y = FLOOR_BOTTOM_ROW; y >= topRow; y -= 4) {
      int total = 0, off = 0;
      for (int x = x0; x <= x1; x += 6) {
        rgbAt(buf, w, x, y, r, g, b);
        total++;
        if (abs(r - fr) + abs(g - fg) + abs(b - fbl) > thresh) off++;
      }
      if (off * 2 > total) {
        if (++misses >= 2) { boundary = y + 4; break; }  // two non-floor rows in a row
      } else {
        misses = 0;
      }
    }
    boundaryRow[band] = boundary;
  }
}

// ---- Camera motion check (Explore): "did I actually move?" ----
// The gait repeats every cycle, so a robot walking in place (legs sliding against an
// obstacle on a smooth floor) sees the same picture again at the same gait phase one
// cycle later, while a robot that really moves sees the scene shift further and further.
// Compare the newest small grey frame with the frames at the same gait phase one cycle
// (T) and two cycles (2T) ago:
//   moving -> diff(T) is large, or diff(2T) clearly bigger than diff(T) (scene drifts)
//   stuck  -> diff(T) and diff(2T) both small and about equal (only the periodic sway)
// The body's own gait sway cancels out because both comparisons are phase-matched.
const int MOT_W = 80, MOT_H = 60, MOT_FRAMES = 28;  // 4x downsampled, ~2.5 s history
struct MotFrame {
  uint8_t* px;
  unsigned long ms;
  float phase;
  uint8_t gait;
  bool valid;
};
MotFrame motRing[MOT_FRAMES];
int motHead = 0;
bool motAlloc = false;
volatile float cpgPhase = 0;         // loop(): current CPG phase (rad, 0..2pi)
volatile float cpgPeriodMs = 524;    // loop(): current gait cycle length
volatile uint8_t cpgGait = 0;        // loop(): Explore gait id, 0 = standing
volatile float motDiffT = 0, motDiff2T = 0, motNoise = 2;
volatile int motVerdict = 0;         // +1 moving, -1 not moving, 0 unknown
volatile unsigned long motMs = 0;    // when motVerdict was last updated
const float MOT_MOVING_MIN = 6;      // diff(T) above max(this, 3.5 x noise) = clearly moving

static void motDownsample(const uint8_t* buf, uint8_t* out) {
  for (int y = 0; y < MOT_H; y++) {
    const uint8_t* row = buf + 2 * ((y * 4 + 1) * 320);
    for (int x = 0; x < MOT_W; x++) {
      const uint8_t* p = row + 2 * (x * 4 + 1);
      int r = p[0] >> 3, g = ((p[0] & 7) << 3) | (p[1] >> 5), b = p[1] & 0x1F;
      out[y * MOT_W + x] = (uint8_t)(r * 2 + g * 2 + b);  // cheap luma, 0..219
    }
  }
}

static float motMad(const uint8_t* a, const uint8_t* b) {
  uint32_t sum = 0;
  for (int i = 0; i < MOT_W * MOT_H; i++) sum += abs((int)a[i] - (int)b[i]);
  return (float)sum / (MOT_W * MOT_H);
}

static float phaseDist(float a, float b) {
  float d = fabsf(a - b);
  return d > 3.14159f ? 6.28318f - d : d;
}

// Best phase-matched frame whose age is within [lo, hi] x the gait cycle
static int motFind(int cur, float loCycles, float hiCycles) {
  const MotFrame& c = motRing[cur];
  const float T = cpgPeriodMs;
  int best = -1;
  float bestD = 0.45f;  // max phase error (rad)
  for (int i = 0; i < MOT_FRAMES; i++) {
    const MotFrame& f = motRing[i];
    if (i == cur || !f.valid || f.gait != c.gait) continue;
    float age = (float)(c.ms - f.ms);
    if (age < loCycles * T || age > hiCycles * T) continue;
    float d = phaseDist(f.phase, c.phase);
    if (d < bestD) { bestD = d; best = i; }
  }
  return best;
}

// Light levels from the small grey frame (row 0 = far / up, row 59 = just ahead of the feet)
static float motRegionMean(const uint8_t* px, int y0, int y1, int x0, int x1) {
  uint32_t sum = 0;
  for (int y = y0; y < y1; y++)
    for (int x = x0; x < x1; x++) sum += px[y * MOT_W + x];
  return (float)sum / ((y1 - y0) * (x1 - x0));
}

void updateLight() {
  if (!motAlloc) return;
  const uint8_t* px = motRing[(motHead + MOT_FRAMES - 1) % MOT_FRAMES].px;
  if (!px) return;
  camLumaAll = motRegionMean(px, 0, MOT_H, 0, MOT_W);
  camLumaAhead = motRegionMean(px, 0, 15, 16, 64);
  camLumaNear = motRegionMean(px, 44, MOT_H, 20, 60);
  camLightMs = millis();
}

void updateMotion(camera_fb_t* fb) {
  if (!motAlloc) {
    for (int i = 0; i < MOT_FRAMES; i++) {
      motRing[i].px = (uint8_t*)heap_caps_malloc(MOT_W * MOT_H, MALLOC_CAP_SPIRAM);
      motRing[i].valid = false;
    }
    motAlloc = true;
  }
  const int cur = motHead;
  const int prev = (cur + MOT_FRAMES - 1) % MOT_FRAMES;
  MotFrame& f = motRing[cur];
  if (!f.px) return;
  motDownsample(fb->buf, f.px);
  f.ms = millis();
  f.phase = cpgPhase;
  f.gait = cpgGait;
  f.valid = true;
  motHead = (cur + 1) % MOT_FRAMES;

  if (f.gait == 0) {
    // Standing still: learn the camera noise floor from consecutive frames
    const MotFrame& p = motRing[prev];
    if (p.valid && p.gait == 0 && f.ms - p.ms < 300) motNoise = 0.8f * motNoise + 0.2f * motMad(f.px, p.px);
    motVerdict = 0;
    return;
  }
  const int k1 = motFind(cur, 0.7f, 1.4f);
  const int k2 = motFind(cur, 1.7f, 2.4f);
  if (k1 < 0 || k2 < 0) { motVerdict = 0; return; }
  const float d1 = motMad(f.px, motRing[k1].px);
  const float d2 = motMad(f.px, motRing[k2].px);
  motDiffT = d1;
  motDiff2T = d2;
  const float movingAbs = max(MOT_MOVING_MIN, 3.5f * motNoise);
  if (d1 > movingAbs || d2 > d1 * 1.3f + 0.8f) motVerdict = 1;
  else if (d2 < d1 * 1.12f + 0.5f) motVerdict = -1;
  else motVerdict = 0;
  motMs = f.ms;
}

// Face tracking: the detector (ESP-DL MSR01) is trained on upright faces and misses a head
// tilted more than ~20 deg. When it finds nothing, a half-size copy of the frame turned by
// +-30 / +-55 deg is searched too (one angle per frame, the one that worked last first) - a
// tilted face looks upright in one of them. Detection takes ~10 ms, so this costs little.
const float FACE_ROLLS[] = {30, -30, 55, -55};
volatile int faceRoll = 0;                 // tilt it found the face at last (web UI)

// dst (160 x 120) = src (320 x 240) turned by deg around the centre, half size.
// dst (u, v) comes from src (160 + 2 (c (u-80) - s (v-60)), 120 + 2 (s (u-80) + c (v-60)))
void rotateHalf(const uint16_t* src, uint16_t* dst, float deg) {
  const float a = deg * DEG_TO_RAD;
  const int32_t C = (int32_t)(cosf(a) * 2 * 65536), S = (int32_t)(sinf(a) * 2 * 65536);
  for (int v = 0; v < 120; v++) {
    int32_t sx = (160 << 16) - C * 80 - S * (v - 60);
    int32_t sy = (120 << 16) - S * 80 + C * (v - 60);
    for (int u = 0; u < 160; u++) {
      const int x = sx >> 16, y = sy >> 16;
      *dst++ = (x >= 0 && x < 320 && y >= 0 && y < 240) ? src[y * 320 + x] : 0;
      sx += C;
      sy += S;
    }
  }
}

void unrotateHalf(float u, float v, float deg, float* x, float* y) {
  const float a = deg * DEG_TO_RAD, c = cosf(a), sn = sinf(a);
  *x = 160 + 2 * (c * (u - 80) - sn * (v - 60));
  *y = 120 + 2 * (sn * (u - 80) + c * (v - 60));
}
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
void loop() {
  xl::holdFlash = streamClients > 0 || rcActive();  // settings wait: no camera pause under a viewer
  // driving / talking / walking (any leg command, Explore): the face stays awake, no dozing off mid-walk
  faceKeepAwake = rcActive() || aud::talkOn || currentCommand.length() > 0 || activeMode == MODE_EXPLORE || activeMode == MODE_DESK || activeMode == MODE_LIFE;
  govTick();
  gem::update();  // the conversation: faces, start / stop, the quiet timeout
  saverPower();
  dnsServer.processNextRequest();
  
  // --- Mode switching: walk engine / face tracking / explore ---
  int wantMode = requestedMode;
  if (wantMode != activeMode) {
    if (wantMode == MODE_WALK) {
      // At once: the camera task owns the TFT and shows the face itself (waiting for
      // the camera to stop would hang with the RC video on: it never stops).
      enterMode(MODE_WALK);
    } else if (camReady || camFailed) {
      enterMode(wantMode);
    }
  }

  // The TFT belongs to the camera task while a camera mode is running
  bool loopOwnsDisplay = (activeMode == MODE_WALK) || activeMode == MODE_DESK || activeMode == MODE_LIFE || (activeMode == MODE_EXPLORE && camFailed);  // (desk: the face, the camera only peeks)
  static bool hadDisplay = true;
  if (loopOwnsDisplay && !hadDisplay) {
    currentFaceFrames = nullptr;  // force a face redraw over the last camera frame
    enterIdle();
  }
  hadDisplay = loopOwnsDisplay;
  if (batEmpty) {
    static unsigned long batScreenMs = 0;
    if (millis() - batScreenMs > 3000) { batScreenMs = millis(); showBatteryScreen(); }
  }
  faceShowing = loopOwnsDisplay && !batEmpty;
  // While the RC video streams the camera task also pushes the face; fewer face frames keep the
  // video fast. Otherwise ~30 a second for smooth eyes.
  // the Battery Saver face's mouth: none outside a chat, a line while it listens, open with the voice
  saverMouth = gem::state == gem::S_OFF ? -1.0f : gem::state == gem::S_SPEAKING ? fminf(1.0f, gem::outLvl * 6) : 0.0f;
  faceFpsWanted = camViewWanted || rcActive() ? min(12, faceFps) : gem::state == gem::S_SPEAKING ? min(20, faceFps) : aud::talkOn ? min(15, faceFps) : faceFps;  // (talking: 20 for the lips)
  // A full-frame style (every style but Battery Saver: 153 KB to the screen each frame) at 30 a second never lets the
  // face task rest: the web server's replies jump from ~90 ms to over 2 s (20 fps and below:
  // ~100 ms). Capped at 15, 12 during a chat (its audio and TLS need the room).
  if (faceEng.style != fe::ST_SAVER) faceFpsWanted = min((int)faceFpsWanted, gem::state != gem::S_OFF ? 12 : 15);
  govMark(GS_MODES);

  updateWifiSetup();  // a network picked on the Settings page
  if (bootWifiPending) bootWifiFinish();  // the boot scan: hotspot + join when it's done
  else wifiKeepUp();  // the home network: never searching while the hotspot is in use
  phonePingUpdate();  // the hotspot phone's link, for the governor's log
  govMark(GS_WIFI);

  // Queued /servo writes (calibrator)
  // (with ms=: the robot glides there itself, eased, a step every loop - big steps from the page
  //  make the legs judder)
  {
    static float gFrom[16], gTo[16];
    static bool gOn[16] = {false};
    static unsigned long gT0 = 0, gDur = 0;
    if (pendingServoAny) {
      pendingServoAny = false;
      gT0 = millis();
      gDur = pendingServoMs;
      for (int i = 0; i < 16; i++) {
        const float to = pendingServoDeg[i];
        if (isnan(to)) continue;
        pendingServoDeg[i] = NAN;
        gFrom[i] = servoRawKnown[i] ? servoRawNow[i] : to;
        gTo[i] = to;
        gOn[i] = true;
      }
    }
    const unsigned long nowG = millis();
    for (int i = 0; i < 16; i++) {
      if (!gOn[i]) continue;
      const float u = gDur ? min(1.0f, (nowG - gT0) / (float)gDur) : 1.0f, e = u * u * (3 - 2 * u);
      const float a = gFrom[i] + (gTo[i] - gFrom[i]) * e;
      pwm.writeMicroseconds(i, (uint16_t)lroundf(732 + a * (2929 - 732) / 180.0f));
      servoRawNow[i] = a;
      servoRawKnown[i] = true;
      calPinMs[i] = nowG ? nowG : 1;
      for (int c = 0; c < 8; c++)
        if (mappedPins[c] == i) { currentAngle[c] = calUnmap(c, a); legsPowered = legsPoseKnown = true; }
      if (u >= 1) gOn[i] = false;
    }
  }

  pollTof();
  imuUpdate();
  yawSignFromTurns();
  govMark(GS_SENSORS);

  // RC head (walk mode): follow the joystick, at most ~360 deg/s so it doesn't jerk
  if (calDirty && activeMode == MODE_WALK) {  // head calibration panel
    calDirty = false;
    headSlewTo(calPan, calTilt);  // glides there
  }
  // Chicken head: the head holds its world direction - level while the body pitches, its heading while the body
  // turns - quick (gyro-fed) and smooth (a stiff critically damped spring). Walk mode, standing or walking; an
  // emote, the RC joystick or the calibration panel take the head back.
  {
    static bool chkWas = false;
    const bool chkRun = chickenOn && activeMode == MODE_WALK && requestedMode == MODE_WALK && !rcHeadActive && !calDirty &&
                        (currentCommand == "" || currentCommand.startsWith("smooth_") || currentCommand.startsWith("step_") || currentCommand.startsWith("sharp_"));
    static float yaw0 = 0, hp = 0, ht = 0, vp = 0, vt = 0, sentP = -999, sentT = -999;
    static unsigned long lastMs = 0;
    const unsigned long now = millis();
    if (chkRun) {
      headSlewCancel();
      const float yawL = yawLeftSign ? yawLeftSign * imuYawAngle : 0;  // + = the body turned left
      if (!chkWas) { yaw0 = yawL; hp = emoPanNow; ht = emoTiltNow; vp = vt = 0; lastMs = now; sentP = sentT = -999; }
      const float dt = constrain((now - lastMs) / 1000.0f, 0.001f, 0.1f);
      lastMs = now;
      if (fabsf(yawL - yaw0) > 75) yaw0 += (yawL - yaw0) > 0 ? (yawL - yaw0 - 75) : (yawL - yaw0 + 75);  // past the neck's reach: follow
      const float pitch = asinf(constrain(chkG[1], -1.0f, 1.0f)) * 57.2958f;  // + = nose down (the walk's convention)
      const float tp = constrain(PAN_MID - (yawL - yaw0) * (panPlusIsLeft ? 1 : -1), PAN_MIN + 3, PAN_MAX - 3);
      const float tt = constrain(TILT_MID - (pitch - levelTrim), TILT_MIN + 3, TILT_MAX - 6);  // nose down -> head up
      auto spring = [&](float& x, float& v, float target) {
        const float w = 22;  // stiff: ~0.15 s to settle
        const float acc = constrain(w * w * (target - x) - 2 * w * v, -4000.0f, 4000.0f);
        v = constrain(v + acc * dt, -500.0f, 500.0f);
        x += v * dt;
      };
      spring(hp, vp, tp);
      spring(ht, vt, tt);
      panWho = "chicken";
      if (fabsf(hp - sentP) >= 0.3f) { setHeadServoF(HEAD_PAN_PIN, hp); sentP = hp; }
      if (fabsf(ht - sentT) >= 0.3f) { setHeadServoF(HEAD_TILT_PIN, ht); sentT = ht; }
      emoPanNow = (int)lroundf(hp);
      emoTiltNow = (int)lroundf(ht);
    } else if (chkWas && !chickenOn && activeMode == MODE_WALK && !rcHeadActive) {
      headSlewTo(PAN_MID, TILT_MID);  // switched off: glide back to straight ahead
    }
    chkWas = chkRun;
  }
  if (activeMode == MODE_WALK && rcHeadActive) {
    headSlewCancel();  // the joystick has the head
    static float rcPan = PAN_MID, rcTilt = TILT_MID;
    static unsigned long rcLastMs = 0;
    const unsigned long now = millis();
    if (now - rcLastMs > 200) {  // (re)starting: from where the head is now
      rcPan = emoPanNow;
      rcTilt = emoTiltNow;
    }
    const float step = 0.36f * min(now - rcLastMs, 50UL);  // (eased 150 deg/s is not responsive enough)
    rcLastMs = now;
    rcPan += constrain(rcPanTarget - rcPan, -step, step);
    rcTilt += constrain(rcTiltTarget - rcTilt, -step, step);
    const int p = (int)lroundf(rcPan), tl = (int)lroundf(rcTilt);
    panWho = "rc";
    if (p != emoPanNow) setHeadServoAngle(HEAD_PAN_PIN, p);
    if (tl != emoTiltNow) setHeadServoAngle(HEAD_TILT_PIN, tl);
    emoPanNow = p;
    emoTiltNow = tl;
    if (fabsf(rcPanTarget - rcPan) < 0.5f && fabsf(rcTiltTarget - rcTilt) < 0.5f) rcHeadActive = false;
  }

  if (activeMode == MODE_FACE && headTargetDirty) {
    // Apply the tracker's latest head target (I2C stays on this core)
    headTargetDirty = false;
    headSlewTo(headPanTarget, headTiltTarget);  // glides after the face (steps of up to 9 deg per frame)
  }
  if (activeMode == MODE_EXPLORE) exploreUpdate();
  if (activeMode == MODE_DESK && !robotFallen) deskm::deskTick(millis());  // (fallen: its body moves would push the legs)
  else if (activeMode == MODE_DESK) deskbody::now = deskbody::MV_NONE;
  if (activeMode == MODE_LIFE) lifem::lifeTick(millis());  // life mode: Oreo on its own (life_mode.h)
  headSlewUpdate();  // the eased head moves asked for above (and by Explore)
  govMark(GS_HEAD);
  playUpdate();
  fallUpdate();
  chargeUpdate();
  govMark(GS_PLAY);

  // Telemetry for the log: every second while exploring, every 30 s otherwise
  // RC mode on the page: the log pauses so the camera never stops for a flash write
  static bool rcWas = false;
  const bool rcNow = rcActive();
  if (rcNow != rcWas) {
    rcWas = rcNow;
    if (rcNow && xl::sdOn) {
      xlog("RC mode (log on the SD card: keeps logging, the camera doesn't pause)");
    } else if (rcNow) {
      xlog("RC mode: log paused (the camera would have to stop for every flash write)");
      xl::skippedLines = 0;
      xl::paused = true;
    } else {
      rcSpeed = 1.0f;  // the throttle belongs to RC mode: normal speed again when it closes
      xl::paused = false;
      xlog("RC mode ended: log resumed (%u lines not logged)", (unsigned)xl::skippedLines);
    }
  }

  static unsigned long lastTelemMs = 0;
  if (millis() - lastTelemMs >= (activeMode == MODE_EXPLORE ? 2000UL : 30000UL)) {
    lastTelemMs = millis();
    if (activeMode == MODE_EXPLORE) {
      xlog("T %s tof=%d raw=%d/%d spd=%d tilt=%.0f fast=%.0f yaw=%.0f rate=%.0f shake=%.2f jolt=%.2f "
           "mot=%d %.1f/%.1f/%.1f free=%.2f/%.2f/%.2f light=%.0f/%.0f/%.0f dark=%d veer=%d caution=%d "
           "fails=%d bat=%.2fV heap=%u camgap=%lu",
           (const char*)exploreStateName, (int)tofMm, (int)tofRawMm, (int)tofRawStatus,
           (int)(cpgSpeed * 100 + 0.5f), imuTiltDeg, imuTiltFastDeg, imuYawAngle, imuYawRate,
           imuShakeRms, imuJolt, (int)motVerdict, (float)motDiffT, (float)motDiff2T, (float)motNoise,
           (float)camFree[camLeftBand()], (float)camFree[1], (float)camFree[camRightBand()],
           (float)camLumaAll, (float)camLumaAhead, (float)camLumaNear, exCamDark ? 1 : 0, exVeer,
           exCaution() ? 1 : 0, exFails, (float)battVolts, ESP.getFreeHeap(), (unsigned long)xl::lastCamGapMs);
    } else {
      // every 30 s, in every mode (xlogSys: walk mode isn't 'recording'): what the robot is coping with
      xlogSys("T mode=%s cmd=%s bat=%.2fV temp=%.0fC | ram int %u min %u big %u dma %u psram %u | web %d tls %d video %d hotspot %d | "
              "wifi %s rssi %d ch %d | cam %d %.0ffps video %.0ffps | loop max %.0fms face %.0ffps | chat %d talk %d rc %d",
              MODE_NAMES[activeMode], currentCommand.length() ? currentCommand.c_str() : "-", (float)battVolts, temperatureRead(),
              (unsigned)heap_caps_get_free_size(MALLOC_CAP_INTERNAL), (unsigned)heap_caps_get_minimum_free_size(MALLOC_CAP_INTERNAL),
              (unsigned)heap_caps_get_largest_free_block(MALLOC_CAP_INTERNAL), (unsigned)heap_caps_get_largest_free_block(MALLOC_CAP_DMA | MALLOC_CAP_INTERNAL),
              (unsigned)ESP.getFreePsram(), clientCount(cmd_httpd), clientCount(tls_httpd), clientCount(stream_httpd),
              (int)WiFi.softAPgetStationNum(), WiFi.status() == WL_CONNECTED ? "up" : "down",
              WiFi.status() == WL_CONNECTED ? (int)WiFi.RSSI() : 0, (int)WiFi.channel(), camReady ? 1 : 0, (float)camFps, (float)streamFps,
              (float)govLoopMaxMs, (float)faceFpsNow, (int)gem::state, aud::talkOn ? 1 : 0, rcActive() ? 1 : 0);
    }
  }

  govMark(GS_TELEM);
  // Battery + OLED status only 5x per second (a full OLED refresh blocks ~25 ms,
  // which would make every loop - CPG, IMU, ToF - slow)
  static unsigned long lastOledMs = 0;
  const bool oledLive = gem::state == gem::S_LISTENING;  // (a chat listening: the live "hearing you" meter, 5 Hz)
  if (millis() - lastOledMs >= (!oledLive && (rcActive() || aud::talkOn || saverIdle) ? 1000UL : 200UL)) {  // (governor: driving first; saver)
    lastOledMs = millis();
    // Read Battery with EMA filter
    static float filteredVoltage = 0;
    // The reading: raw analogRead,
    // 1:11 divider on GPIO 3, times "batcal" (1.166 by default, the creator's value).
    // /exParams?batnow=8.25 can still set batcal from a known voltage.
    // 32 readings, the 8 lowest and 8 highest thrown away, the middle 16 averaged: the divider
    // (100k / 10k) is a weak source for the ADC, single readings jump by tens of mV at the pin.
    // (A 100 nF capacitor from GPIO 3 to GND steadies it in hardware.)
    uint16_t rs[32];
    for (int i = 0; i < 32; i++) {
      const uint16_t v = analogRead(BATT_PIN);
      int k = i;
      while (k > 0 && rs[k - 1] > v) { rs[k] = rs[k - 1]; k--; }
      rs[k] = v;
    }
    long rawBatt = 0;
    for (int i = 8; i < 24; i++) rawBatt += rs[i];
    batPinMv = (rawBatt / 16.0f) / 4095.0f * 3300.0f;  // uncalibrated pin mV (what batcal scales)
    float voltage = batPinMv / 1000.0f * 11.0f * BAT_CAL;
    filteredVoltage = (filteredVoltage == 0 || millis() < 4000) ? voltage : (filteredVoltage * 0.9 + voltage * 0.1);  // settle after boot
    battVolts = filteredVoltage;
    // Battery log on the SD card, one line a minute (a full-charge drain test): uptime, volts
    // (30 s average), %, mode, legs powered, the command, face fps. A "boot" line at each start.
    static unsigned long batLogMs = 0;
    if (sdSizeMB >= 0 && millis() > 20000 && (batLogMs == 0 || millis() - batLogMs >= 60000)) {
      static const char* BAT_HDR = "uptime_s,volts,pct,mode,legs_powered,command,face_fps";
      if (batLogMs == 0) sdAppend("/logs/battery.csv", BAT_HDR, "boot,,,,,,\n");
      char line[120];
      snprintf(line, sizeof(line), "%lu,%.2f,%d,%s,%d,%.40s,%.0f\n", millis() / 1000, batSlowV, (int)batPctSlow,
               MODE_NAMES[activeMode], legsPowered ? 1 : 0, currentCommand.length() ? currentCommand.c_str() : "-",
               (float)faceFpsNow);
      sdAppend("/logs/battery.csv", BAT_HDR, line);  // the log task writes it: the loop never waits for the card
      batLogMs = millis();
    }
  
    // 2S LiPo: BAT_EMPTY_V (empty for this robot - it browns out below) to 8.4 V (full)
    int battPct = batPercentOf(filteredVoltage);
    if(battPct > 100) battPct = 100;
    if(battPct < 0) battPct = 0;
    battPercent = battPct;
    batteryUpdate(voltage);
    batShownUpdate();
    powerDownCheck();
    if (shutdownReq) shutdownNow();

    // Tilt from the MPU6050 (m/s^2)
    const float ax = imuAcc[0] * 9.80665f, ay = imuAcc[1] * 9.80665f;
    String tiltState = "LEVEL";
    if (!imuOk) tiltState = "NO IMU";
    else if (ay > 5.0) tiltState = "FRONT";
    else if (ay < -5.0) tiltState = "BACK";
    else if (ax > 5.0) tiltState = "LEFT";
    else if (ax < -5.0) tiltState = "RIGHT";
  
    oledHealth();  // answers? set up again now and then; frees a stuck bus
    oledDraw(batPctShown >= 0 ? batPctShown : battPct, filteredVoltage);  // the chest display (oled_ui.h)
  }
  govMark(GS_OLED);

  // Head pats (the touch sensor): a "pat brain" instead of one fixed pose. It tells a tap,
  // a double tap and a hand held on its head (petting) apart, remembers the last pats and picks a reaction
  // that fits - never the same one twice in a row: a boop / head tilt / wiggle / nuzzle for a tap, play for a
  // double tap, leaning into the hand and melting for petting, more and more excited with many pats, "ok,
  // enough!" past ~8 in 25 s, "oh, you're here!" after a long while, and a groggy wake-up when lying down.
  // Timers / alarms / sleep timer (desk_clock.h): while one rings, a touch on the head is its (snooze / stop),
  // not a pat
  // RC deadman: a walk from the RC screen lives only while the page keeps saying "still holding" (hold=1 every
  // 300 ms), so a lost "stop" on a bad link can't leave it walking. 1.2 s: one missed
  // refresh on this link is common - 1 s would stutter.
  if (rcDriveLease && millis() - rcDriveMs > 1200) {
    rcDriveLease = false;
    if (currentCommand.length()) {
      xlogSys("RC lease expired: stopped (%s - the page went quiet for 1.2 s)", currentCommand.c_str());
      currentCommand = "";
    }
  }
  legsMoving = currentCommand.length() > 0;  // (for the web watchdog's reboot check, read from another task)
  clk::tick(millis());
  if (clk::ringing() || clk::touchDownMs) pat::ringTail = pat::ringHead;
  mus::tick(millis());  // the next song, bobbing along (music.h)
  patUpdate();

  govMark(GS_TOUCH);
  static String lastCommand = "";

  // Emotes only run in walk mode (they draw on the TFT); Explore drives the smooth_ gaits
  // and the non-blocking step_ turns
  bool commandsAllowed = (activeMode == MODE_WALK) || activeMode == MODE_DESK || activeMode == MODE_LIFE ||  // (desk: poses + emotes; gaits refused below)
                         (activeMode == MODE_EXPLORE &&
                          (currentCommand.startsWith("smooth_") || currentCommand.startsWith("step_") || currentCommand.startsWith("sharp_")));
  // Walk mode: the smooth gait's speed follows the RC speed slider, eased at 1.5 per second.
  // It's the CPG clock's rate, not the gait frequency: the stride stays where it is, it just
  // runs faster or slower - no jump when the slider moves mid-step.
  if (activeMode == MODE_WALK) {
    static unsigned long spdMs = 0;
    const unsigned long nowS = millis();
    const float dts = spdMs ? min((nowS - spdMs) / 1000.0f, 0.1f) : 0.0f;
    spdMs = nowS;
    cpgSpeed += constrain(rcSpeed - cpgSpeed, -1.5f * dts, 1.5f * dts);
  }
  // Emotes get matching props on the screen (the scene engine, props only): started with the
  // emote, stopped when it ends
  // Lying on its side / back: no leg command runs (the page, RC, voice, a pat's reaction) - the legs would push
  // against the floor. Upright again (fallUpdate) and they work again.
  if (robotFallen && currentCommand != "") {
    static unsigned long refusedMs = 0;
    if (millis() - refusedMs > 3000) { refusedMs = millis(); xlog("FALL: '%s' refused - lying on its side", currentCommand.c_str()); }
    currentCommand = "";
  }
  static String ovCmd = "";
  static bool ovOn = false;
  if (currentCommand != ovCmd) {
    if (ovOn) { faceScene("stop"); ovOn = false; }
    ovCmd = currentCommand;
    const char* ov = emoteProps(currentCommand.c_str());
    if (ov && commandsAllowed && activeMode == MODE_WALK) { faceScene(ov); ovOn = true; }
    // the emote's own sound (the page's "Emote sounds" switch); skipped while talking / RC talk / a song
    const char* snd = emoteSound(currentCommand.c_str());
    if (snd && emoteSndOn && commandsAllowed && !aud::talkOn && !aud::playing) {
      playSfx(snd);
      voiceLastMs = millis();
    }
  }
  if (currentCommand != "" && commandsAllowed) {
    if (!currentCommand.startsWith("smooth_") && !currentCommand.startsWith("step_") && !currentCommand.startsWith("sharp_")) headSlewCancel();  // an emote has the head
    if (gaitSteadyDpad && (currentCommand == "forward" || currentCommand == "backward"))
      currentCommand = currentCommand == "forward" ? "smooth_steady" : "smooth_steady_back";  // (the page's switch)
    // desk mode never walks: any gait command is refused (on the desk only the body's small moves)
    if (activeMode == MODE_DESK && !deskWalkActive && (currentCommand.startsWith("smooth_") || currentCommand.startsWith("step_") || currentCommand.startsWith("sharp_") ||
                                    currentCommand == "forward" || currentCommand == "backward" || currentCommand == "left" ||
                                    currentCommand == "right" || currentCommand.startsWith("creator"))) {
      xlog("DESK gait refused: %s", currentCommand.c_str());
      currentCommand = "";
    }
    // desk mode with the legs folded (the page's "Fold legs"): no leg moves at all - emotes, poses, pats
    if (activeMode == MODE_DESK && deskbody::folded && currentCommand.length()) {
      xlog("DESK legs folded: %s skipped", currentCommand.c_str());
      currentCommand = "";
    }
    String cmd = currentCommand;
    if (cmd == "forward") runWalkPose();
    else if (cmd == "backward") runWalkBackward();
    else if (cmd == "left") runTurnLeft();
    else if (cmd == "right") runTurnRight();
    else if (cmd == "rest") {
      runRestPose();
      delay(400);    // settle on the belly
      legsRelax();   // then no power to the legs while lying
      if (currentCommand == "rest") currentCommand = "";
    }
    else if (cmd == "stand") { runStandPose(1); emoHead(0, 0); if (currentCommand == "stand") currentCommand = ""; }
    else if (cmd == "sit") {  // a dog's sit: front legs standing, back legs down as in rest (the dead emote's pose, no face)
      runStandPose(0);
      moveSmoothHelper(600, -999, -999, -999, -999, REST_BACK[0], REST_BACK[1], REST_BACK[2], REST_BACK[3]);
      if (currentCommand == "sit") currentCommand = "";
    }
    else if (cmd == "sit_elegant") {
      setFaceWithMode("content", FACE_ANIM_ONCE);
      // front legs first, then the back ones (like the cute emote: all at once is a belly flop)
      // the front four at their MIN (setServoAngle maps the built-in min onto the calibration page's)
      moveSmoothHelper(700, (int)LEG_MIN0[0], (int)LEG_MIN0[1], (int)LEG_MIN0[2], (int)LEG_MIN0[3], -999, -999, -999, -999);
      moveSmoothHelper(800, -999, -999, -999, -999, REST_BACK[0], REST_BACK[1], REST_BACK[2], REST_BACK[3]);
      if (currentCommand == "sit_elegant") currentCommand = "";
    }
    else if (cmd == "curious") runCuriousEmote();
    else if (cmd == "happy") runHappyEmote();
    else if (cmd == "excited") runExcitedEmote();
    else if (cmd == "stretch") runStretchEmote();
    else if (cmd == "sleepy") runSleepyEmote();
    else if (cmd == "scared") runScaredEmote();
    else if (cmd == "sneeze") runSneezeEmote();
    else if (cmd == "love") runLoveEmote();
    else if (cmd == "angry") runAngryEmote();
    else if (cmd == "sad") runSadEmote();
    else if (cmd == "think") runThinkEmote();
    else if (cmd == "peekaboo") runPeekabooEmote();
    else if (cmd == "dizzy") runDizzyEmote();
    else if (cmd == "hiccup") runHiccupEmote();
    else if (cmd == "yawn") runYawnEmote();
    else if (cmd == "shiver") runShiverEmote();
    else if (cmd == "celebrate") runCelebrateEmote();
    else if (cmd == "tap") runTapFootEmote();
    else if (cmd == "bounce") runBounceEmote();
    else if (cmd == "wiggle") runWiggleEmote();
    else if (cmd == "sniff") runSniffEmote();
    else if (cmd == "laugh") runLaughEmote();
    else if (cmd == "pounce") runPounceEmote();
    else if (cmd == "lookaround") runLookAroundEmote();
    else if (cmd == "headbang") runHeadbangEmote();
    else if (cmd == "faint") runFaintEmote();
    else if (cmd == "twirl") runTwirlEmote();
    else if (cmd == "yoga") runYogaEmote();
    else if (cmd == "sway") runSwayEmote();
    else if (cmd == "robot") runRobotEmote();
    else if (cmd == "tada") runTadaEmote();
    else if (cmd == "playbow") runPlayBowEmote();
    else if (cmd == "huh") runHuhEmote();
    else if (cmd == "scratch") runScratchEmote();
    else if (cmd == "shakeoff") runShakeOffEmote();
    else if (cmd == "knead") runKneadEmote();
    else if (cmd == "beg") runBegEmote();
    else if (cmd == "loaf") runLoafEmote();
    else if (cmd == "swat") runSwatEmote();
    else if (cmd == "startle") runStartleEmote();
    else if (cmd == "crabrave") runCrabRaveEmote();
    else if (cmd == "crabrave1") runCrabRave1Emote();
    else if (cmd == "musicdance") runMusicDanceEmote();
    else if (cmd == "pat_boop") runBoopEmote();
    else if (cmd == "pat_nuzzle") runNuzzleEmote();
    else if (cmd == "petting") runPettingEmote();
    else if (cmd == "pat_wake") runPatWakeEmote();
    else if (cmd == "pat_hello") runPatHelloEmote();
    else if (cmd == "pat_enough") runPatEnoughEmote();
    else if (cmd == "wave") runWavePose(false);
    else if (cmd == "wave2") runWavePose(true);
    else if (cmd == "dance") runDancePose();
    else if (cmd == "shy") runShyEmote();
    else if (cmd == "hide") runHideEmote();
    else if (cmd == "sneaky") runSneakyEmote();
    else if (cmd == "proud") runProudEmote();
    else if (cmd == "bored") runBoredEmote();
    else if (cmd == "jam") runJamEmote();
    else if (cmd == "sulk") runSulkEmote();
    else if (cmd == "kiss") runKissEmote();
    else if (cmd == "stomp") runStompEmote();
    else if (cmd == "swaydance") runSwayDanceEmote();
    else if (cmd == "bob") runBobEmote();
    else if (cmd == "peek") runPeekEmote();
    else if (cmd == "doggyshake") runDoggyShakeEmote();
    else if (cmd == "bowwiggle") runBowWiggleEmote();
    else if (cmd == "highfive") runHighFiveEmote();
    else if (cmd == "march") runMarchEmote();
    else if (cmd == "hula") runHulaEmote();
    else if (cmd == "bodynod") runBodyNodEmote();
    else if (cmd == "twistlook") runTwistLookEmote();
    else if (cmd == "squats") runSquatsEmote();
    else if (cmd == "shimmy") runShimmyEmote();
    else if (cmd == "itchkick") runItchKickEmote();
    else if (xEmoteFind(cmd.c_str()) >= 0) runXEmote(xEmoteFind(cmd.c_str()));  // the emote library
    else if (cmd == "swim") runSwimPose();
    else if (cmd == "point") runPointPose();
    else if (cmd == "pushup") runPushupPose();
    else if (cmd == "bow") runBowPose();
    else if (cmd == "cute") runCutePose();
    else if (cmd == "freaky") runFreakyPose();
    else if (cmd == "worm") runWormPose();
    else if (cmd == "shake") runShakePose();
    else if (cmd == "shrug") runShrugPose();
    else if (cmd == "dead") runDeadPose();
    else if (cmd == "crab") runCrabPose();
    else if (cmd == "nodyes") runNodYes();
    else if (cmd == "nodno") runNodNo();
    else if (cmd == "gocrazy") runGoCrazyPose();
    else if (cmd == "patted") runPattedPose();
    else if (cmd == "step_left") stepTurnUpdate(true);    // creator's turn, one frame per pass
    else if (cmd == "step_right") stepTurnUpdate(false);
    else if (cmd == "sharp_left") sharpTurnUpdate(true);    // the page's Sharp L / R: the creator's turn, smooth
    else if (cmd == "sharp_right") sharpTurnUpdate(false);
    else if (cmd == "smooth_walk") { loadWalkPreset(0); }
    else if (cmd == "smooth_walk_back") { loadWalkPreset(1); }
    else if (cmd == "smooth_steady") { loadWalkPreset(0); }  // (the same tuned trot - and smooth_walk is one too when "everywhere" is on)
    else if (cmd == "smooth_steady_back") { loadWalkPreset(1); }
    else if (cmd == "smooth_steady_level") { loadWalkPreset(0); }       // the steady level-gait
    else if (cmd == "smooth_steady_level_back") { loadWalkPreset(1); }
    else if (cmd == "smooth_walk_left") { loadWalkPreset(2); }
    else if (cmd == "smooth_walk_right") { loadWalkPreset(3); }
    else if (cmd == "smooth_sharp_left") { loadWalkPreset(4); }
    else if (cmd == "smooth_sharp_right") { loadWalkPreset(5); }
    else if (cmd == "smooth_fwd_left") { loadWalkPreset(6); }
    else if (cmd == "smooth_fwd_right") { loadWalkPreset(7); }
    else if (cmd == "smooth_creator_left") { loadWalkPreset(8); }
    else if (cmd == "smooth_creator_right") { loadWalkPreset(9); }
    else if (cmd == "smooth_side_left") { loadWalkPreset(10); }   // sideways, still facing ahead
    else if (cmd == "smooth_balanced") { loadWalkPreset(12); }     // the balanced walk (symmetric trot, IMU level)
    else if (cmd == "smooth_balanced_back") { loadWalkPreset(13); }
    else if (cmd == "smooth_trot") { loadWalkPreset(14); }          // the diagonal trot (speed / lift / hip swing: /gait)
    else if (cmd == "smooth_trot_back") { loadWalkPreset(15); }
    else if (cmd == "smooth_nav") { loadWalkPreset(0); sw_frequency = (navVx < -0.01f ? -1.0f : 1.0f) * fabsf(walkFwd.freq); }
    else if (cmd == "smooth_side_right") { loadWalkPreset(11); }
    else if (cmd == "smooth_climb") {  // Explore: forward walk, legs lift higher and swing further
      loadWalkPreset(0);
      for (int i = 0; i < 8; i++) sw_amp_mapped[i] *= EX_CLIMB_AMP;
    }
    // smooth_tuned: uses params from /tune_walk, no preset override

    // D-pad walk / the creator's spin let go (RC: button released): stand at once. These
    // return mid-step when the command changes; the stand further down only comes if the
    // command had already run for a whole loop pass before (one call runs several cycles), so
    // after a single press the legs would stay where the step happened to be.
    if ((cmd == "forward" || cmd == "backward" || cmd == "left" || cmd == "right") && currentCommand != cmd) {
      runStandPose(currentCommand == "" ? 1 : 0);
    }
    
    // Run CPG loop for any smooth walk variant
    if (cmd.startsWith("smooth_")) {
      unsigned long currentMillis = millis();
      // Starting, or another walk (forward -> a turn ...): blend from where the legs are into the
      // gait over 400 ms. The gait's first frame is up to ~40 deg from the stand pose (and from the
      // last walk): snapping all 8 legs there at once would jolt.
      static String blendCmd = "";
      static unsigned long blendMs = 0;
      static float blendFrom[8];
      // Switching gaits WHILE walking (straight <-> curve: Explore does it every second or two): cross-fade from the
      // old gait still running to the new one, both on the same clock (fading from a frozen snapshot of the
      // legs makes them barely move for ~150 ms: a visible hitch at every steering change).
      static bool liveBlend = false;
      static float lbBase[8], lbAmp[8], lbPhase[8], lbFreq = 0;
      if (sw_oldMillis == 0 || cmd != blendCmd) {
        liveBlend = sw_oldMillis != 0 && cpgLastValid;
        if (liveBlend) {
          memcpy(lbBase, cpgLastBase, sizeof(lbBase));
          memcpy(lbAmp, cpgLastAmp, sizeof(lbAmp));
          memcpy(lbPhase, cpgLastPhase, sizeof(lbPhase));
          lbFreq = cpgLastFreq;
        }
        blendCmd = cmd;
        blendMs = currentMillis;
        for (int i = 0; i < 8; i++) blendFrom[i] = currentAngle[sw_servos[i]];
      }
      const float bu = min(1.0f, (currentMillis - blendMs) / 400.0f), be = bu * bu * (3 - 2 * bu);
      if (sw_oldMillis == 0) sw_oldMillis = currentMillis;
      sw_innerTime += (currentMillis - sw_oldMillis) * (double)cpgSpeed;
      sw_oldMillis = currentMillis;

      // Walking straight: hold the heading the walk started with (gyro). Hips: 0, 1 = left side, 4, 5 = right
      float scaleL = 1, scaleR = 1;
      const bool sideCmd = cmd == "smooth_side_left" || cmd == "smooth_side_right";
      const bool balCmd = cmd.startsWith("smooth_balanced") || cmd.startsWith("smooth_trot");  // (the trot: symmetric too)
      const bool straightCmd = cmd == "smooth_walk" || cmd == "smooth_walk_back" || cmd.startsWith("smooth_steady") || cmd == "smooth_climb" || sideCmd || balCmd;
      const bool straight = headHoldOn && straightCmd;
      // the walk's own pull, taken out up front (forward only; + = the left strides shorter), so the gyro
      // doesn't have to steer against it all the time. GET /gait?trim=
      const float trimF = (straightCmd && !sideCmd && !balCmd && !cmd.endsWith("_back")) ? walkTrim : 0.0f;  // (sideways: sideBal; balanced: symmetric)
      static String holdCmd = "";
      static float hdg0 = 0, hdgInt = 0;
      static unsigned long holdMs = 0;
      if (straight && yawLeftSign != 0) {
        const float hdg = yawLeftSign * imuYawAngle;  // + = left
        if (cmd != holdCmd || be < 0.05f) { holdCmd = cmd; hdg0 = hdg; hdgInt = 0; holdMs = currentMillis; }
        const float hdt = min(currentMillis - holdMs, 100UL) / 1000.0f;
        holdMs = currentMillis;
        const float err = hdg0 - hdg;  // + : it drifted right, steer left
        hdgInt = constrain(hdgInt + err * hdt, -40.0f, 40.0f);
        float c = constrain(trimF + headHoldKp * err + headHoldKi * hdgInt, -0.45f, 0.45f);
        if (cmd.endsWith("_back")) c = -c;  // walking backward, the same stride change turns the other way
        if (c > 0) scaleL = 1 - c; else scaleR = 1 + c;  // (only shorter strides: never past the tuned ones)
        headErrNow = err;
        headCorrNow = c;
        headHoldActive = true;
      } else {
        holdCmd = "";
        if (trimF > 0) scaleL = 1 - trimF; else scaleR = 1 + trimF;  // (the gyro off: just the trim)
        headErrNow = headCorrNow = 0;
        headHoldActive = false;
      }
      // The level-gait: the body parallel to the ground
      const bool levelCmd = cmd.startsWith("smooth_steady_level") || balCmd;
      if (levelCmd && imuOk) {
        static unsigned long lvlMs = 0;
        static String lvlCmd = "";
        const bool lvlGap = currentMillis - lvlMs > 500;  // (stopped in between: a fresh start)
        const float ldt = min(currentMillis - lvlMs, 100UL) / 1000.0f;
        lvlMs = currentMillis;
        const float pitch = asinf(constrain(imuAcc[1], -1.0f, 1.0f)) * 57.2958f;  // + = nose down (ay > 0: tipped forward)
        static float lvlI = 0;
        if (cmd != lvlCmd || lvlGap) { lvlCmd = cmd; levelPitch = pitch; lvlI = 0; }  // (the last walk's correction: not carried into this one)
        levelPitch += (pitch - levelPitch) * min(1.0f, ldt / 0.5f);  // (smoothed: the steps shake it)
        const float err = levelPitch - levelTrim;
        lvlI = constrain(lvlI + 1.2f * err * ldt, -15.0f, 15.0f);  // slow and steady: ~1.2 deg/s per deg off
        levelCorr = constrain(lvlI + 0.25f * err, -15.0f, 15.0f);
        for (int i = 0; i < 8; i++) {
          levelOff[i] = 0;
          if (i != 2 && i != 3 && i != 6 && i != 7) continue;  // knees: 2 L3 front, 3 L4 back, 6 R3 front, 7 R4 back
          const int e = sw_servos[i];
          const float down = POSE_REST[e] > POSE_STAND[e] ? 1.0f : -1.0f;  // this knee's "lower the corner" way
          const bool front = i == 2 || i == 6;
          levelOff[i] = (front ? -down : down) * levelCorr * 0.5f;  // nose down: front up, back down
        }
      } else if (!levelCmd) {
        for (int i = 0; i < 8; i++) levelOff[i] = 0;
      }
      // The steady gait's soft start: the strides grow over ~1.2 s (eased)
      float env = 1;
      if (isSteady(cmd)) {
        const float u = min(1.0f, (currentMillis - blendMs) / 1200.0f);
        env = u * u * (3 - 2 * u);
      }
      // walking sideways the "left" / "right" sides of the gait (for the heading hold) are the back / front pairs:
      // going left the back legs play the gait's left side, going right the front legs (sideGaitFill's roles)
      const bool sideL = cmd == "smooth_side_left";
      for (int i = 0; i < 8; i++) {
        float amp = sw_amp_mapped[i] * env;
        if (cmd == "smooth_nav") {  // skid steer by (navVx, navWz), the whole stride faded in by the command's size
          const float way = navVx < -0.01f ? -1.0f : 1.0f;
          const float v = fabsf(navVx) / NAV_VX_FULL, w = navWz / NAV_WZ_FULL * way;
          const float gate = min(1.0f, sqrtf(navVx * navVx + 0.0625f * navWz * navWz) / NAV_GATE_FULL);
          if (i == 0 || i == 1) amp *= constrain(v - w, -1.0f, 1.0f);
          else if (i == 4 || i == 5) amp *= constrain(v + w, -1.0f, 1.0f);
          amp *= gate;
        }
        if (sideCmd) {
          const bool back = i == 1 || i == 5, front = i == 0 || i == 4;
          if ((sideL && back) || (!sideL && front)) amp *= scaleL;
          if ((sideL && front) || (!sideL && back)) amp *= scaleR;
        } else {
          if (i == 0 || i == 1) amp *= scaleL;
          if (i == 4 || i == 5) amp *= scaleR;
        }
        float cw = cos(sw_frequency * sw_innerTime + sw_phase[i]);
        if (sw_rect[i] && cw < 0) cw = 0;
        if (sw_snap[i]) cw = sqrtf(cw);
        float angle = sw_base[i] + levelOff[i] + amp * cw;
        if (be < 1) {
          const float from = liveBlend ? lbBase[i] + lbAmp[i] * cos(lbFreq * sw_innerTime + lbPhase[i]) : blendFrom[i];
          angle = from + (angle - from) * be;
        }
        setServoAngle(sw_servos[i], (int)lroundf(angle));
      }
      // Gait phase for the Explore camera motion check
      double ph = fmod((double)sw_frequency * (double)sw_innerTime, 6.283185307);
      if (ph < 0) ph += 6.283185307;
      cpgPhase = (float)ph;
      cpgPeriodMs = 6.283185307f / fabsf(sw_frequency) / cpgSpeed;
      // the gait just used (for the next switch's live cross-fade)
      memcpy(cpgLastBase, sw_base, sizeof(cpgLastBase));
      memcpy(cpgLastAmp, sw_amp_mapped, sizeof(cpgLastAmp));
      memcpy(cpgLastPhase, sw_phase, sizeof(cpgLastPhase));
      cpgLastFreq = sw_frequency;
      cpgLastValid = true;
    }
  }
  if (activeMode != MODE_EXPLORE) cpgGait = GAIT_NONE;
  else if (exHeadAway() || millis() - exHeadMovedMs < 250) cpgGait = GAIT_GLANCE;  // head not straight ahead / moving
  else cpgGait = (currentCommand.startsWith("smooth_") || currentCommand.startsWith("step_") || currentCommand.startsWith("sharp_")) ? exGaitId : GAIT_NONE;

  // The steady gait let go: the strides shrink to nothing over 0.5 s (the CPG keeps its rhythm), then
  // the stand below - not a snap from mid-step
  static String gaitWas = "";
  // (fallen: none of the stop moves below - the fall turned the legs off, a stand pose would power them up again on its side)
  if (isSteady(gaitWas) && !currentCommand.startsWith("smooth_") && sw_oldMillis != 0 && !robotFallen) {
    const unsigned long t0 = millis();
    unsigned long last = t0;
    while (millis() - t0 < 500 && currentCommand == "") {
      const unsigned long nowMs = millis();
      sw_innerTime += (nowMs - last) * (double)cpgSpeed;
      last = nowMs;
      const float u = 1.0f - (nowMs - t0) / 500.0f, e = u * u * (3 - 2 * u);
      for (int i = 0; i < 8; i++) {
        float cw = cos(sw_frequency * sw_innerTime + sw_phase[i]);
        if (sw_rect[i] && cw < 0) cw = 0;
        if (sw_snap[i]) cw = sqrtf(cw);
        setServoAngle(sw_servos[i], (int)lroundf(sw_base[i] + levelOff[i] * e + sw_amp_mapped[i] * e * cw));
      }
      vTaskDelay(pdMS_TO_TICKS(15));
    }
  }
  gaitWas = currentCommand;
  bool isWalking = currentCommand.startsWith("smooth_");
  if (!isWalking) headHoldActive = false;
  if (!isWalking) {
    if (sw_oldMillis != 0 && !robotFallen) {
      runStandPose(0);
    }
    sw_oldMillis = 0;
    cpgLastValid = false;
  }
  if (sharpActive && !currentCommand.startsWith("sharp_")) {  // Sharp L / R let go: ease back to the stand
    sharpActive = false;
    if (currentCommand == "" && !robotFallen) runStandPose(0);
  }
  if (stepTurnFrame >= 0 && !currentCommand.startsWith("step_")) {
    stepTurnFrame = -1;
    if (!isWalking && !robotFallen) runStandPose(0);  // the creator's turn ends standing, like the D-pad
  }
  
  if (currentCommand == "" && activeMode == MODE_WALK && !robotFallen) {
    if (lastCommand == "forward" || lastCommand == "backward" || lastCommand == "left" || lastCommand == "right" || lastCommand == "patted") {
      runStandPose(1);
    }
  }
  lastCommand = currentCommand;
  balanceUpdate();
  govMark(GS_CMDS);

  vTaskDelay(pdMS_TO_TICKS(saverIdle ? 30 : 10));  // battery saver at rest: fewer loop passes
}
