grim0000/oreo/firmware/src/desk_moves_table.h

// SPDX-License-Identifier: GPL-3.0-or-later
// Copyright (C) 2026 Sunil J and the Oreo contributors
// Desk mode's body moves (keyframes).
// Per key: time (s), on the half-stand (1) or from the sit (0), then per leg FR FL RR RL: hip fwd (deg, + = foot
// forward) and knee bend (deg, + = folded further: that corner lower, or the foot up when it carries nothing).
#pragma once
namespace deskbody {
struct LKey { float t; uint8_t half; int8_t fwd[4]; int8_t bend[4]; };
static const LKey K_lean_l[] = {{0.000f, 0, {0, 0, 0, 0}, {0, 0, 0, 0}}, {0.500f, 1, {0, 0, 0, 0}, {0, 0, 0, 0}}, {1.000f, 1, {0, 0, 0, 0}, {-18, 22, -18, 22}}, {2.000f, 1, {0, 0, 0, 0}, {-18, 22, -18, 22}}, {2.500f, 1, {0, 0, 0, 0}, {0, 0, 0, 0}}, {3.100f, 0, {0, 0, 0, 0}, {0, 0, 0, 0}}};
static const LKey K_lean_r[] = {{0.000f, 0, {0, 0, 0, 0}, {0, 0, 0, 0}}, {0.500f, 1, {0, 0, 0, 0}, {0, 0, 0, 0}}, {1.000f, 1, {0, 0, 0, 0}, {22, -18, 22, -18}}, {2.000f, 1, {0, 0, 0, 0}, {22, -18, 22, -18}}, {2.500f, 1, {0, 0, 0, 0}, {0, 0, 0, 0}}, {3.100f, 0, {0, 0, 0, 0}, {0, 0, 0, 0}}};
static const LKey K_lean_f[] = {{0.000f, 0, {0, 0, 0, 0}, {0, 0, 0, 0}}, {0.600f, 1, {0, 0, 0, 0}, {-25, -25, 0, 0}}, {2.000f, 1, {0, 0, 0, 0}, {-25, -25, 0, 0}}, {2.600f, 0, {0, 0, 0, 0}, {0, 0, 0, 0}}};
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
}  // namespace deskbody
