grim0000/oreo/(commit log)

2026-10-31 Oreo v1.0: open-source four-legged desk robot
    ESP32-S3 quadruped with a face display, camera, voice chat and a printable body.
    - firmware/: walk engine (Level-Gait, Diagonal Trot), Explore and Life modes, desk mode,
    face engine, camera + face recognition, Gemini Live voice chat, "hey Oreo" wake word,
    phone controller over HTTP/HTTPS, battery % from measured run time
    - hardware/: Fusion 360 design, STLs and a Bambu Studio 3MF with 4 plates
    - gait/: the walk engine as one header (PCA9685 or direct servos) with examples
    - sd/: SD card files, including the trained wake word models
    - HANDBOOK: parts list, wiring diagram drawn from the real boards, step-by-step
    assembly pages, calibration a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
    [FL_femur.stl, FL_foot.stl, FL_knee_servo.stl, FR_femur.stl, FR_foot.stl, FR_knee_servo.stl, Oreo(sesame_remixed).f3d, Oreo_all_parts.3mf]
2026-11-02 3MF: pan bracket printed as two separate holders, updated plate layout
    [Oreo_all_parts.3mf]
2026-11-02 Wiring: INMP441 drawn as the real module (two 3-pin tabs, labels beside the pins)
2026-11-02 Legs from the current design; servo models moved to their own folder
    - Femurs and feet re-exported from the current Fusion design: the back femurs (R2, L2) no longer
    have the old filleted screw holes. Swapped into Oreo_all_parts.3mf in place (plates and layout kept)
    - The servo STLs (reference only, not printed) are now in hardware/assembly_parts/servos_reference/
    - Handbook drawings with the legs re-rendered
    [FL_femur.stl, FL_foot.stl, FL_knee_servo.stl, FR_femur.stl, FR_foot.stl, FR_knee_servo.stl, Oreo_all_parts.3mf, RL_femur.stl]
2026-11-02 Servos never driven past the MG90S's travel; calibration advice from the emote simulation
    - setServoAngle clamps every leg command to -19..150 (the MG90S's travel on the page's scale), so a Min / Max
    captured past where the servo stops can't hold it against its internal end stop
    - Handbook section 7: capture only poses the servo really reaches; all 203 emotes checked in the physics sim on
    robots with horns up to a tooth off and a few degrees of calibration error: no falls
    [main.cpp]
2026-11-02 Emotes: a raised front paw only goes up from the wave's lean; emote library in the Drive tab
    - Paw guard in the emote helper: any emote that holds one front paw up (high five, hello wave, give paw,
    stop sign, beckon, point, bye...: 37 in all) first leans onto the other three legs like the standard wave,
    moves only that leg while it is up, and puts it down before the lean is undone - they no longer tip forward
    onto the raised corner. Quick taps (stomp, march) are unchanged
    - Controller: the Emote Library is in the Drive tab under its own heading (it was left loose under every tab)
    [emotes_more.h, movement-sequences.h]
2026-11-03 Docs: the camera is an OV3660, not an OV2640 (handbook parts list, wiring diagram)
2026-11-03 Handbook: foam tape over the XL4015, MPU6050 and OLED so nothing bare touches the deck boards (step 5 drawing + note)
2026-11-04 Neck tilt arms: one clean sketch+extrude per side on the tilt-servo axis (no steps or slivers), horn pocket centred on the shaft; 3MF updated
    [Oreo(sesame_remixed).f3d, Oreo_all_parts.3mf, neck_pan_bracket.stl]
2026-11-04 Neck tilt arm R: horn pocket cut open over the servo shaft (the rim had covered the hub); arm chamfers; 3MF updated
    [Oreo(sesame_remixed).f3d, Oreo_all_parts.3mf, neck_pan_bracket.stl]
